Annex-Engineering/Masherbrum-K1/Release_2_2/Images/1800px_k2_r2_render_toolhead_lower.png

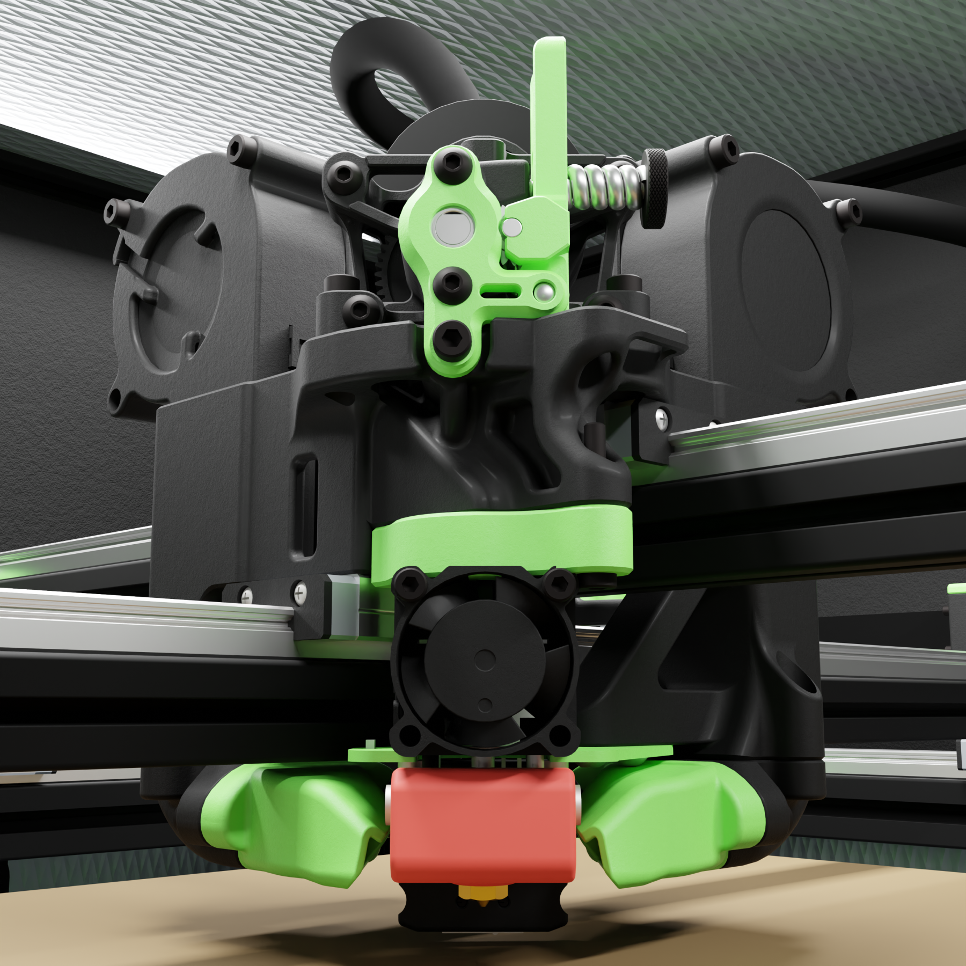
Release_2_2/Images/1800px_k2_r2_render_toolhead_lower.png
