Annex-Engineering/Masherbrum-K1/README.md

# Masherbrum (K1) Printer

## Please Note: As of 04-09-2024, The Final Release of K1 is: Release 3 for XY Gantry and Release 2.2 for Z Drive, What you See is What you Get

## Info:
Project Masherbrum (K1 for short) is a Medium Format, Direct Drive, Fully Enclosed FDM Printer.

This is an entirely scratch design, based on the efforts of the "Hypercube Overkill Project" for the XY Motion System, and inspired by all other prior repraps.

Our discord server can be found here: 

Join me on Discord (https://discord.gg/MzTR3zE)

BOM/Sourcing Guide for a 250x250x250 Build can be found here: https://docs.google.com/spreadsheets/d/1O3eyVuQ6M4F03MJSDs4Z71_XyNjXL5HFTZr1jsaAtRc/edit?usp=sharing

Frame Calculator: https://docs.google.com/spreadsheets/d/1OafYgwpRugKy69tp4yEFCRedxJVDkKtnEzjKQJuyjoY/edit?usp=sharing

## Stats:
- Fully Enclosed Design
- 2020, 2040, and 4040 Frame Members
- Insulated Build Chamber (Not Heated)
- Build Volumes of ~200^3 to 500^3 (use of whole plate available) + additional area to purge and wipe
     - Z can theoretically be 1m tall, just not fully supported or tested

- Direct Drive Extruder (Sherpa Mini)

- Shortest Belt Paths Possible, 4 Motors, 2 Per X, 2 Per Y Axis
- Moving Gantry, Fixed Bed

- MGN12H Rails for XY Stationary Rails
- MGN15H Rails for XY Cross (Moving Members)
- MGN15H Rails for Z
- Laser cut and machined metal parts throughout for stiffness and strength (steel recommended in most places, aluminum on moving components)
- 20mm 2GT Belts on XY Motion 
- 20mm 2GT Belts with 20:1 Worm Drive on Z to lift the Bed 
- Heavy Duty Bearings
- NEMA17 Motors XYZ

- Minimal Printed Parts (ASA Required, PC Recommended for motion components)

- Fysetc Spider or S6 Controller + BTT Expander Board with Klipper Required
- Mosquito Style, Dragon Style, Mosquito Magnum+, Nitram's VolcoMosquito, and many other hotends supported
- 24V Power Standard, 48V Optional and Preferred
- Mains Bed
