Annex-Engineering/Masherbrum-K1/Release_1.2/README.md

# Masherbrum (K1) Printer

These parts are purely pre-release at this point, please use with caution.

use tab 2 on the frame calculator for this release, please use discord for support
