Annex-Engineering/Masherbrum-K1/Release_2_2/Images/K1_ISO_CAD_1.PNG

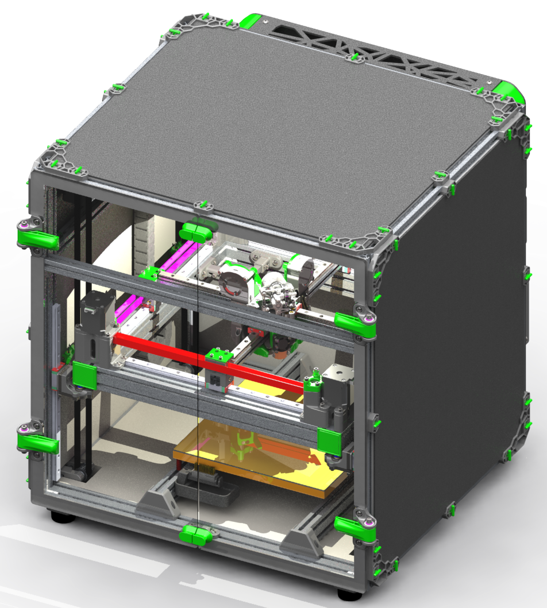
Release_2_2/Images/K1_ISO_CAD_1.PNG
