Annex-Engineering/Masherbrum-K1/Release_3_0/DXFs/Toolhead/toolhead_main_plate_sherpa_mini_x2_rev4_2mm_aluminum.DXF

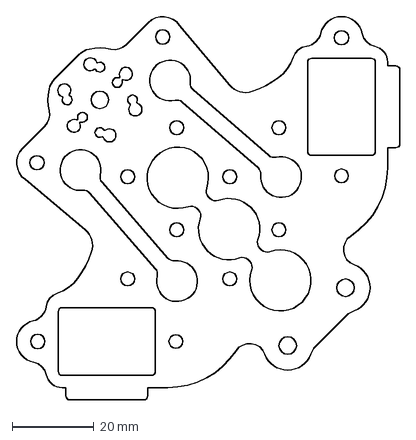
[picture p4: CAD file, 2023-02-20]
Release_3_0/DXFs/Toolhead/toolhead_main_plate_sherpa_mini_x2_rev4_2mm_aluminum.DXF
93.9 x 93.9 mm
