Annex-Engineering/Masherbrum-K1/Release_3_0/STLs/Electronics_Box/electronics_box_corner_mains_inlet_x1_rev4.STL

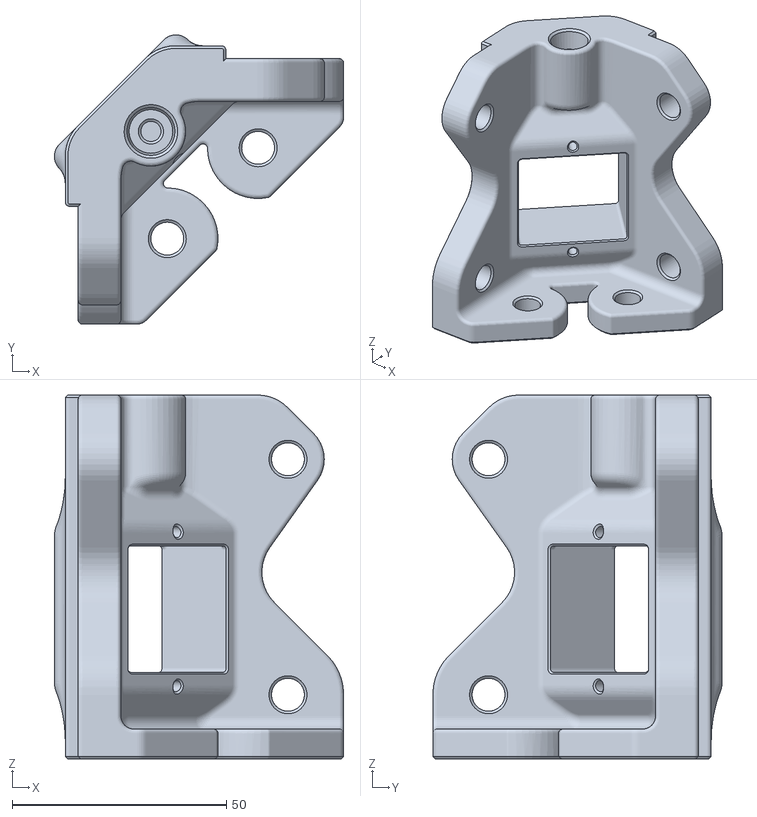
[picture p5: CAD file, 2022-12-18]
Release_3_0/STLs/Electronics_Box/electronics_box_corner_mains_inlet_x1_rev4.STL
67.6 x 67.6 x 85.0
