Annex-Engineering/Masherbrum-K1/Release_3_0/DXFs/15mm_3HTD_Belted_Z_Drive/3mm_stainless_z_bearing_block_main_plate_x4_rev1.DXF

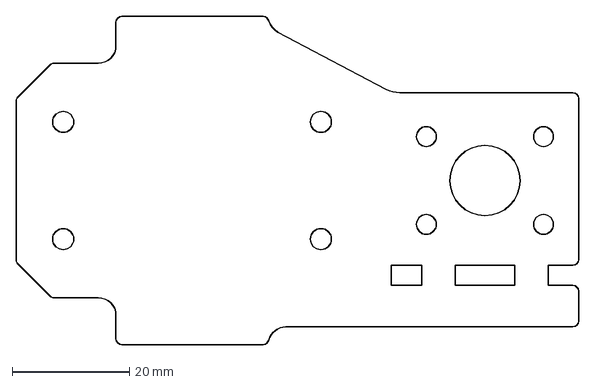
[picture p6: CAD file, 2021-10-04]
Release_3_0/DXFs/15mm_3HTD_Belted_Z_Drive/3mm_stainless_z_bearing_block_main_plate_x4_rev1.DXF
96.0 x 56.0 mm
