Annex-Engineering/Masherbrum-K1/Release_3_0/DXFs/15mm_3HTD_Belted_Z_Drive/4.8mm_aluminum_z_bearing_block_main_plate_x4_rev1.DXF

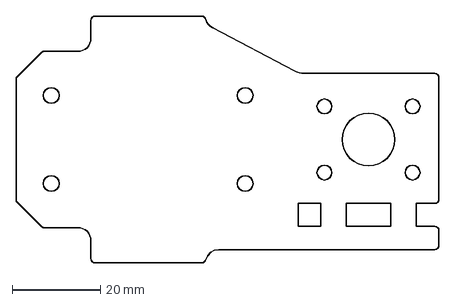
[picture p7: CAD file, 2021-08-31]
Release_3_0/DXFs/15mm_3HTD_Belted_Z_Drive/4.8mm_aluminum_z_bearing_block_main_plate_x4_rev1.DXF
96.0 x 56.0 mm
