Annex-Engineering/Masherbrum-K1/DXFs/Panels/Back_Panel_400mm_x_400mm_x_600mm_Rev1.DXF

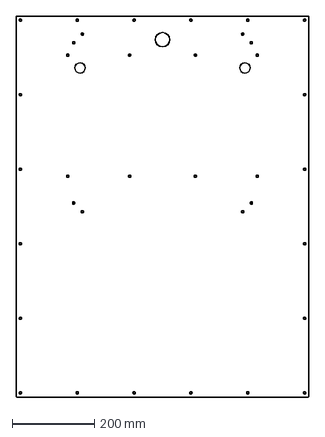
[picture p8: CAD file, 2020-07-09]
DXFs/Panels/Back_Panel_400mm_x_400mm_x_600mm_Rev1.DXF
710.0 x 925.0 mm
