Annex-Engineering/Masherbrum-K1/DXFs/Skirts/Side_Skirt_250mm_x2_Rev3.DXF

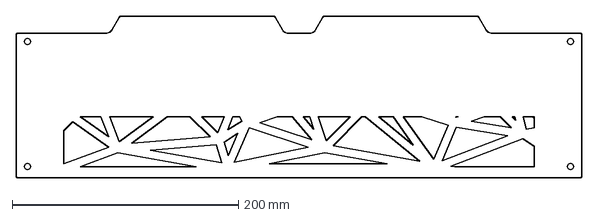
[picture p9: CAD file, 2020-03-29]
DXFs/Skirts/Side_Skirt_250mm_x2_Rev3.DXF
500.0 x 143.0 mm
