Annex-Engineering/Masherbrum-K1/Release_1.2/DXFs/Doors/Triple_Hinge/Front_Door_400mm_x2_Rev2.DXF

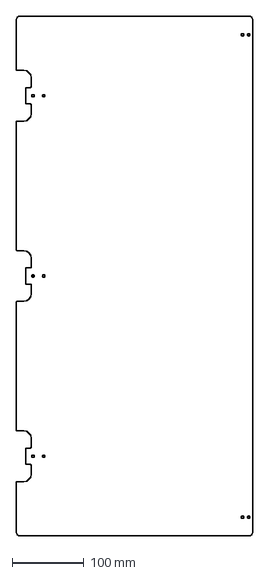
[picture p11: CAD file, 2021-01-07]
Release_1.2/DXFs/Doors/Triple_Hinge/Front_Door_400mm_x2_Rev2.DXF
329.5 x 725.0 mm
