Annex-Engineering/Masherbrum-K1/Release_1.2/STLs/Mesh_Bed_Probe/Magnetic_Probe/magnetic_probe_dock_x1_rev5.STL

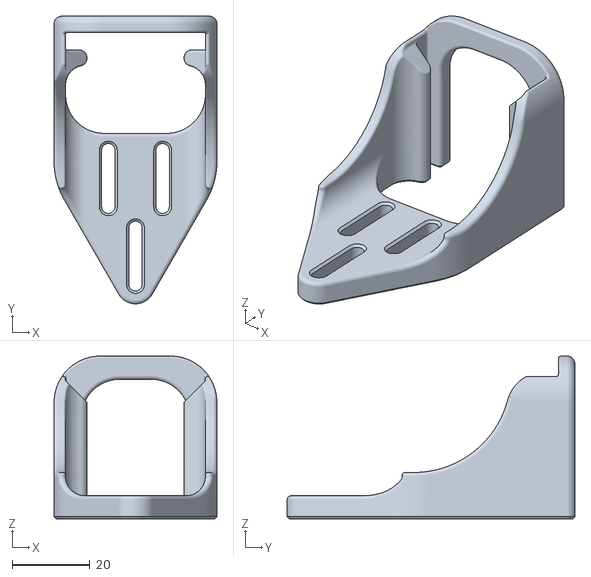
[picture p12: CAD file, 2020-08-14]
Release_1.2/STLs/Mesh_Bed_Probe/Magnetic_Probe/magnetic_probe_dock_x1_rev5.STL
42.0 x 74.1 x 42.0
