Annex-Engineering/Masherbrum-K1/Release_1.2/STLs/Mesh_Bed_Probe/Piton_Probe/[a]_piton_probe_plate_6x3_x1_rev2.STL

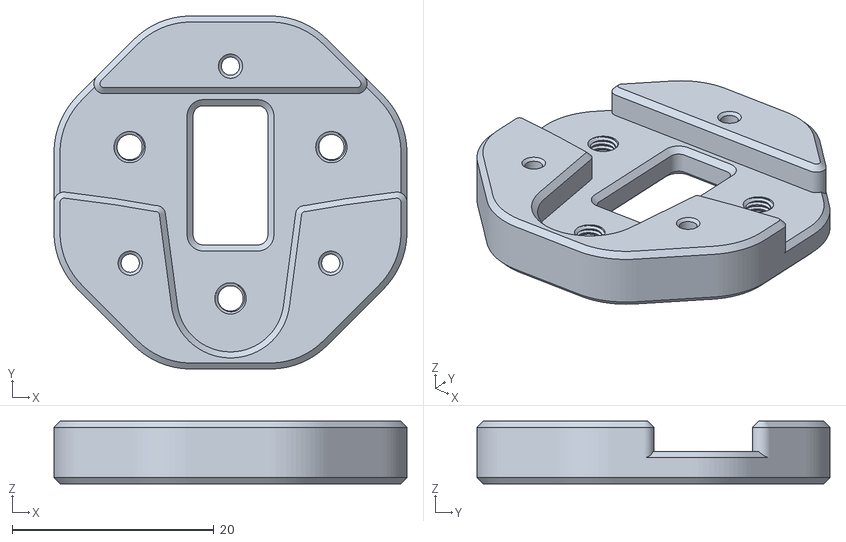
[picture p13: CAD file, 2020-11-18]
Release_1.2/STLs/Mesh_Bed_Probe/Piton_Probe/[a]_piton_probe_plate_6x3_x1_rev2.STL
35.0 x 35.0 x 6.20
