Annex-Engineering/Masherbrum-K1/Release_1.2/STLs/Misc/z_endstop_housing_x1_rev1.STL

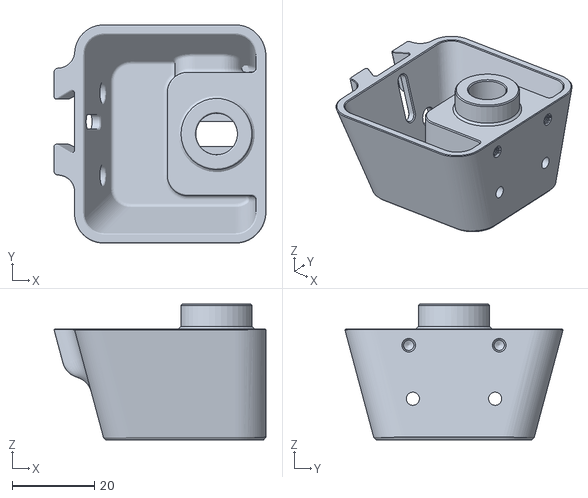
[picture p14: CAD file, 2020-05-19]
Release_1.2/STLs/Misc/z_endstop_housing_x1_rev1.STL
51.5 x 53.1 x 33.0
