Annex-Engineering/Masherbrum-K1/Release_1.2/STLs/XY_Carriage/Tool_Mounts/xy_carriage_mosquito_tool_mount_x1_rev3.STL

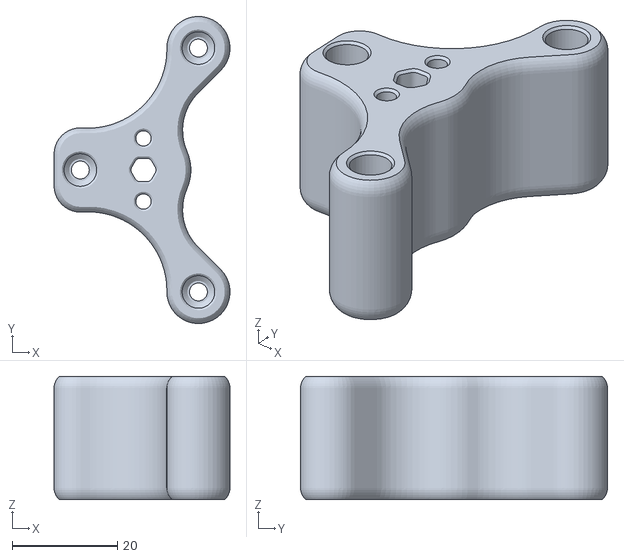
[picture p15: CAD file, 2020-04-10]
Release_1.2/STLs/XY_Carriage/Tool_Mounts/xy_carriage_mosquito_tool_mount_x1_rev3.STL
33.4 x 58.3 x 23.4
