Annex-Engineering/Masherbrum-K1/Release_1.2/STLs/XY_Carriage/Top_Plates/sherpa_tall_xy_carriage_top_plate_x1_rev1.STL

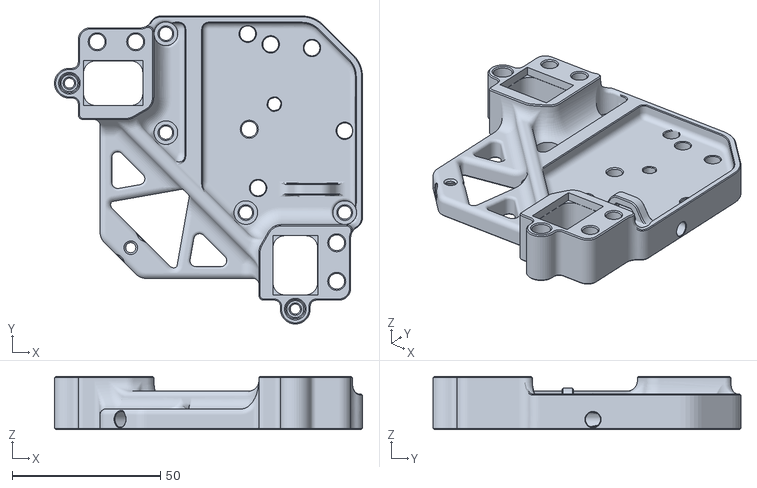
[picture p16: CAD file, 2020-07-09]
Release_1.2/STLs/XY_Carriage/Top_Plates/sherpa_tall_xy_carriage_top_plate_x1_rev1.STL
104.0 x 104.0 x 18.0
