Annex-Engineering/Masherbrum-K1/Release_1.2/STLs/XY_Carriage/xy_carriage_piton_probe_holder_mosquito_x1_rev3.STL

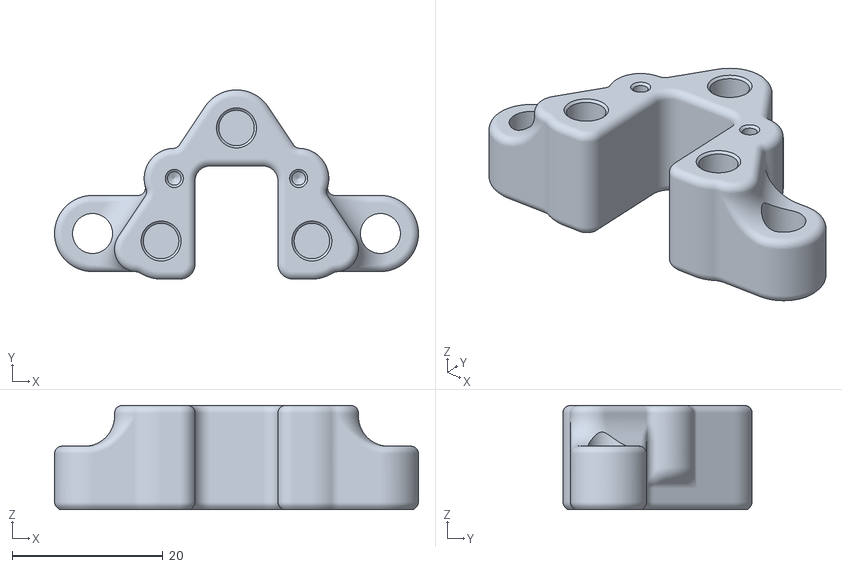
[picture p17: CAD file, 2020-11-18]
Release_1.2/STLs/XY_Carriage/xy_carriage_piton_probe_holder_mosquito_x1_rev3.STL
48.3 x 25.1 x 13.8
