Annex-Engineering/Masherbrum-K1/Release_1.2/STLs/XY_Gantry/xy_tensioner_left_20t_drive_x4_rev3.STL

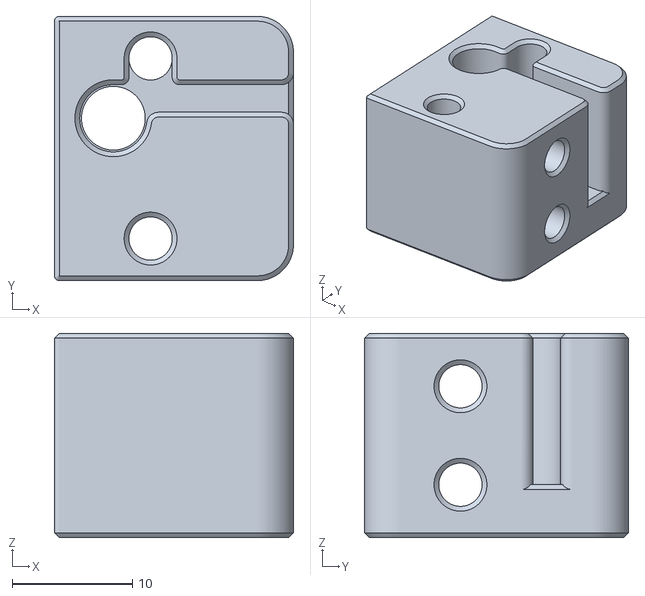
[picture p18: CAD file, 2020-10-04]
Release_1.2/STLs/XY_Gantry/xy_tensioner_left_20t_drive_x4_rev3.STL
19.9 x 22.0 x 17.0
