Annex-Engineering/Masherbrum-K1/Release_2/STLs/Electronics_Brackets/bigtreetech_skr_mounting_bracket_x2_rev4.STL

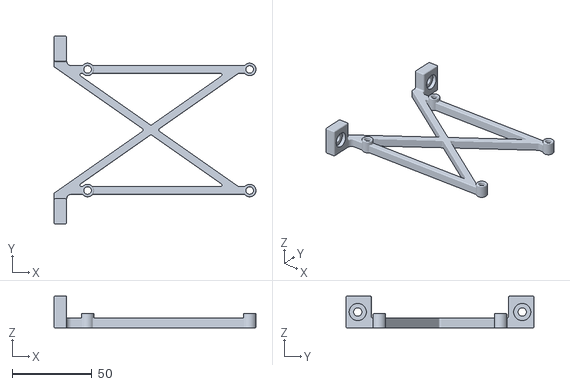
[picture p19: CAD file, 2021-05-18]
Release_2/STLs/Electronics_Brackets/bigtreetech_skr_mounting_bracket_x2_rev4.STL
127.0 x 118.3 x 20.0
