Annex-Engineering/Masherbrum-K1/Release_2_1/DXFs/15mm_3HTD_Belted_Z_Drive/3mm_stainless_belted_worm_z_metal_top_60to1_x4_rev2.DXF

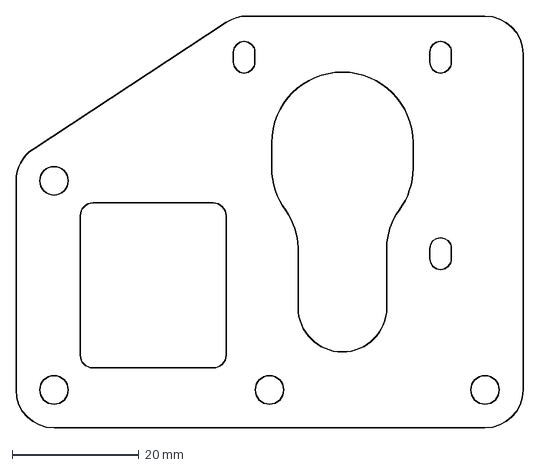
[picture p20: CAD file, 2022-01-22]
Release_2_1/DXFs/15mm_3HTD_Belted_Z_Drive/3mm_stainless_belted_worm_z_metal_top_60to1_x4_rev2.DXF
80.0 x 65.0 mm
