Annex-Engineering/Masherbrum-K1/Release_2_2/STLs/XY_Carriage/[a]_xy_carriage_fan_mount_1_x1_rev3.STL

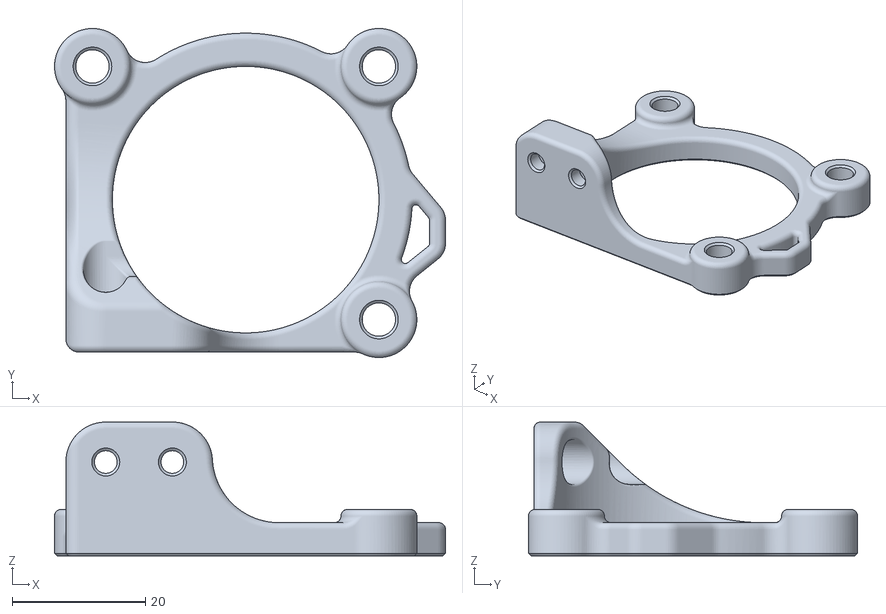
[picture p21: CAD file, 2021-07-12]
Release_2_2/STLs/XY_Carriage/[a]_xy_carriage_fan_mount_1_x1_rev3.STL
58.7 x 49.4 x 20.1
