Annex-Engineering/Masherbrum-K1/Release_2_2/STLs/XY_Carriage/Hotend_Holders/Mosquito_and_Mosquito_Mag+/[a]_xy_carriage_mosquito_tool_mount_x1_rev4.STL

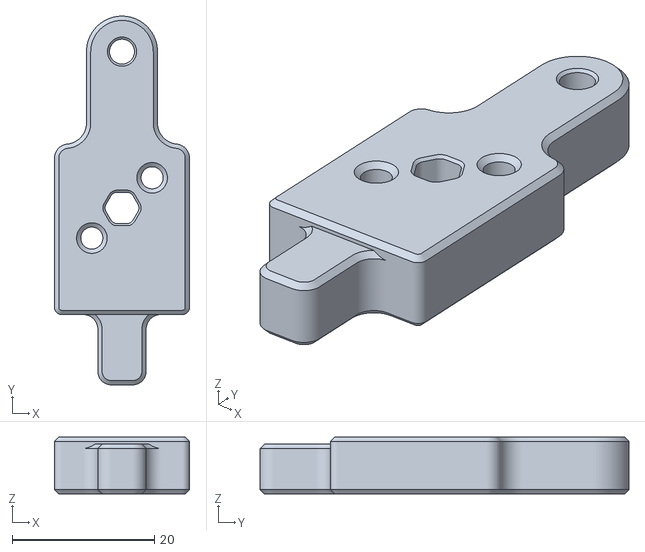
[picture p22: CAD file, 2020-11-21]
Release_2_2/STLs/XY_Carriage/Hotend_Holders/Mosquito_and_Mosquito_Mag+/[a]_xy_carriage_mosquito_tool_mount_x1_rev4.STL
19.0 x 51.9 x 8.00
