Annex-Engineering/Masherbrum-K1/Release_2_2/STLs/XY_Carriage/Hotend_Holders/Rapido_UHF/[a]_xy_carriage_rapido_uhf_tool_mount_x1_rev1.STL

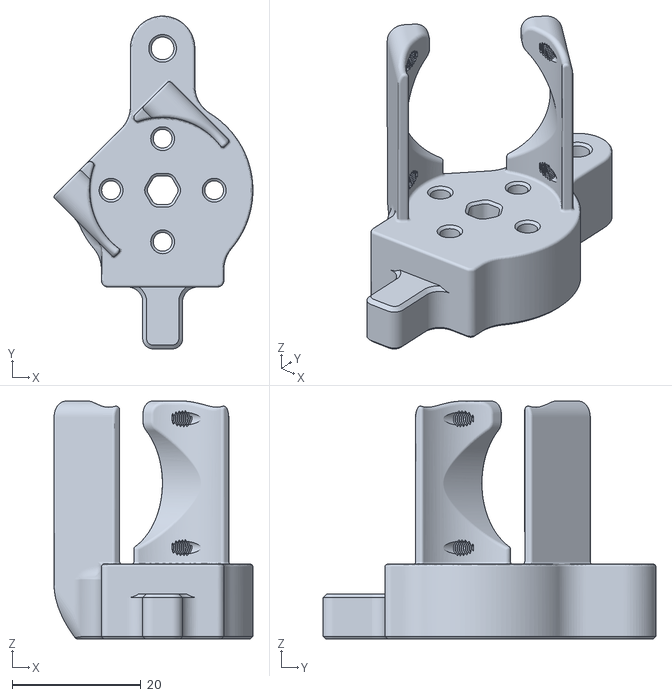
[picture p24: CAD file, 2021-12-29]
Release_2_2/STLs/XY_Carriage/Hotend_Holders/Rapido_UHF/[a]_xy_carriage_rapido_uhf_tool_mount_x1_rev1.STL
30.8 x 51.6 x 36.9
