Annex-Engineering/Masherbrum-K1/Release_2_2/STLs/XY_Carriage/Toolhead_Bottoms/Mosquito_and_Dragon/[a]_xy_carriage_std_fan_duct_1_x1_rev1.STL

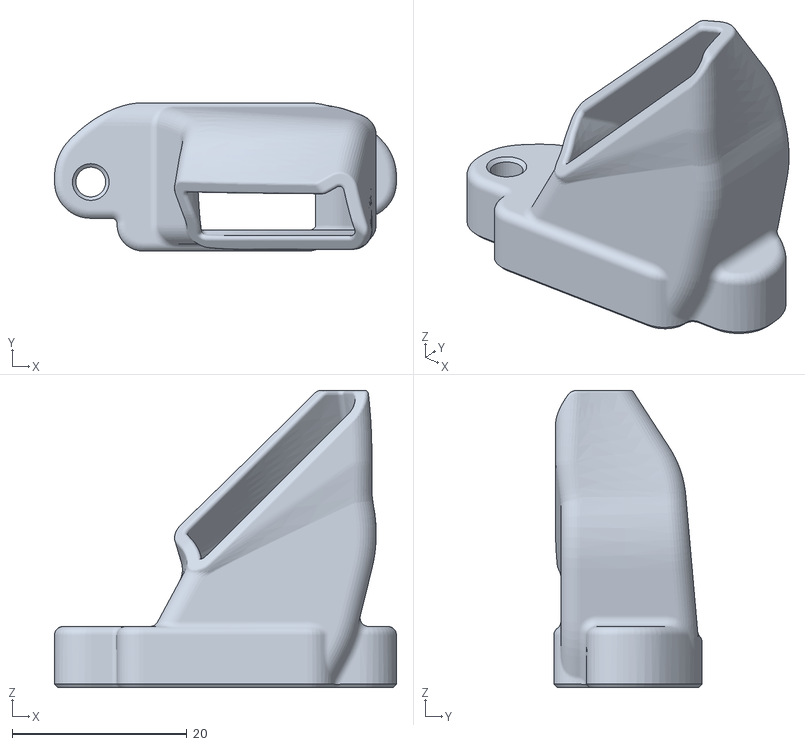
[picture p25: CAD file, 2021-01-26]
Release_2_2/STLs/XY_Carriage/Toolhead_Bottoms/Mosquito_and_Dragon/[a]_xy_carriage_std_fan_duct_1_x1_rev1.STL
39.1 x 17.0 x 34.0
