Annex-Engineering/Masherbrum-K1/Release_2_2/STLs/XY_Carriage/Toolhead_Bottoms/Mosquito_Mag+_and_Rapido_UHF/[a]_xy_carriage_mag+_fan_duct_2_x1_rev2.STL

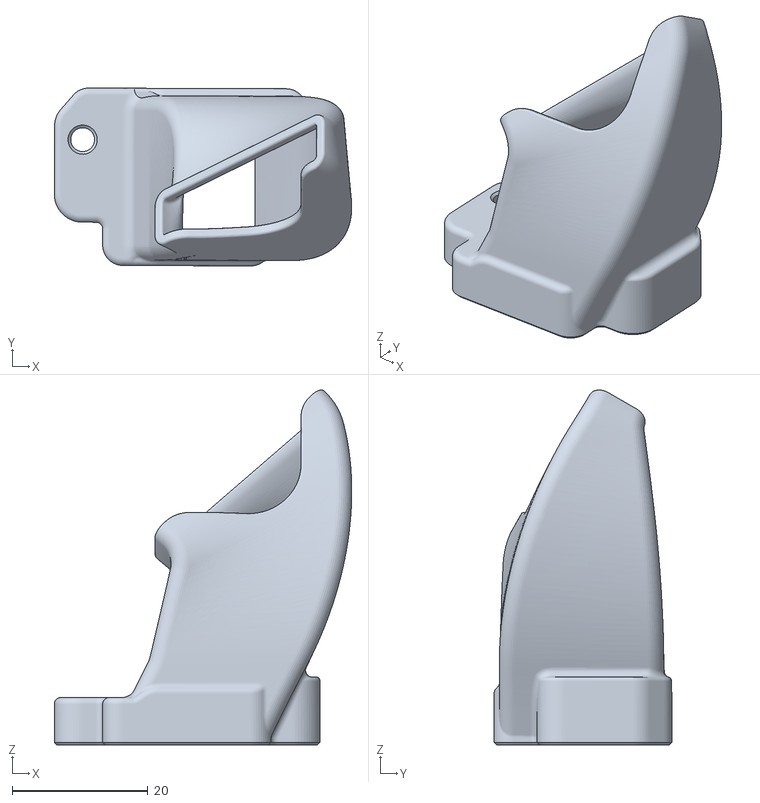
[picture p26: CAD file, 2021-08-19]
Release_2_2/STLs/XY_Carriage/Toolhead_Bottoms/Mosquito_Mag+_and_Rapido_UHF/[a]_xy_carriage_mag+_fan_duct_2_x1_rev2.STL
43.8 x 26.2 x 52.2
