Annex-Engineering/Masherbrum-K1/Release_2_2/STLs/XY_Carriage/Toolhead_Bottoms/VolcoMosquito_and_Rapido_StandardFlow/[a]_xy_carriage_volcomosquito_fan_duct_1_x1_rev1.STL

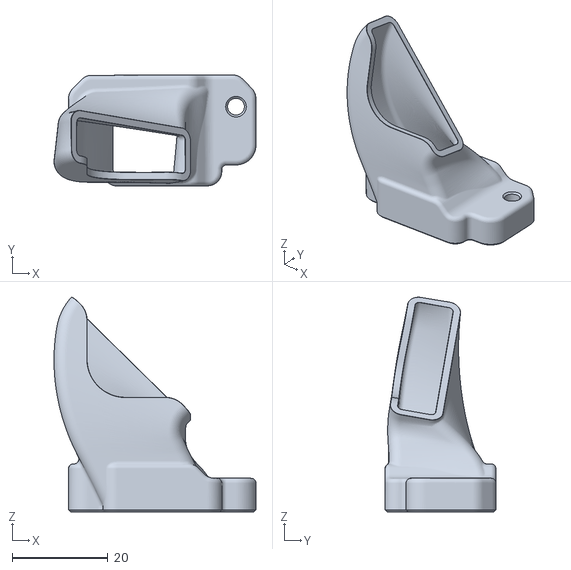
[picture p27: CAD file, 2021-11-27]
Release_2_2/STLs/XY_Carriage/Toolhead_Bottoms/VolcoMosquito_and_Rapido_StandardFlow/[a]_xy_carriage_volcomosquito_fan_duct_1_x1_rev1.STL
42.1 x 23.2 x 44.8
