Annex-Engineering/Masherbrum-K1/Release_2_2/STLs/XY_Gantry/MGN12C_Stationary_Rails/xy_mgn12c_tensioner_right_20t_drive_12mm_belts_x4_rev3.STL

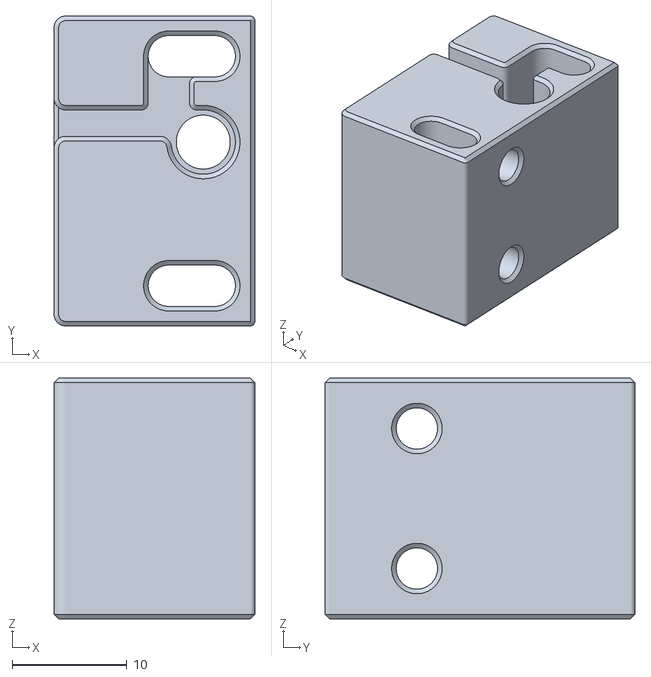
[picture p28: CAD file, 2021-03-03]
Release_2_2/STLs/XY_Gantry/MGN12C_Stationary_Rails/xy_mgn12c_tensioner_right_20t_drive_12mm_belts_x4_rev3.STL
17.5 x 27.0 x 21.0
