Annex-Engineering/Masherbrum-K1/Release_2_2/STLs/XY_Gantry/tall_motor_short_idler_mount_12mm_belts_x2_rev4.STL

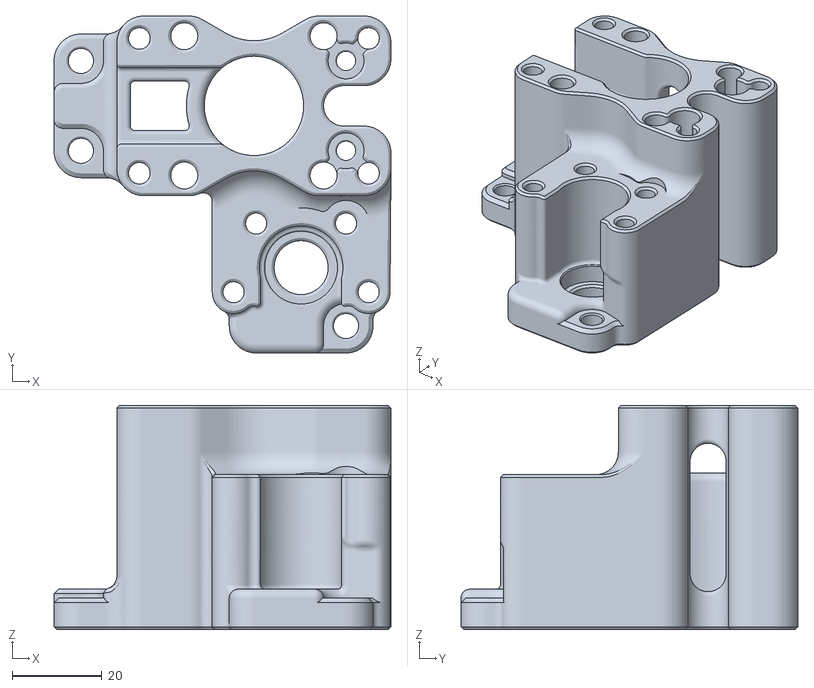
[picture p29: CAD file, 2021-07-18]
Release_2_2/STLs/XY_Gantry/tall_motor_short_idler_mount_12mm_belts_x2_rev4.STL
75.0 x 75.0 x 49.9
