Annex-Engineering/Masherbrum-K1/Release_2_Beta/DXFs/Doors/Double_Hinge/Front_Door_400mm_x2_Rev1.DXF

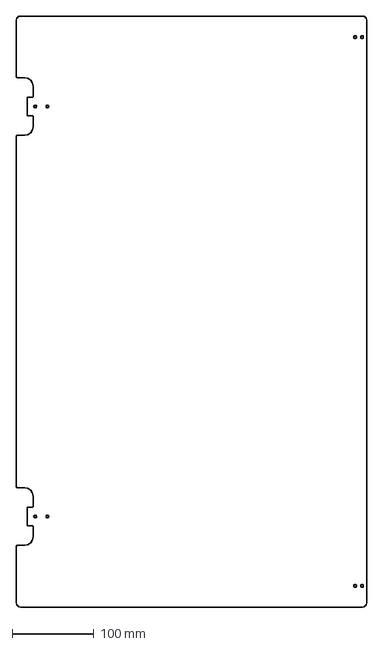
[picture p30: CAD file, 2020-11-09]
Release_2_Beta/DXFs/Doors/Double_Hinge/Front_Door_400mm_x2_Rev1.DXF
429.5 x 725.0 mm
