Annex-Engineering/Masherbrum-K1/Release_2_Beta/DXFs/Doors/Triple_Hinge/Front_Door_250mm_x_250mm_x_300mm_x2_Rev1.DXF

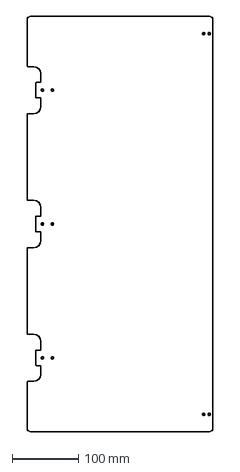
[picture p31: CAD file, 2020-12-31]
Release_2_Beta/DXFs/Doors/Triple_Hinge/Front_Door_250mm_x_250mm_x_300mm_x2_Rev1.DXF
279.5 x 625.0 mm
