Annex-Engineering/Masherbrum-K1/Release_2_Beta/STLs/XY_Carriage/[a]_xy_carriage_fan_mount_1_x1_rev1.STL

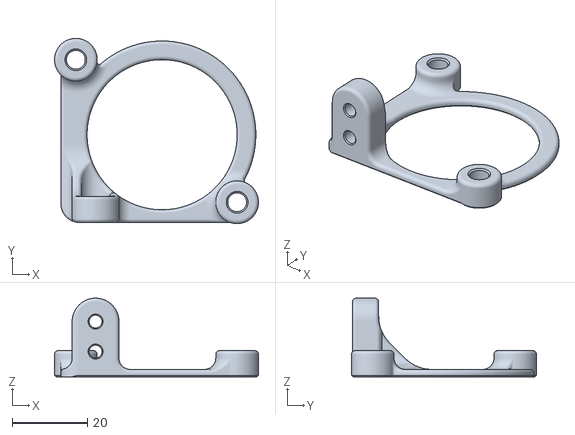
[picture p32: CAD file, 2020-11-21]
Release_2_Beta/STLs/XY_Carriage/[a]_xy_carriage_fan_mount_1_x1_rev1.STL
54.4 x 49.4 x 21.0
