Annex-Engineering/Masherbrum-K1/Release_3_0/DXFs/Doors/Double_Hinge/Front_Door_450mm_x2_Rev2.DXF

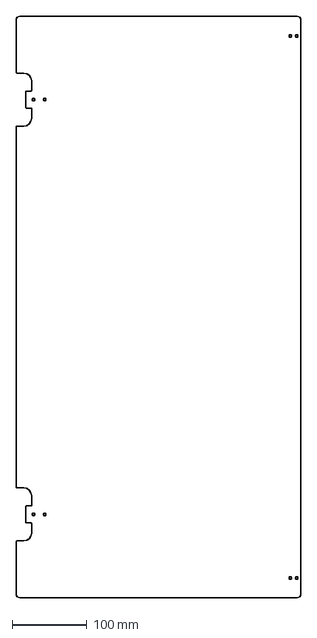
[picture p34: CAD file, 2021-01-11]
Release_3_0/DXFs/Doors/Double_Hinge/Front_Door_450mm_x2_Rev2.DXF
379.5 x 775.0 mm
