Annex-Engineering/Masherbrum-K1/Release_3_0/DXFs/Doors/Triple_Hinge/Front_Door_250mm_x_250mm_x_250mm_x2_Rev3.DXF

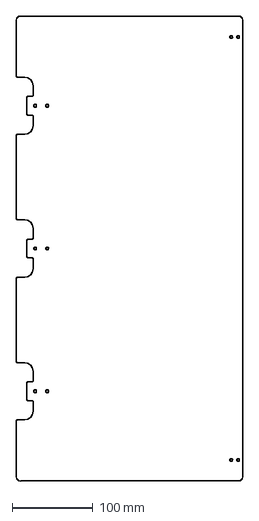
[picture p35: CAD file, 2021-01-11]
Release_3_0/DXFs/Doors/Triple_Hinge/Front_Door_250mm_x_250mm_x_250mm_x2_Rev3.DXF
279.5 x 575.0 mm
