Annex-Engineering/Masherbrum-K1/Release_3_0/DXFs/Doors/Triple_Hinge_with_Graphics/K1_doors_400mm^3_graphic_option_2.DXF

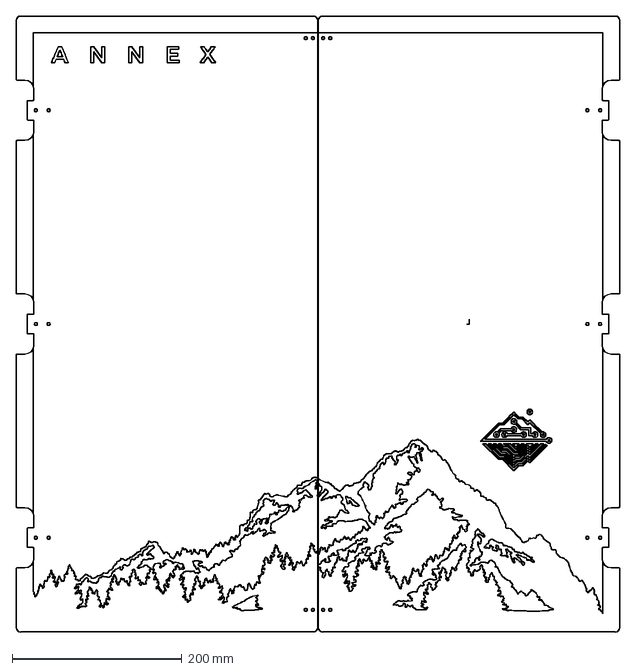
[picture p36: CAD file, 2022-03-22]
Release_3_0/DXFs/Doors/Triple_Hinge_with_Graphics/K1_doors_400mm^3_graphic_option_2.DXF
710.0 x 725.0 mm
