Annex-Engineering/Masherbrum-K1/Release_3_0/DXFs/Electronics_Box/electronics_box_side_structural_panel_x4_rev1.DXF

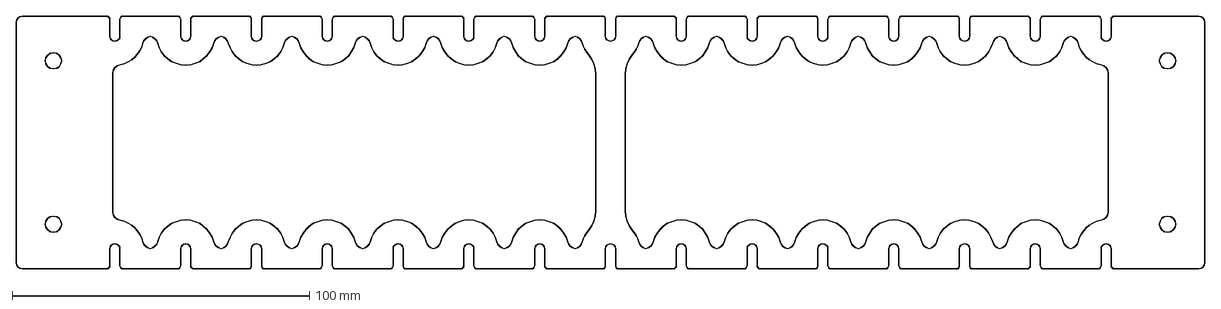
[picture p37: CAD file, 2022-03-02]
Release_3_0/DXFs/Electronics_Box/electronics_box_side_structural_panel_x4_rev1.DXF
400.0 x 85.0 mm
