Annex-Engineering/Masherbrum-K1/Release_3_0/DXFs/Panels/Back_Panel_400x400x600_Rev3.dxf

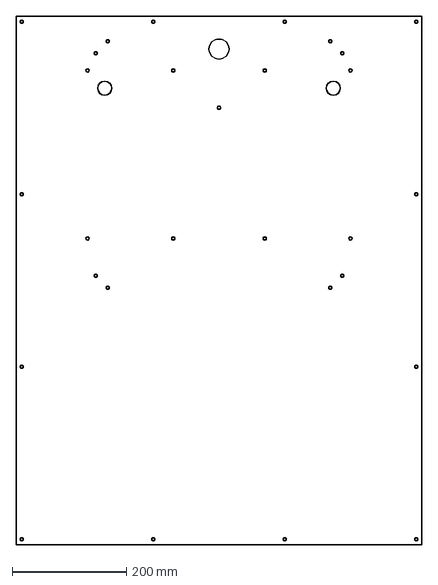
[picture p39: CAD file, 2021-05-25]
Release_3_0/DXFs/Panels/Back_Panel_400x400x600_Rev3.dxf
710.0 x 925.0 mm
