Annex-Engineering/Masherbrum-K1/Release_3_0/DXFs/XY_Gantry/xy_motor_mounting_plate_x4_rev1_2mm_steel.DXF

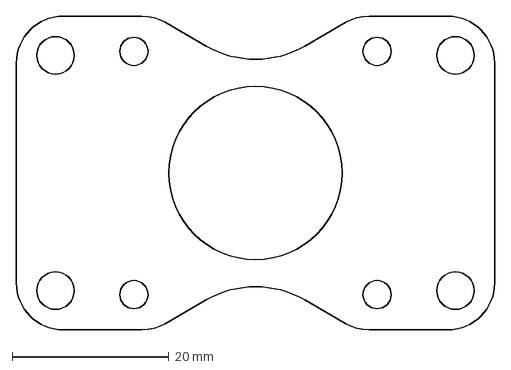
[picture p40: CAD file, 2022-11-29]
Release_3_0/DXFs/XY_Gantry/xy_motor_mounting_plate_x4_rev1_2mm_steel.DXF
61.0 x 40.0 mm
