Annex-Engineering/Masherbrum-K1/Release_3_0/PCBs/K1K2-carabiner-round_heatsink/K1+K2 Carabiner for Mosquito.step

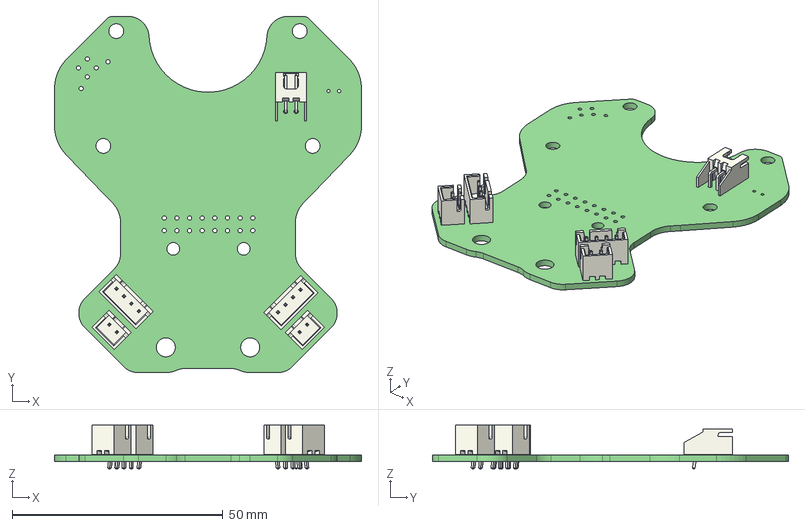
[picture p42: CAD file, 2024-04-17]
Release_3_0/PCBs/K1K2-carabiner-round_heatsink/K1+K2 Carabiner for Mosquito.step
72.8 x 84.5 x 10.4 mm
K1+K2 Carabiner for Round Heatsinks PCB
