Annex-Engineering/Masherbrum-K1/Release_3_0/STLs/Cable_Management/25x40mm_cable_channel_top_140mm_x3_rev2.STL

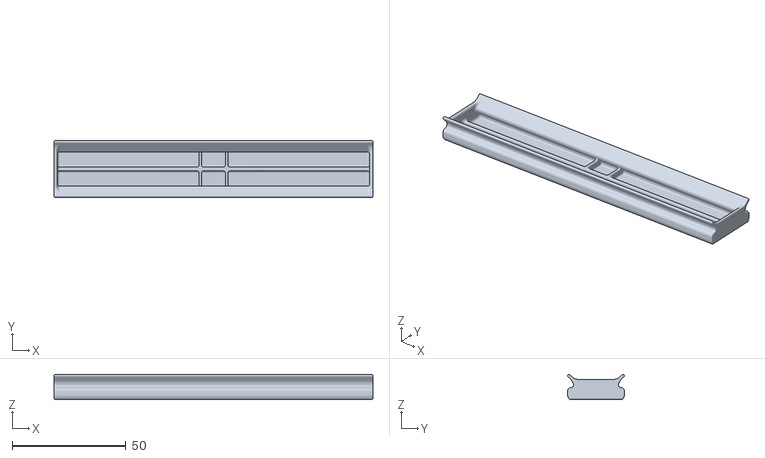
[picture p43: CAD file, 2022-01-19]
Release_3_0/STLs/Cable_Management/25x40mm_cable_channel_top_140mm_x3_rev2.STL
140.0 x 25.0 x 11.0
