Annex-Engineering/Masherbrum-K1/Release_3_0/STLs/Electronics_Brackets/universal_dual_meanwell_uhp_psu_mounting_bracket_b_x1_rev2.STL

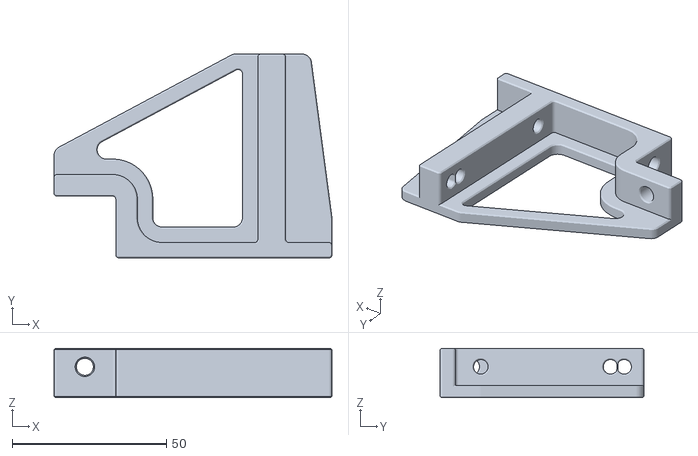
[picture p44: CAD file, 2022-02-16]
Release_3_0/STLs/Electronics_Brackets/universal_dual_meanwell_uhp_psu_mounting_bracket_b_x1_rev2.STL
90.0 x 66.0 x 16.0
