Annex-Engineering/Masherbrum-K1/Release_3_0/STLs/Jigs_and_Fixtures/[a]_1515_mgn12c_drilling_jig_x1_rev3.STL.stl

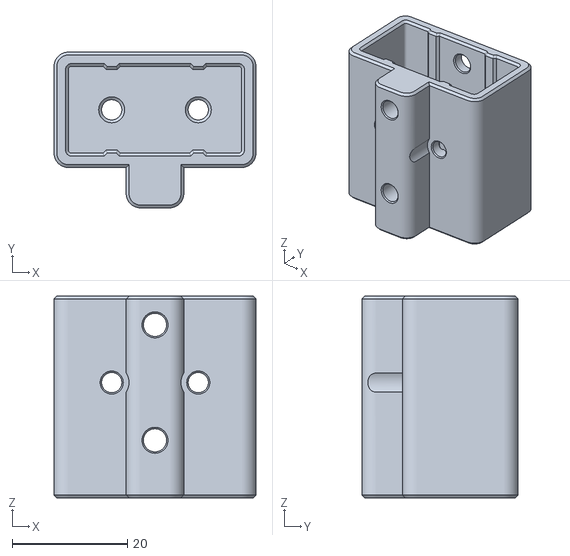
[picture p45: CAD file, 2022-02-08]
Release_3_0/STLs/Jigs_and_Fixtures/[a]_1515_mgn12c_drilling_jig_x1_rev3.STL.stl
35.0 x 27.0 x 35.0
