Annex-Engineering/Masherbrum-K1/Release_3_0/STLs/Misc/Foot_to_frame_bracket_laser_panel_x4_rev1.STL

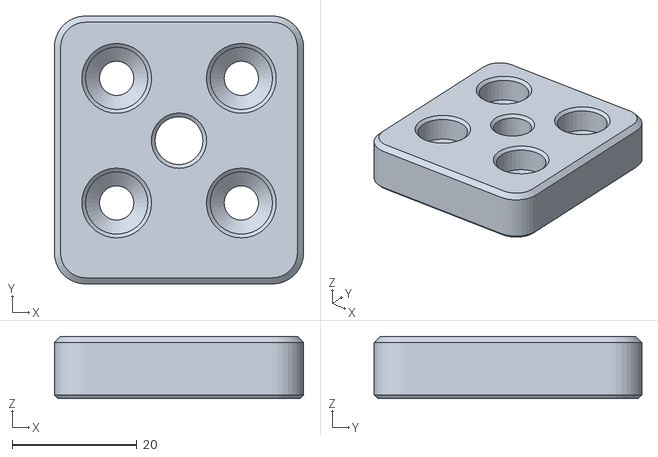
[picture p46: CAD file, 2022-05-06]
Release_3_0/STLs/Misc/Foot_to_frame_bracket_laser_panel_x4_rev1.STL
40.0 x 43.0 x 10.00
