Annex-Engineering/Masherbrum-K1/Release_3_0/STLs/Panel_Mounting/Front_Panel_Hinges_and_Locks/[a]_front_door_arm_x4_rev1.STL

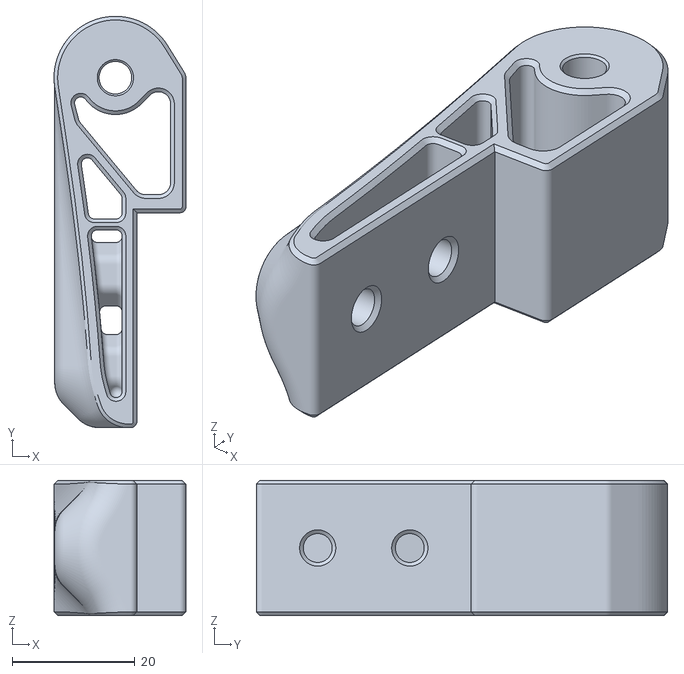
[picture p47: CAD file, 2020-11-09]
Release_3_0/STLs/Panel_Mounting/Front_Panel_Hinges_and_Locks/[a]_front_door_arm_x4_rev1.STL
21.5 x 67.0 x 22.0
