Annex-Engineering/Masherbrum-K1/Release_3_0/STLs/Panel_Mounting/Sides_and_Top_Quick_Release/lock_body_filament_switch_6mm_x1_Rev1.stl

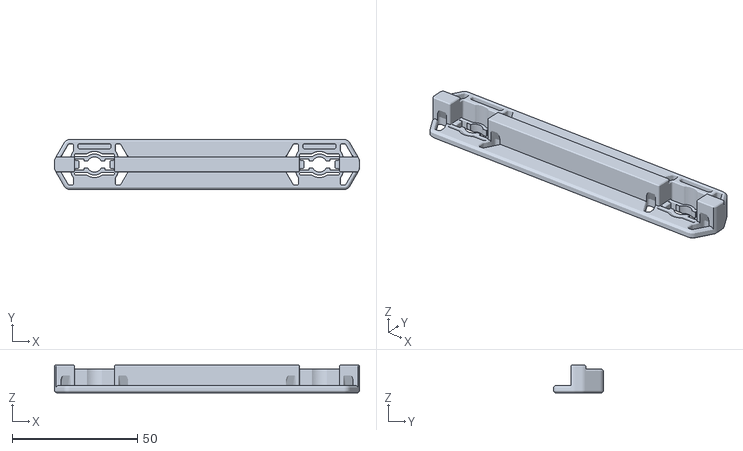
[picture p48: CAD file, 2020-03-01]
Release_3_0/STLs/Panel_Mounting/Sides_and_Top_Quick_Release/lock_body_filament_switch_6mm_x1_Rev1.stl
122.0 x 20.0 x 11.1
