Annex-Engineering/Masherbrum-K1/Release_3_0/STLs/Purge_and_Brush_Bucket/purge_bucket_x1_rev1.STL

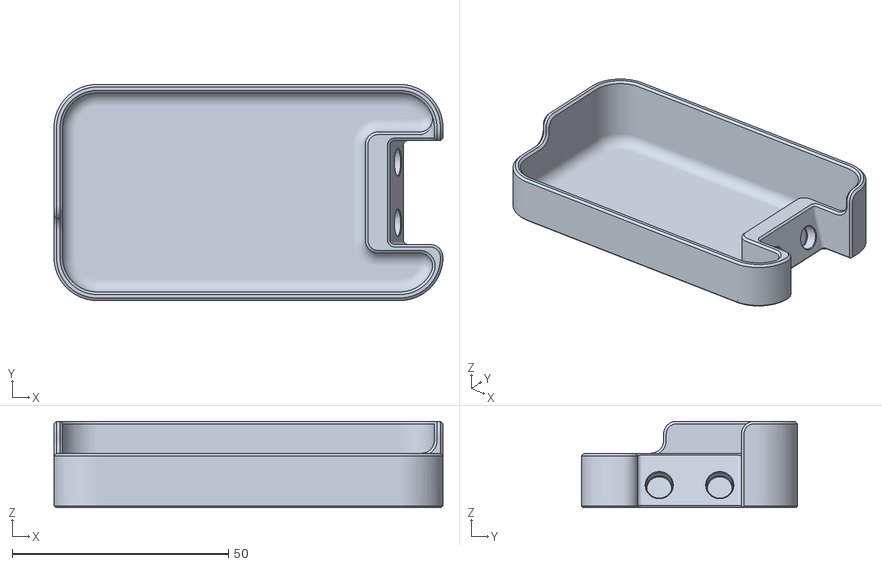
[picture p49: CAD file, 2020-12-21]
Release_3_0/STLs/Purge_and_Brush_Bucket/purge_bucket_x1_rev1.STL
90.0 x 50.0 x 20.0
