Annex-Engineering/Masherbrum-K1/Release_3_0/STLs/sherpa_mini_front_housing_hack_x1_rev1.STL

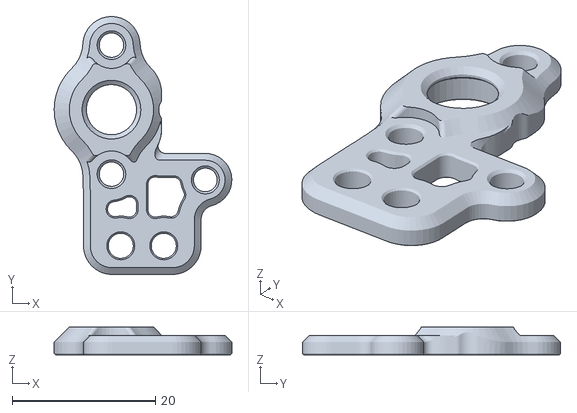
[picture p50: CAD file, 2022-11-29]
Release_3_0/STLs/sherpa_mini_front_housing_hack_x1_rev1.STL
24.8 x 36.0 x 3.90
