Annex-Engineering/Masherbrum-K1/Release_3_0/STLs/XY_Gantry/xy_motor_idler_tower_1a_x2_rev1.STL

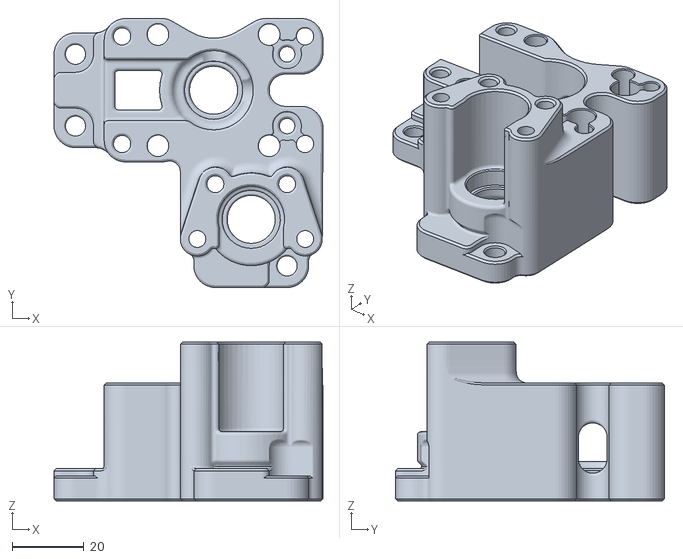
[picture p51: CAD file, 2022-11-29]
Release_3_0/STLs/XY_Gantry/xy_motor_idler_tower_1a_x2_rev1.STL
75.0 x 75.0 x 44.3
