Annex-Engineering/Masherbrum-K1/Release_3_0/STLs/XY_Toolhead/[a]_fan_nozzle_mag+_waterheater_combo_a_x1_rev3.STL

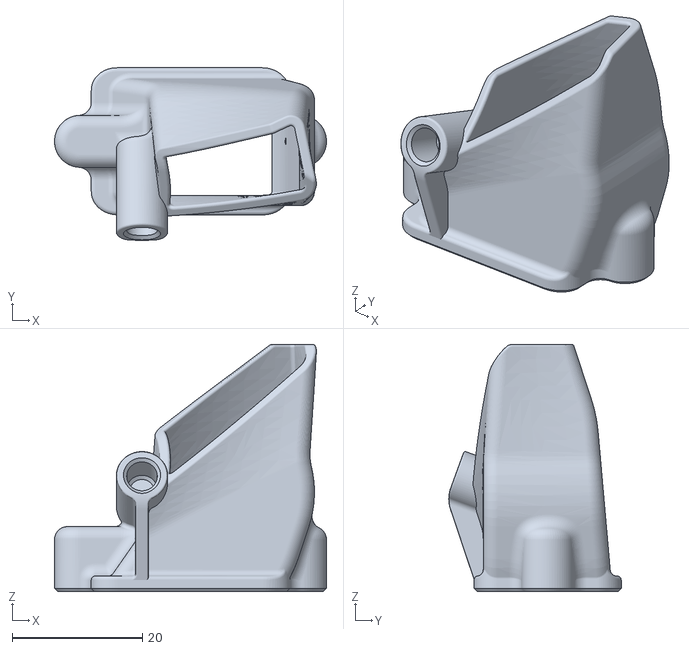
[picture p52: CAD file, 2023-07-05]
Release_3_0/STLs/XY_Toolhead/[a]_fan_nozzle_mag+_waterheater_combo_a_x1_rev3.STL
41.8 x 26.5 x 38.0
