Annex-Engineering/Masherbrum-K1/STLs/XY_Gantry/short_motor_tall_idler_mount_1_x2_rev1.STL

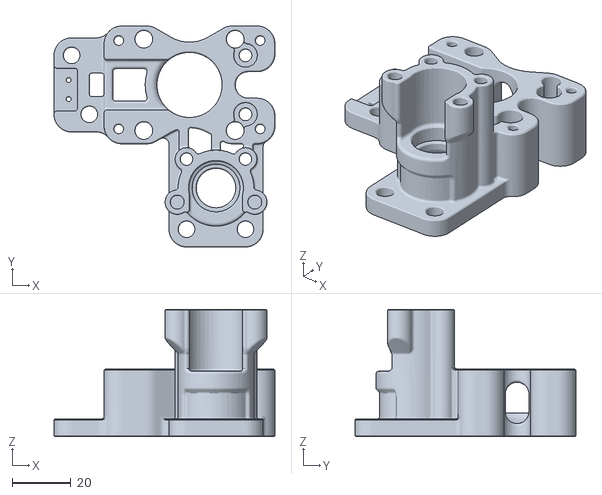
[picture p53: CAD file, 2020-04-03]
STLs/XY_Gantry/short_motor_tall_idler_mount_1_x2_rev1.STL
75.0 x 75.0 x 43.2
