Annex-Engineering/Masherbrum-K1/DXFs/Panels/Back_Panel_400mm_Rev1.DXF

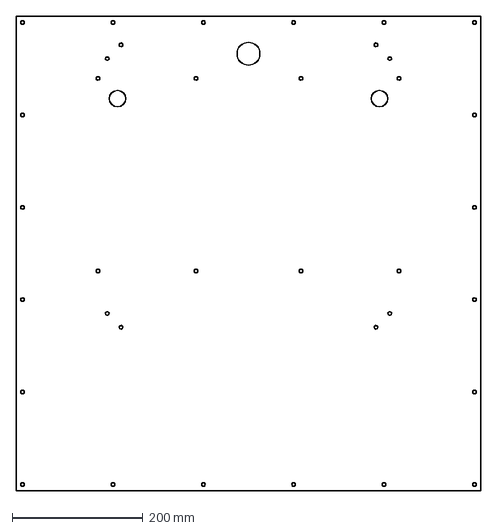
[picture p54: CAD file, 2020-05-08]
DXFs/Panels/Back_Panel_400mm_Rev1.DXF
710.0 x 725.0 mm
