Annex-Engineering/Masherbrum-K1/Release_1.2/DXFs/Doors/Double_Hinge/Front_Door_250mm_x2_Rev2.DXF

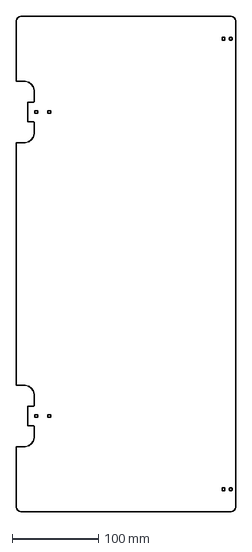
[picture p55: CAD file, 2021-01-07]
Release_1.2/DXFs/Doors/Double_Hinge/Front_Door_250mm_x2_Rev2.DXF
254.5 x 575.0 mm
