Annex-Engineering/Masherbrum-K1/Release_1.2/STLs/Mesh_Bed_Probe/Magnetic_Probe/[a]_xy_carriage_magnetic_probe_microswitch_mount_x1_rev1.STL

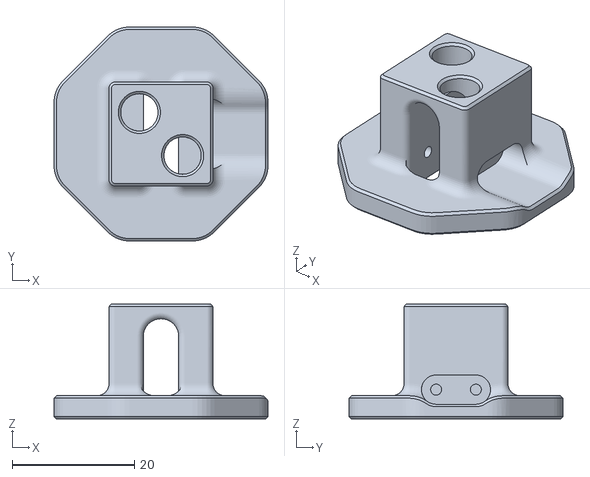
[picture p57: CAD file, 2020-03-17]
Release_1.2/STLs/Mesh_Bed_Probe/Magnetic_Probe/[a]_xy_carriage_magnetic_probe_microswitch_mount_x1_rev1.STL
35.0 x 35.0 x 18.8
