Annex-Engineering/Masherbrum-K1/Release_1.2/STLs/XY_Carriage/Top_Plates/bmg_xy_carriage_top_plate_x1_rev4.STL

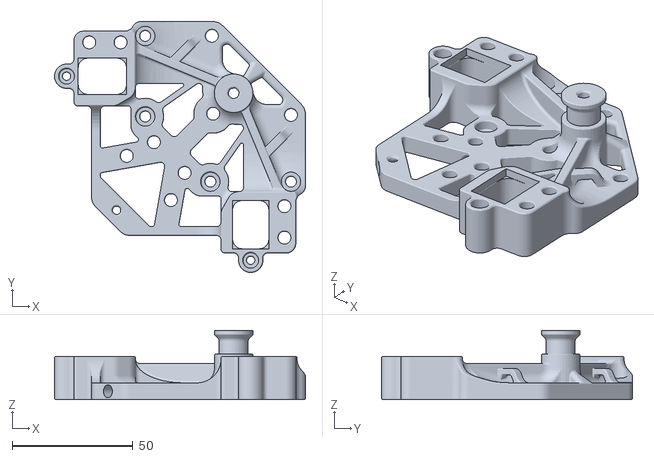
[picture p59: CAD file, 2020-07-07]
Release_1.2/STLs/XY_Carriage/Top_Plates/bmg_xy_carriage_top_plate_x1_rev4.STL
104.0 x 104.0 x 28.8
