Annex-Engineering/Masherbrum-K1/Release_1.2/STLs/XY_Carriage/xy_carriage_piton_6x3_magnet_plate_x1_rev2.STL

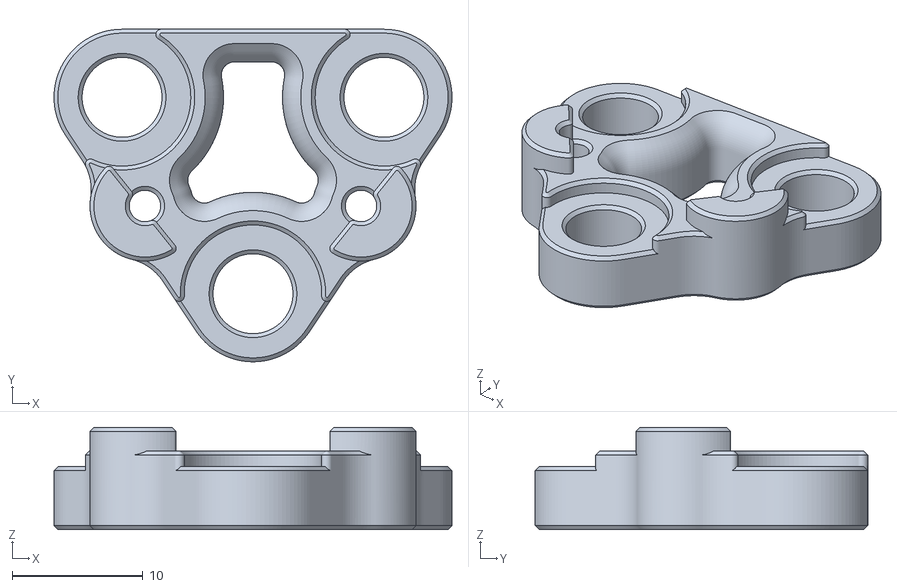
[picture p60: CAD file, 2020-11-18]
Release_1.2/STLs/XY_Carriage/xy_carriage_piton_6x3_magnet_plate_x1_rev2.STL
30.4 x 25.4 x 7.80
