Annex-Engineering/Masherbrum-K1/Release_1.2/STLs/XY_Gantry/xy_tensioner_right_20t_drive_x4_rev5.STL

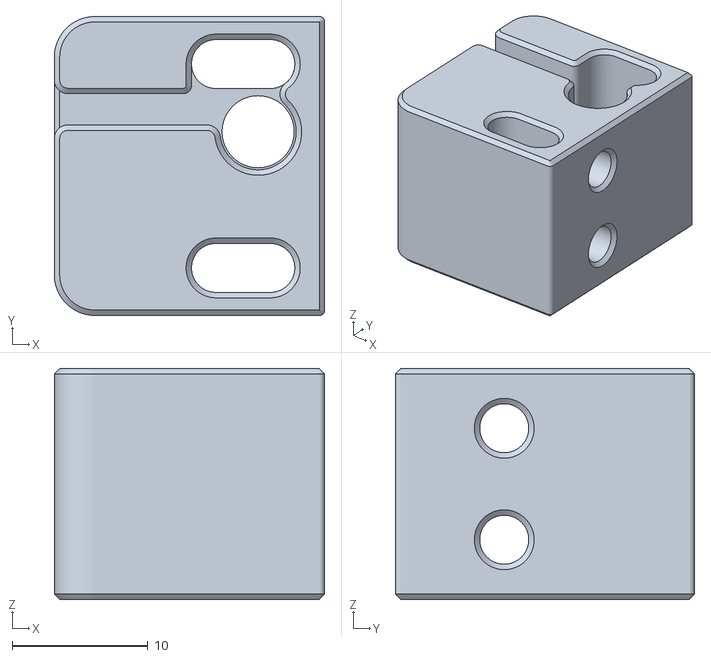
[picture p61: CAD file, 2020-10-04]
Release_1.2/STLs/XY_Gantry/xy_tensioner_right_20t_drive_x4_rev5.STL
19.9 x 22.0 x 17.0
