Annex-Engineering/Masherbrum-K1/Release_2/STLs/Electronics_Brackets/[a]_electronics_box_corner_x4_rev4.STL

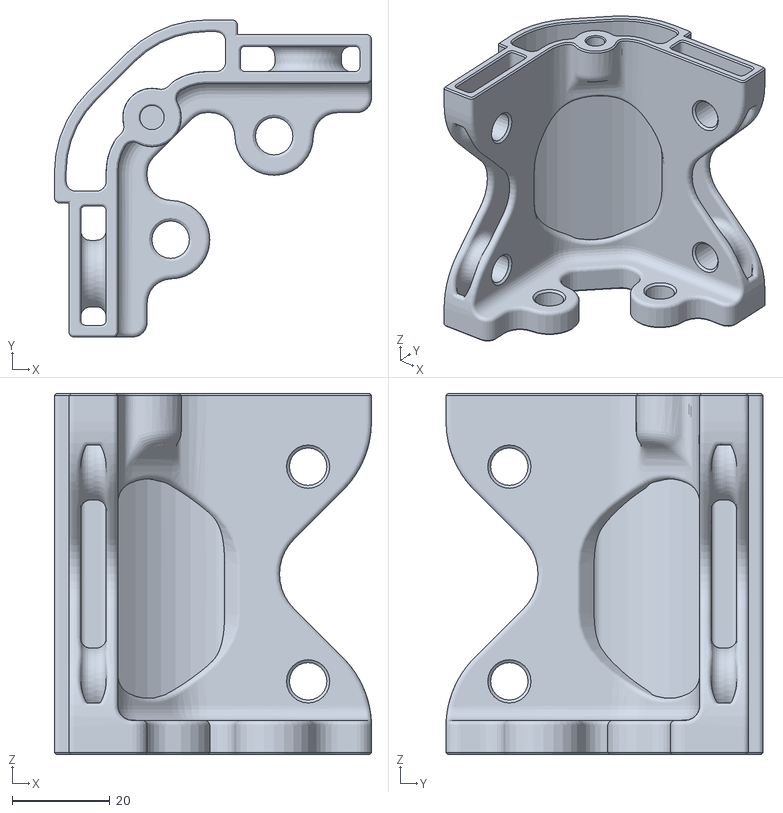
[picture p62: CAD file, 2021-03-17]
Release_2/STLs/Electronics_Brackets/[a]_electronics_box_corner_x4_rev4.STL
65.0 x 65.0 x 74.0
