Annex-Engineering/Masherbrum-K1/Release_2_1/DXFs/15mm_3HTD_Belted_Z_Drive/3mm_stainless_belted_worm_z_metal_bottom_60to1_x4_rev1.DXF

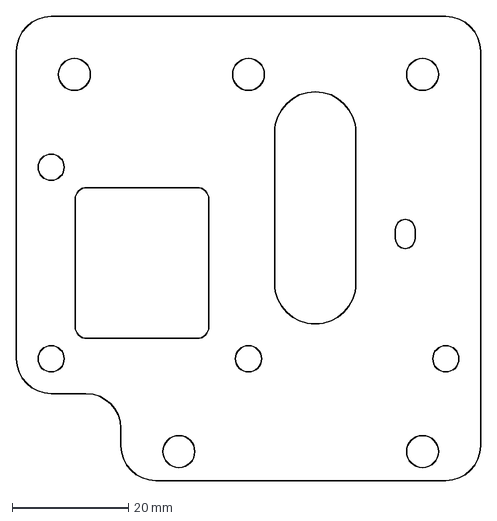
[picture p63: CAD file, 2021-08-31]
Release_2_1/DXFs/15mm_3HTD_Belted_Z_Drive/3mm_stainless_belted_worm_z_metal_bottom_60to1_x4_rev1.DXF
80.0 x 80.0 mm
