Annex-Engineering/Masherbrum-K1/Release_2_2/STLs/XY_Gantry/motor_idler_top_plate_x4_rev3.STL

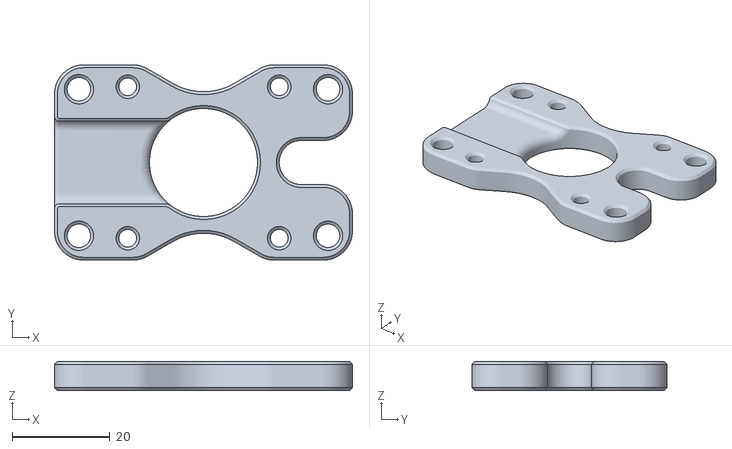
[picture p65: CAD file, 2020-11-21]
Release_2_2/STLs/XY_Gantry/motor_idler_top_plate_x4_rev3.STL
61.0 x 40.0 x 6.00
