Annex-Engineering/Masherbrum-K1/Release_2_Beta/DXFs/Doors/Double_Hinge/Front_Door_350mm_x2_Rev1.DXF

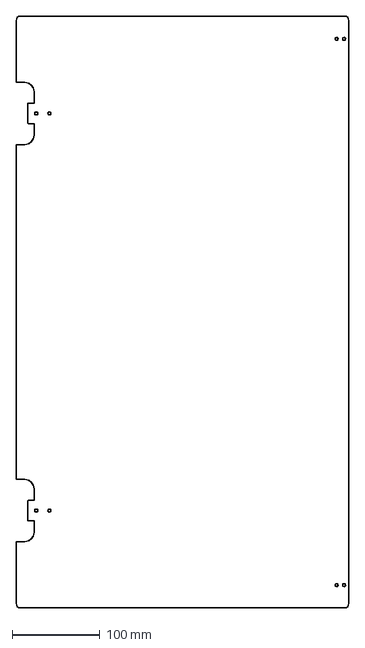
[picture p66: CAD file, 2020-11-09]
Release_2_Beta/DXFs/Doors/Double_Hinge/Front_Door_350mm_x2_Rev1.DXF
379.5 x 675.0 mm
