Annex-Engineering/Masherbrum-K1/Release_2_Beta/DXFs/Doors/Triple_Hinge/Front_Door_200mm_x2_Rev1.DXF

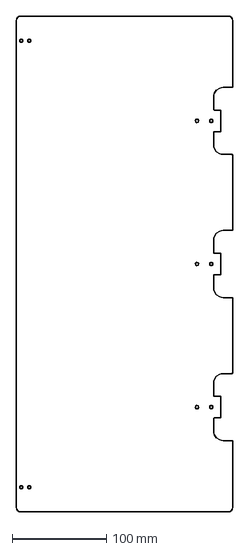
[picture p67: CAD file, 2020-11-17]
Release_2_Beta/DXFs/Doors/Triple_Hinge/Front_Door_200mm_x2_Rev1.DXF
229.5 x 525.0 mm
