Annex-Engineering/Masherbrum-K1/Release_3_0/DXFs/15mm_3HTD_Belted_Z_Drive/3mm_stainless_belted_worm_z_metal_bottom_60to1_x4_rev2.DXF

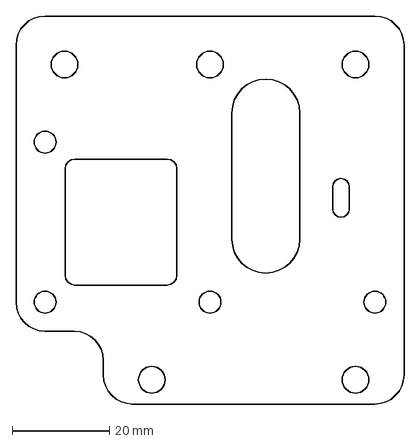
[picture p68: CAD file, 2022-04-20]
Release_3_0/DXFs/15mm_3HTD_Belted_Z_Drive/3mm_stainless_belted_worm_z_metal_bottom_60to1_x4_rev2.DXF
80.0 x 80.0 mm
