Annex-Engineering/Masherbrum-K1/Release_3_0/DXFs/Doors/Double_Hinge/Front_Door_350mm_x2_Rev3.DXF

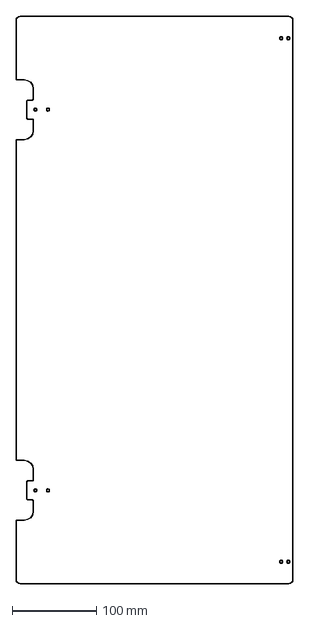
[picture p69: CAD file, 2021-01-11]
Release_3_0/DXFs/Doors/Double_Hinge/Front_Door_350mm_x2_Rev3.DXF
329.5 x 675.0 mm
