Annex-Engineering/Masherbrum-K1/Release_3_0/DXFs/Doors/Triple_Hinge/Front_Door_500mm_x2_Rev2.DXF

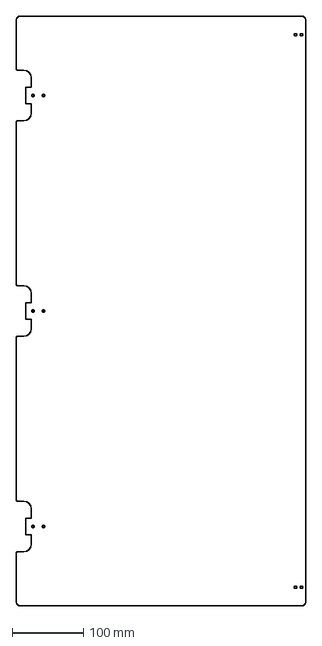
[picture p70: CAD file, 2021-01-11]
Release_3_0/DXFs/Doors/Triple_Hinge/Front_Door_500mm_x2_Rev2.DXF
404.5 x 825.0 mm
