Annex-Engineering/Masherbrum-K1/Release_3_0/DXFs/Doors/Triple_Hinge_with_Graphics/K1_doors_300mm^3_graphic_option_1.DXF

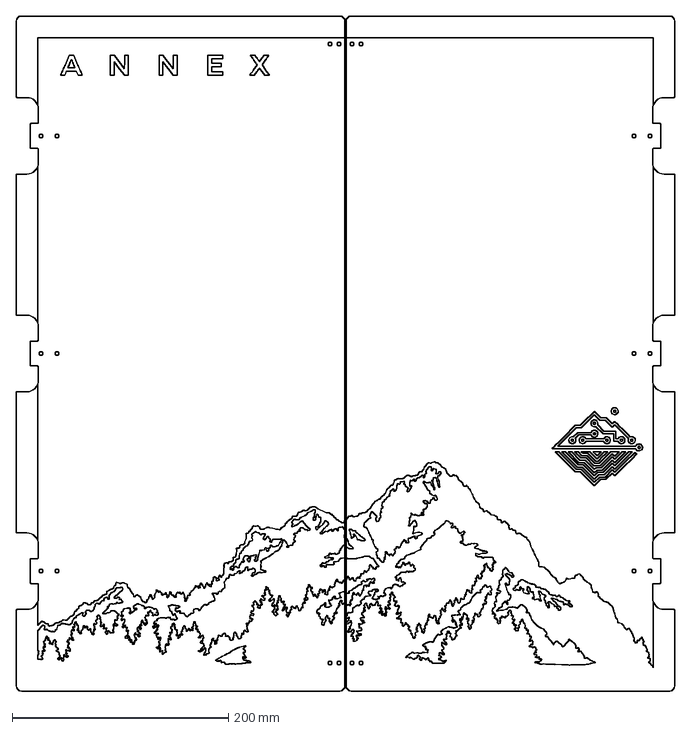
[picture p71: CAD file, 2021-02-03]
Release_3_0/DXFs/Doors/Triple_Hinge_with_Graphics/K1_doors_300mm^3_graphic_option_1.DXF
610.0 x 625.0 mm
