Annex-Engineering/Masherbrum-K1/Release_3_0/DXFs/Electronics_Box/electronics_box_cover_x1_rev3.DXF

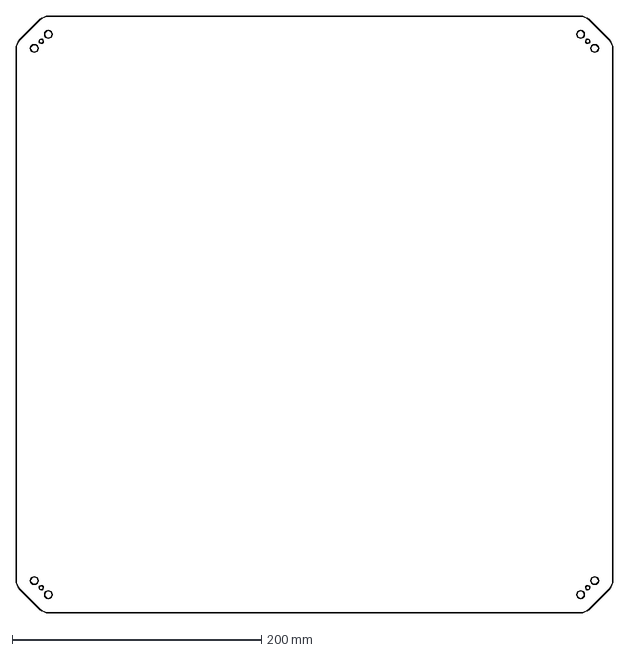
[picture p72: CAD file, 2022-02-26]
Release_3_0/DXFs/Electronics_Box/electronics_box_cover_x1_rev3.DXF
479.0 x 479.0 mm
