Annex-Engineering/Masherbrum-K1/Release_3_0/DXFs/Optional_Laser_Cut_Panels/Bottom_Panel_450x450_Rev3.dxf

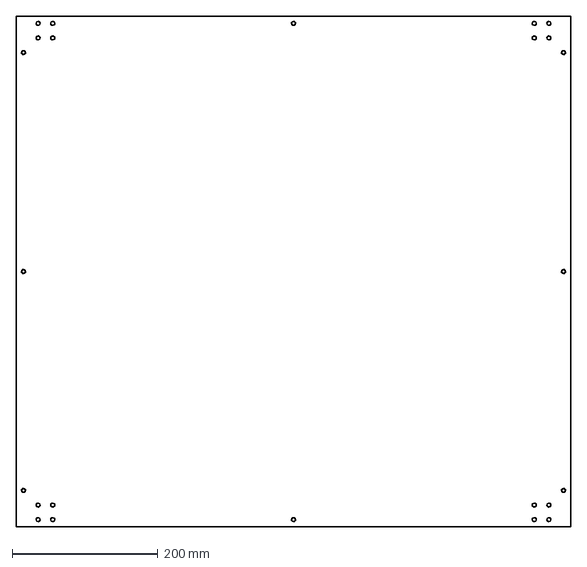
[picture p73: CAD file, 2021-05-25]
Release_3_0/DXFs/Optional_Laser_Cut_Panels/Bottom_Panel_450x450_Rev3.dxf
760.0 x 700.0 mm
