Annex-Engineering/Masherbrum-K1/Release_3_0/DXFs/Panels/Back_Panel_450x450_Rev3.dxf

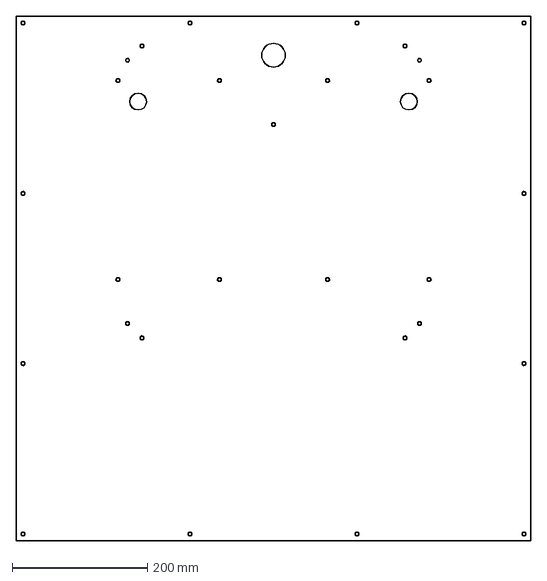
[picture p74: CAD file, 2021-05-25]
Release_3_0/DXFs/Panels/Back_Panel_450x450_Rev3.dxf
760.0 x 775.0 mm
