Annex-Engineering/Masherbrum-K1/Release_3_0/DXFs/XY_Gantry/xy_joint_top_cap_x8_rev1_2mm_aluminum.DXF

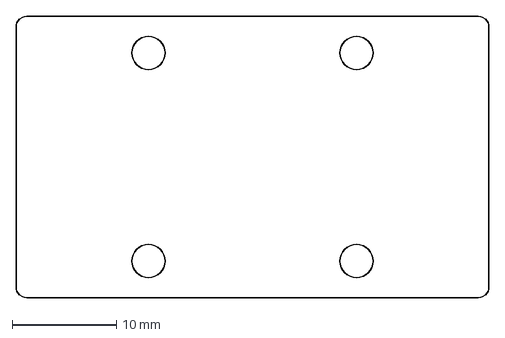
[picture p75: CAD file, 2022-11-29]
Release_3_0/DXFs/XY_Gantry/xy_joint_top_cap_x8_rev1_2mm_aluminum.DXF
45.4 x 27.0 mm
