Annex-Engineering/Masherbrum-K1/Release_3_0/STLs/Cable_Management/25x40mm_cable_channel_base_140mm_x3_rev1.STL

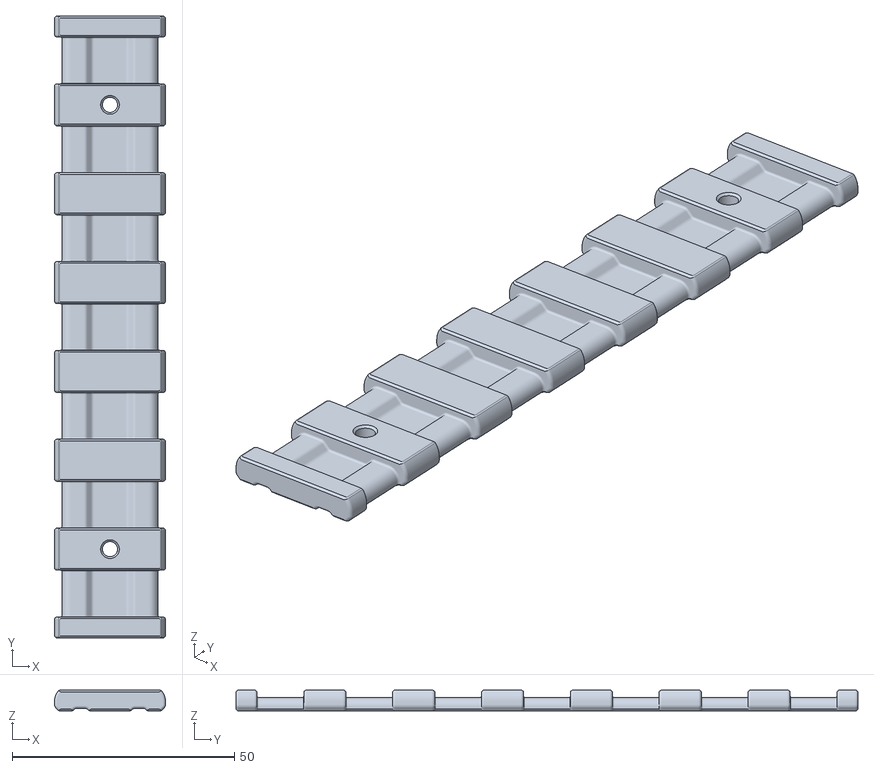
[picture p76: CAD file, 2022-01-18]
Release_3_0/STLs/Cable_Management/25x40mm_cable_channel_base_140mm_x3_rev1.STL
25.0 x 140.0 x 4.70
