Annex-Engineering/Masherbrum-K1/Release_3_0/STLs/Electronics_Box/electronics_box_corner_x3_rev3.STL

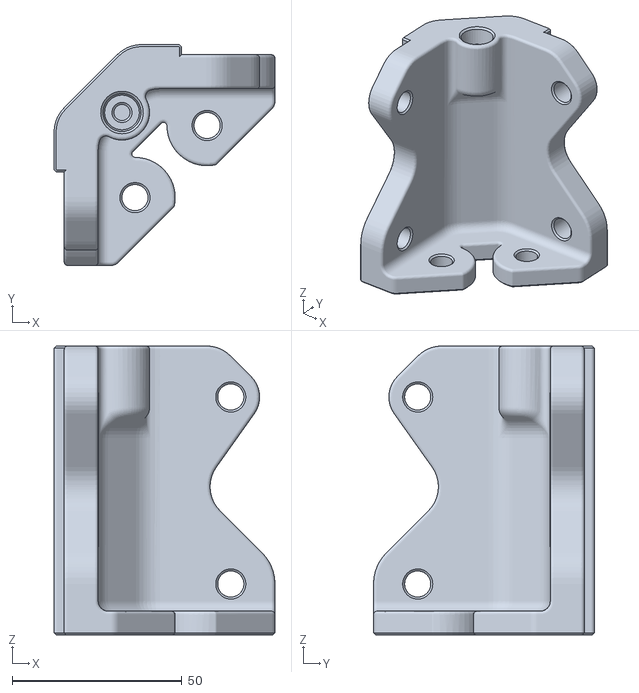
[picture p77: CAD file, 2022-12-18]
Release_3_0/STLs/Electronics_Box/electronics_box_corner_x3_rev3.STL
65.0 x 65.0 x 85.0
