Annex-Engineering/Masherbrum-K1/Release_3_0/STLs/Filament_Management/[a]_filament_sensor_holder_x2_rev1.STL

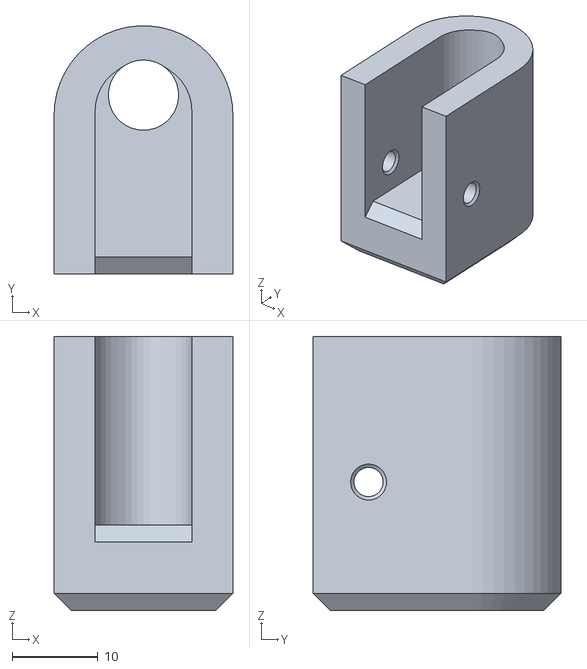
[picture p78: CAD file, 2020-02-11]
Release_3_0/STLs/Filament_Management/[a]_filament_sensor_holder_x2_rev1.STL
20.9 x 29.0 x 32.0
