Annex-Engineering/Masherbrum-K1/Release_3_0/STLs/Jigs_and_Fixtures/[a]_2020_dual_gantry_blind_joint_hole_drill_guide_x1_rev1.STL

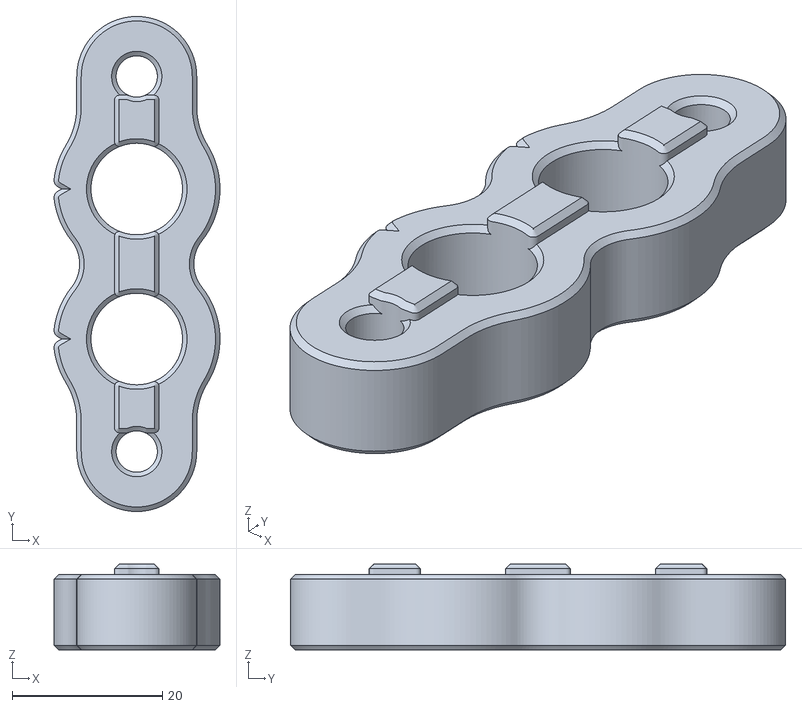
[picture p79: CAD file, 2021-07-12]
Release_3_0/STLs/Jigs_and_Fixtures/[a]_2020_dual_gantry_blind_joint_hole_drill_guide_x1_rev1.STL
22.1 x 66.0 x 11.4
