Annex-Engineering/Masherbrum-K1/Release_3_0/STLs/Misc/foot_to_frame_bracket_x4_rev3.STL

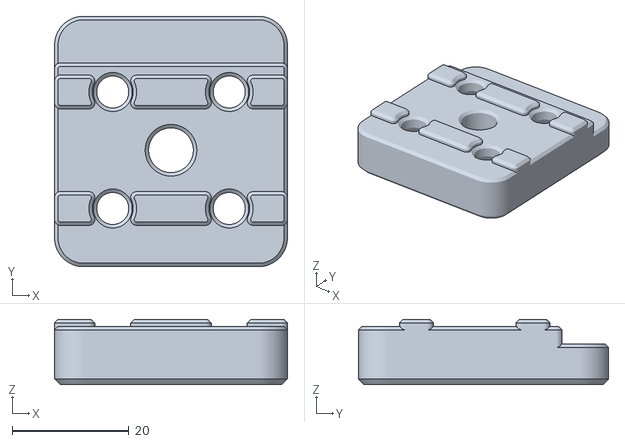
[picture p80: CAD file, 2022-01-25]
Release_3_0/STLs/Misc/foot_to_frame_bracket_x4_rev3.STL
40.0 x 43.0 x 11.2
