Annex-Engineering/Masherbrum-K1/Release_3_0/STLs/Panel_Mounting/Front_Panel_Hinges_and_Locks/front_door_bearing_block_1_x4_rev1.STL

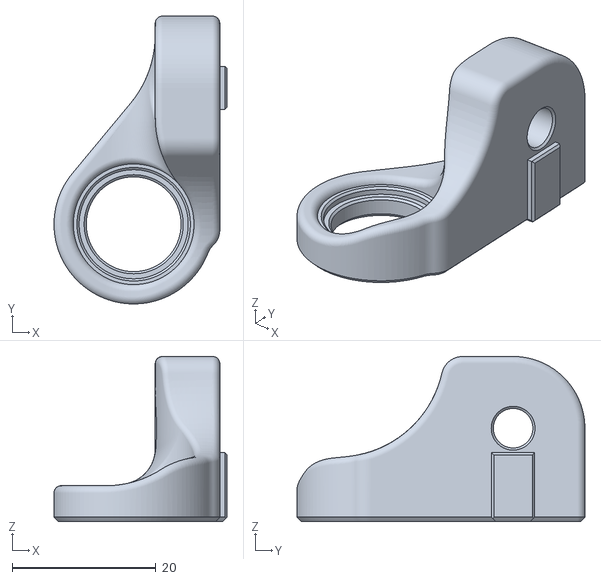
[picture p81: CAD file, 2020-11-09]
Release_3_0/STLs/Panel_Mounting/Front_Panel_Hinges_and_Locks/front_door_bearing_block_1_x4_rev1.STL
24.1 x 40.1 x 23.0
