Annex-Engineering/Masherbrum-K1/Release_3_0/STLs/Panel_Mounting/Sides_and_Top_Quick_Release/[a]_key_6mm_x50_Rev2.stl

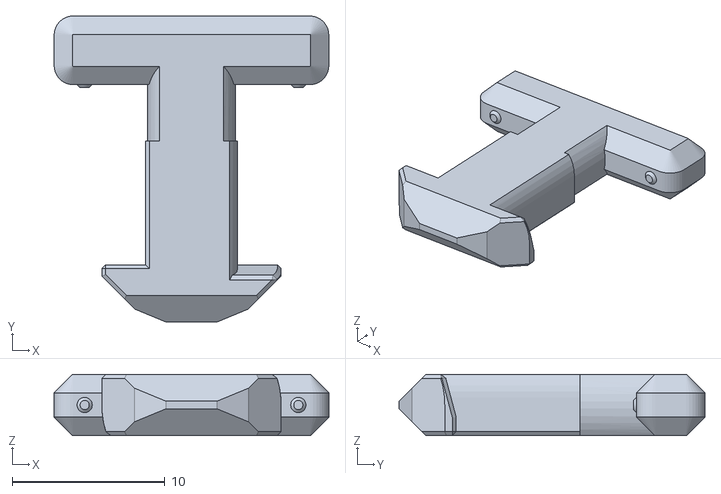
[picture p82: CAD file, 2020-03-01]
Release_3_0/STLs/Panel_Mounting/Sides_and_Top_Quick_Release/[a]_key_6mm_x50_Rev2.stl
18.0 x 20.0 x 4.00
