Annex-Engineering/Masherbrum-K1/Release_3_0/STLs/Purge_and_Brush_Bucket/brush_+_bucket_holder_x1_rev1.STL

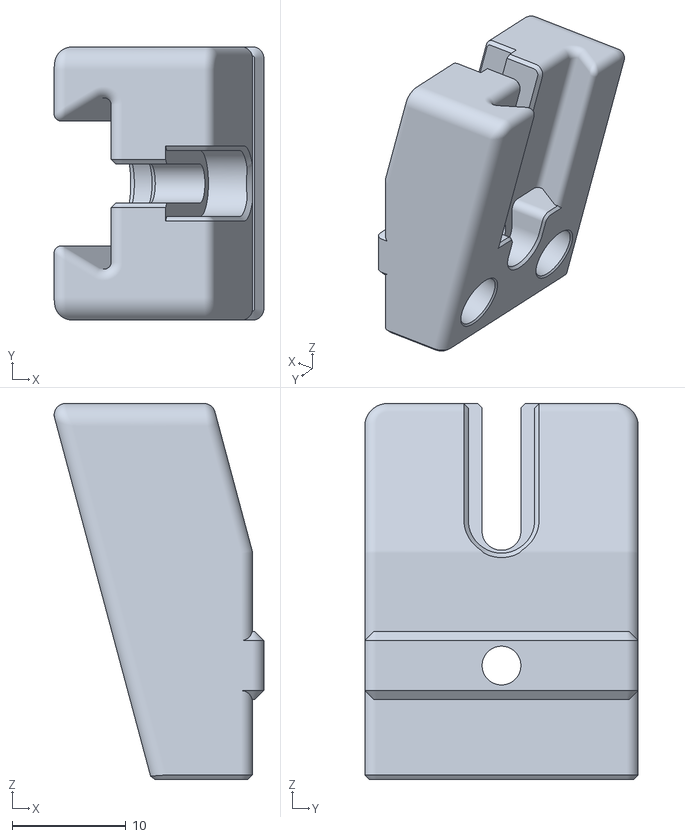
[picture p83: CAD file, 2020-12-21]
Release_3_0/STLs/Purge_and_Brush_Bucket/brush_+_bucket_holder_x1_rev1.STL
18.4 x 24.0 x 33.0
