Annex-Engineering/Masherbrum-K1/Release_3_0/STLs/XY_Gantry/xy_joint_tensioner_b_x4_rev1.STL

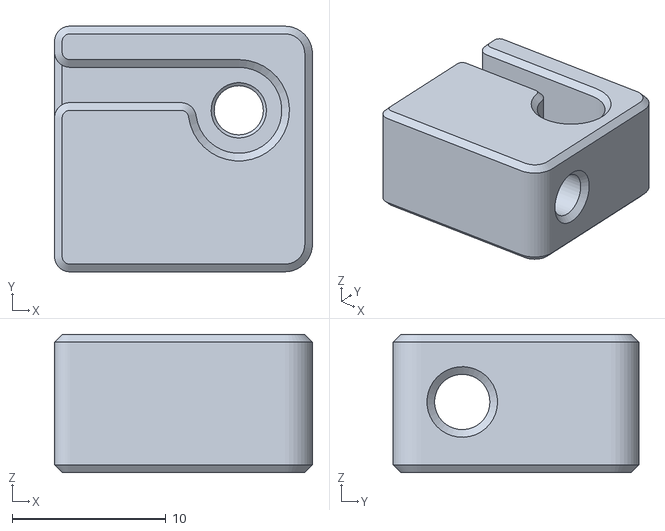
[picture p84: CAD file, 2022-11-29]
Release_3_0/STLs/XY_Gantry/xy_joint_tensioner_b_x4_rev1.STL
16.8 x 16.0 x 9.00
