Annex-Engineering/Masherbrum-K1/DXFs/Panels/Back_Panel_200mm_Rev1.DXF

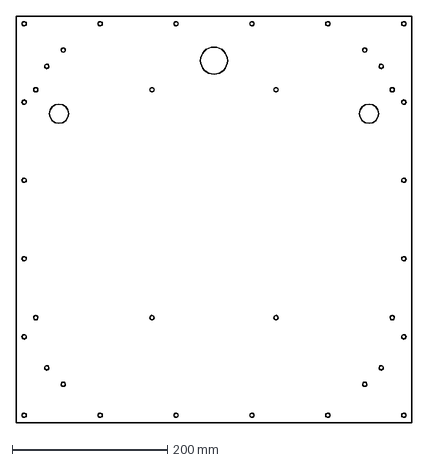
[picture p85: CAD file, 2020-05-08]
DXFs/Panels/Back_Panel_200mm_Rev1.DXF
510.0 x 525.0 mm
