Annex-Engineering/Masherbrum-K1/Release_1.2/STLs/XY_Carriage/Tool_Mounts/xy_carriage_v6_tool_mount_1_x1_rev3.STL

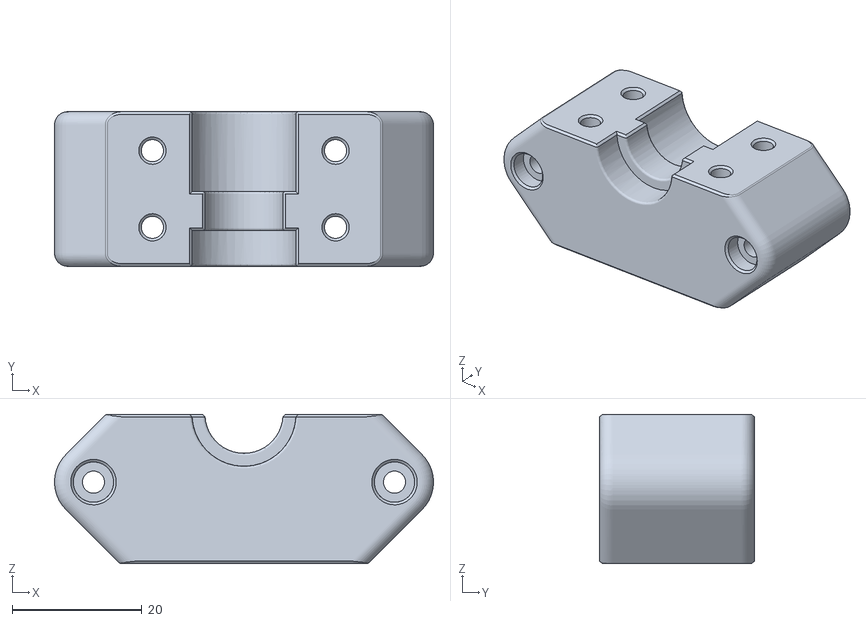
[picture p88: CAD file, 2020-03-24]
Release_1.2/STLs/XY_Carriage/Tool_Mounts/xy_carriage_v6_tool_mount_1_x1_rev3.STL
58.3 x 23.8 x 23.0
