Annex-Engineering/Masherbrum-K1/Release_1.2/STLs/XY_Carriage/Top_Plates/bmg_mounting_bracket_x1_rev3.STL

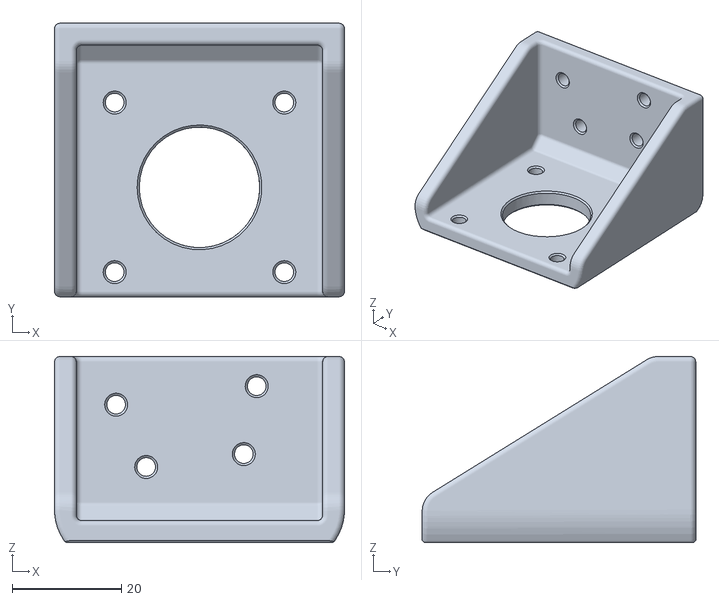
[picture p89: CAD file, 2020-04-20]
Release_1.2/STLs/XY_Carriage/Top_Plates/bmg_mounting_bracket_x1_rev3.STL
53.0 x 50.0 x 34.0
