Annex-Engineering/Masherbrum-K1/Release_1.2/STLs/XY_Carriage/xy_carriage_piton_probe_holder_dragon_x1_rev2.STL

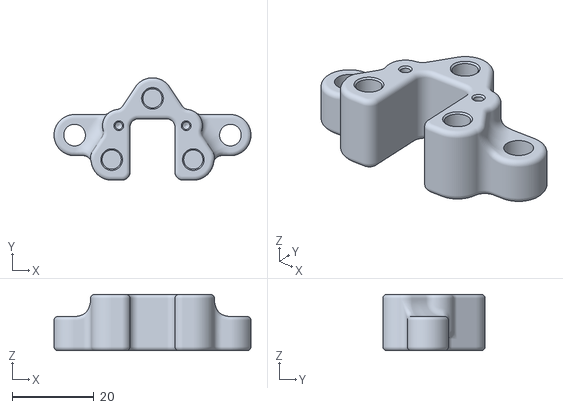
[picture p90: CAD file, 2020-11-18]
Release_1.2/STLs/XY_Carriage/xy_carriage_piton_probe_holder_dragon_x1_rev2.STL
48.3 x 25.1 x 13.8
