Annex-Engineering/Masherbrum-K1/Release_1.2/STLs/XY_Gantry/[a]_tall_motor_short_idler_bearing_cap_x2_rev3.STL

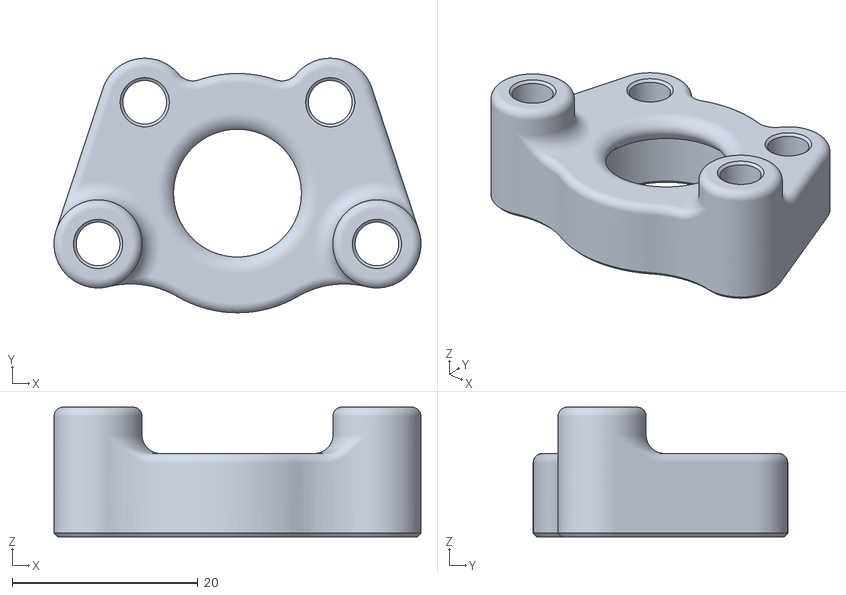
[picture p91: CAD file, 2020-08-20]
Release_1.2/STLs/XY_Gantry/[a]_tall_motor_short_idler_bearing_cap_x2_rev3.STL
39.6 x 27.4 x 14.0
