Annex-Engineering/Masherbrum-K1/Release_2/STLs/Electronics_Brackets/bigtreetech_skr_mounting_bracket_with_motor_expander_x1_rev3.STL

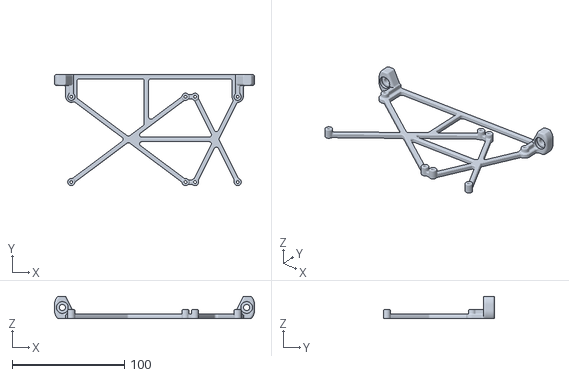
[picture p92: CAD file, 2020-09-01]
Release_2/STLs/Electronics_Brackets/bigtreetech_skr_mounting_bracket_with_motor_expander_x1_rev3.STL
178.3 x 99.3 x 20.0
