Annex-Engineering/Masherbrum-K1/Release_2_2/STLs/XY_Carriage/Toolhead_Bottoms/Mosquito_Mag+_and_Rapido_UHF/xy_carriage_mag+_bottom_frame_magswitch_probe_v2_x1_rev4.STL

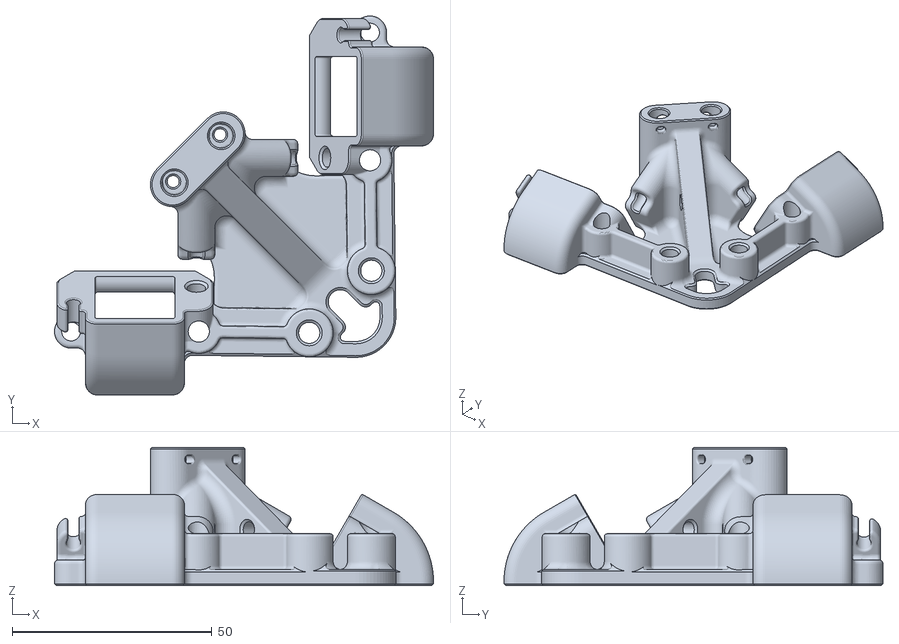
[picture p93: CAD file, 2021-08-11]
Release_2_2/STLs/XY_Carriage/Toolhead_Bottoms/Mosquito_Mag+_and_Rapido_UHF/xy_carriage_mag+_bottom_frame_magswitch_probe_v2_x1_rev4.STL
94.9 x 94.9 x 34.6
