Annex-Engineering/Masherbrum-K1/Release_2_2/STLs/XY_Carriage/Toolhead_Bottoms/VolcoMosquito_and_Rapido_StandardFlow/xy_carriage_volcomosquito_bottom_frame_magswitch_probe_x1_rev1.STL

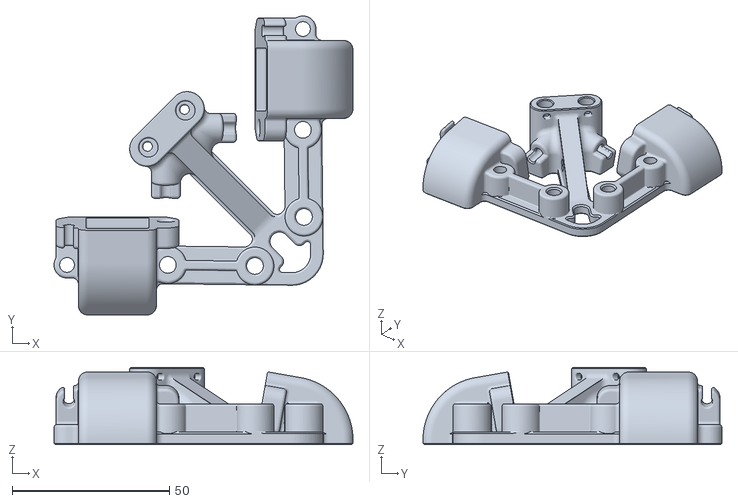
[picture p94: CAD file, 2021-11-27]
Release_2_2/STLs/XY_Carriage/Toolhead_Bottoms/VolcoMosquito_and_Rapido_StandardFlow/xy_carriage_volcomosquito_bottom_frame_magswitch_probe_x1_rev1.STL
94.9 x 94.9 x 24.6
