Annex-Engineering/Masherbrum-K1/Release_2_2/STLs/XY_Gantry/[a]_tall_motor_short_idler_bearing_cap_12mm_belts_x2_rev2.STL

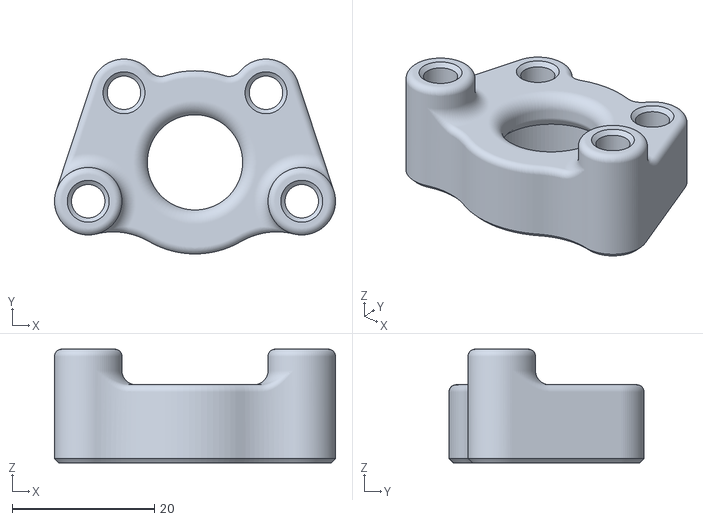
[picture p95: CAD file, 2020-11-21]
Release_2_2/STLs/XY_Gantry/[a]_tall_motor_short_idler_bearing_cap_12mm_belts_x2_rev2.STL
39.6 x 27.4 x 16.0
