Annex-Engineering/Masherbrum-K1/Release_2_2/STLs/XY_Gantry/MGN12C_Stationary_Rails/[a]_xy_mgn12c_top_cap_x4_rev2.STL

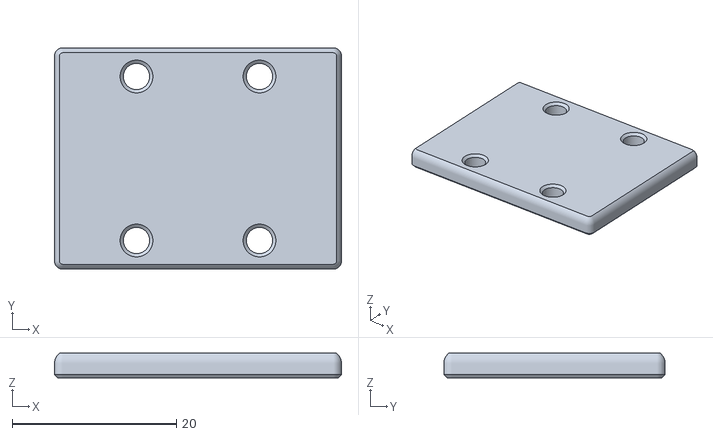
[picture p96: CAD file, 2020-11-21]
Release_2_2/STLs/XY_Gantry/MGN12C_Stationary_Rails/[a]_xy_mgn12c_top_cap_x4_rev2.STL
35.0 x 27.0 x 3.00
