Annex-Engineering/Masherbrum-K1/Release_2_Beta/DXFs/Doors/Double_Hinge/Front_Door_250mm_x2_Rev1.DXF

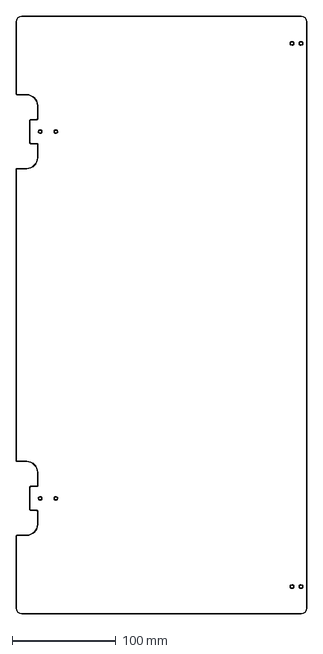
[picture p97: CAD file, 2020-11-09]
Release_2_Beta/DXFs/Doors/Double_Hinge/Front_Door_250mm_x2_Rev1.DXF
279.5 x 575.0 mm
