Annex-Engineering/Masherbrum-K1/Release_2_Beta/DXFs/Doors/Triple_Hinge/Front_Door_250mm_x_250mm_x_250mm_x2_Rev1.DXF

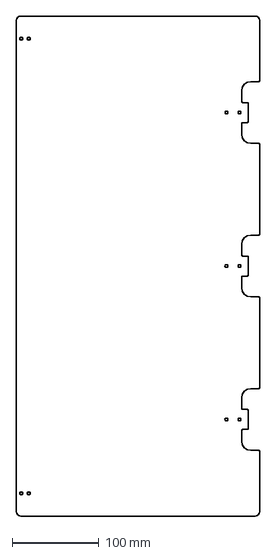
[picture p98: CAD file, 2020-11-17]
Release_2_Beta/DXFs/Doors/Triple_Hinge/Front_Door_250mm_x_250mm_x_250mm_x2_Rev1.DXF
279.5 x 575.0 mm
