Annex-Engineering/Masherbrum-K1/Release_3_0/DXFs/Doors/Double_Hinge/Front_Door_200mm_x2_Rev3.DXF

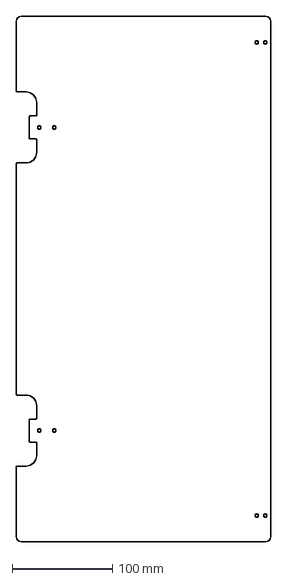
[picture p99: CAD file, 2021-01-11]
Release_3_0/DXFs/Doors/Double_Hinge/Front_Door_200mm_x2_Rev3.DXF
254.5 x 525.0 mm
