Annex-Engineering/Masherbrum-K1/Release_3_0/DXFs/Optional_Laser_Cut_Panels/Top_Panel_500x500_Rev3.dxf

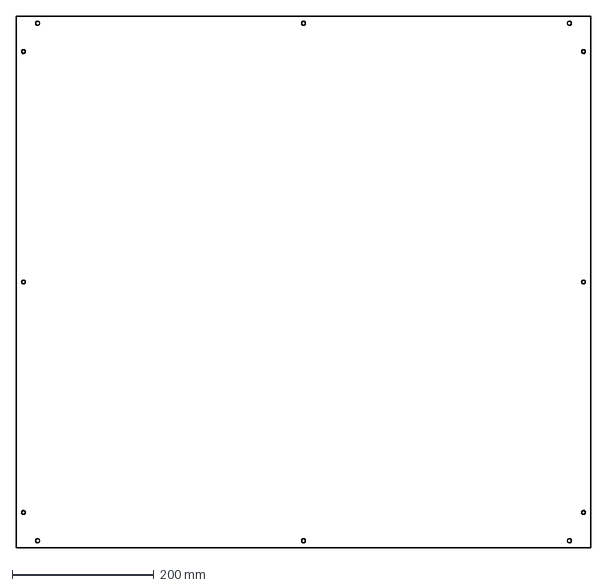
[picture p101: CAD file, 2021-05-25]
Release_3_0/DXFs/Optional_Laser_Cut_Panels/Top_Panel_500x500_Rev3.dxf
810.0 x 750.0 mm
