Annex-Engineering/Masherbrum-K1/Release_3_0/DXFs/Panels/Back_Panel_350x350_Rev3.dxf

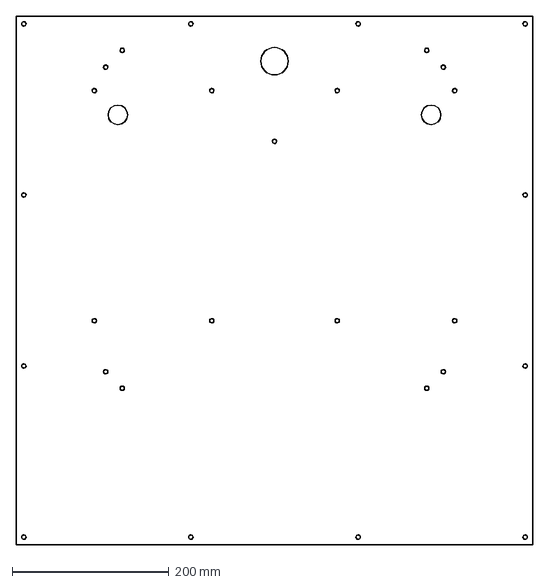
[picture p102: CAD file, 2021-05-25]
Release_3_0/DXFs/Panels/Back_Panel_350x350_Rev3.dxf
660.0 x 675.0 mm
