Annex-Engineering/Masherbrum-K1/Release_3_0/STLs/Cable_Management/25x40mm_cable_channel_clip_x21_rev1.STL

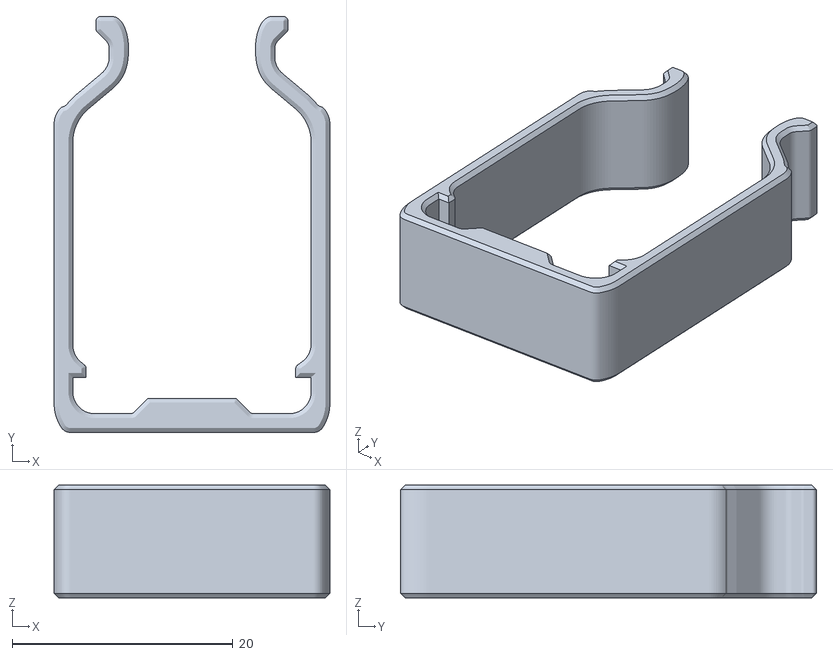
[picture p104: CAD file, 2022-01-18]
Release_3_0/STLs/Cable_Management/25x40mm_cable_channel_clip_x21_rev1.STL
25.0 x 37.7 x 10.2
