Annex-Engineering/Masherbrum-K1/Release_3_0/STLs/Electronics_Box/[a]_electronics_box_side_panel_mid_filler_x4_rev2.STL

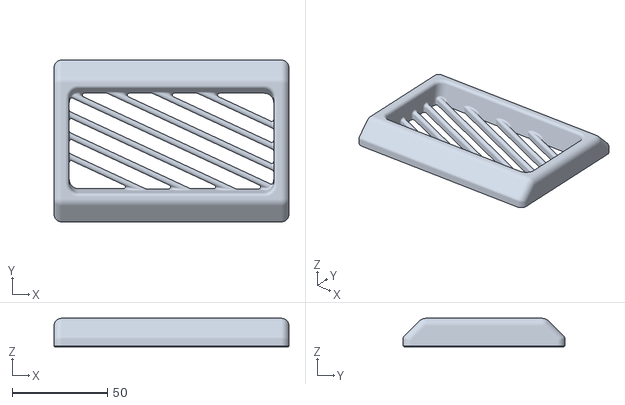
[picture p105: CAD file, 2022-03-01]
Release_3_0/STLs/Electronics_Box/[a]_electronics_box_side_panel_mid_filler_x4_rev2.STL
123.4 x 85.0 x 15.0
