Annex-Engineering/Masherbrum-K1/Release_3_0/STLs/Electronics_Brackets/universal_meanwell_lrs_psu_mounting_bracket_x2_rev3.STL

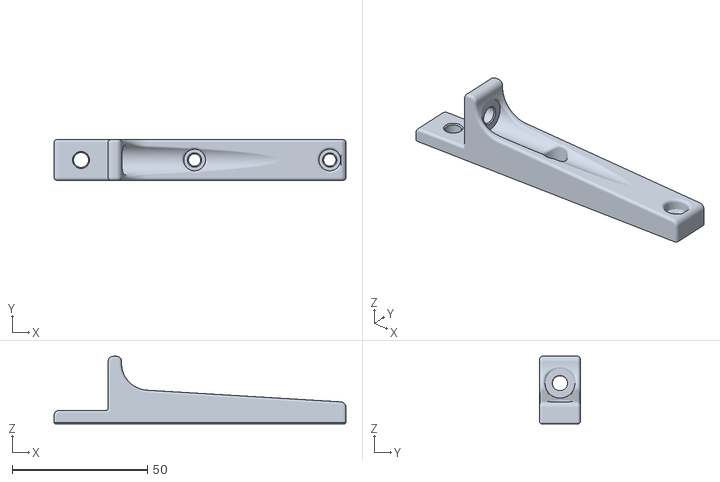
[picture p106: CAD file, 2022-02-11]
Release_3_0/STLs/Electronics_Brackets/universal_meanwell_lrs_psu_mounting_bracket_x2_rev3.STL
108.0 x 15.0 x 25.0
