Annex-Engineering/Masherbrum-K1/Release_3_0/STLs/Filament_Management/spool_holder_6mm_panels_x1_Rev1.stl

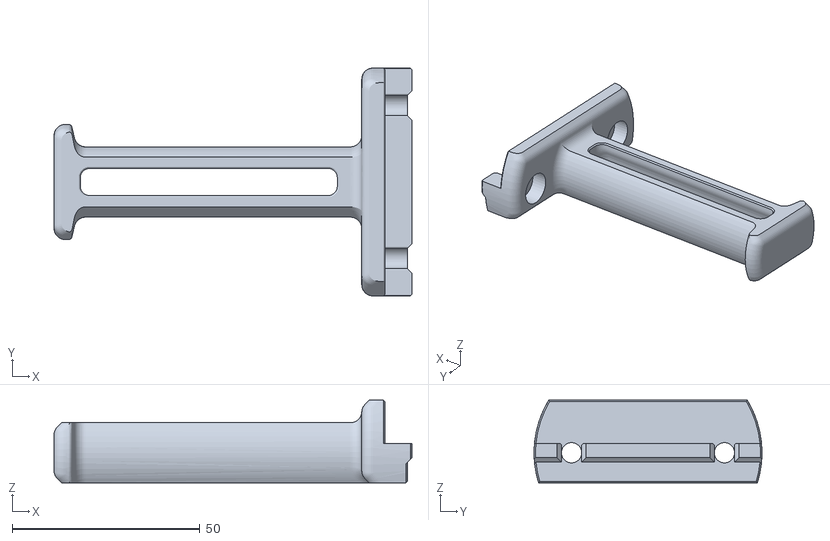
[picture p107: CAD file, 2020-02-11]
Release_3_0/STLs/Filament_Management/spool_holder_6mm_panels_x1_Rev1.stl
95.4 x 60.7 x 22.0
