Annex-Engineering/Masherbrum-K1/Release_3_0/STLs/Jigs_and_Fixtures/[a]_xy_drive_pulley_height_jig_x1_rev1.STL

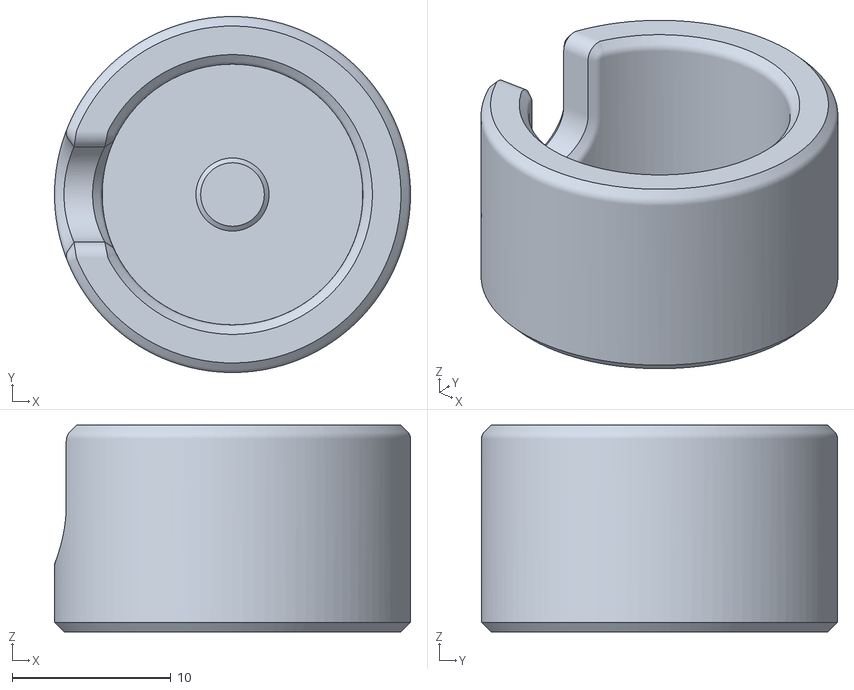
[picture p108: CAD file, 2020-11-21]
Release_3_0/STLs/Jigs_and_Fixtures/[a]_xy_drive_pulley_height_jig_x1_rev1.STL
22.4 x 22.4 x 13.0
