Annex-Engineering/Masherbrum-K1/Release_3_0/STLs/Misc/leveling_caster_adapter_x4_rev1.STL

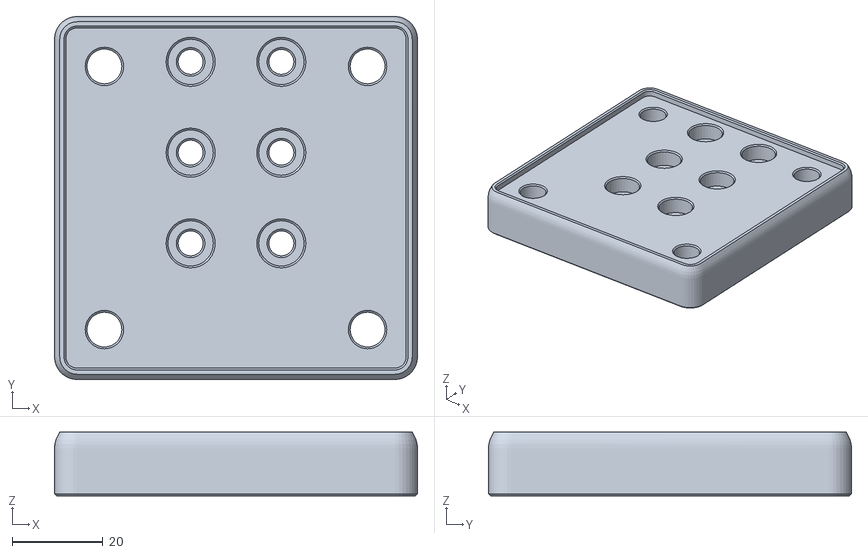
[picture p109: CAD file, 2021-02-08]
Release_3_0/STLs/Misc/leveling_caster_adapter_x4_rev1.STL
80.0 x 80.0 x 14.0
