Annex-Engineering/Masherbrum-K1/Release_3_0/STLs/Panel_Mounting/Sides_and_Top_Quick_Release/lock_body_6mm_x12_Rev2.stl

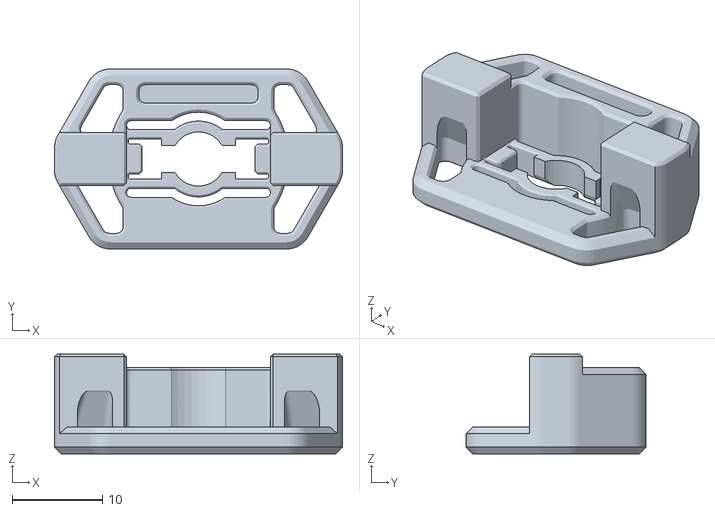
[picture p110: CAD file, 2020-03-01]
Release_3_0/STLs/Panel_Mounting/Sides_and_Top_Quick_Release/lock_body_6mm_x12_Rev2.stl
32.0 x 20.0 x 11.1
