Annex-Engineering/Masherbrum-K1/Release_3_0/STLs/XY_Gantry/xy_joint_rail_holder_x4_rev1.STL

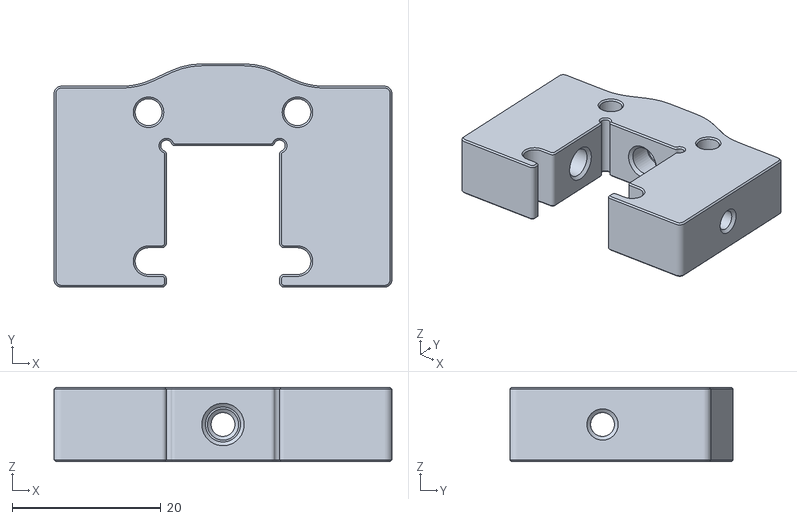
[picture p111: CAD file, 2022-11-29]
Release_3_0/STLs/XY_Gantry/xy_joint_rail_holder_x4_rev1.STL
45.4 x 30.0 x 10.0
