Annex-Engineering/Masherbrum-K1/Release_3_0/STLs/XY_Toolhead/[a]_dragon_uhf_with_extender_fan_shroud_x1_rev1.STL

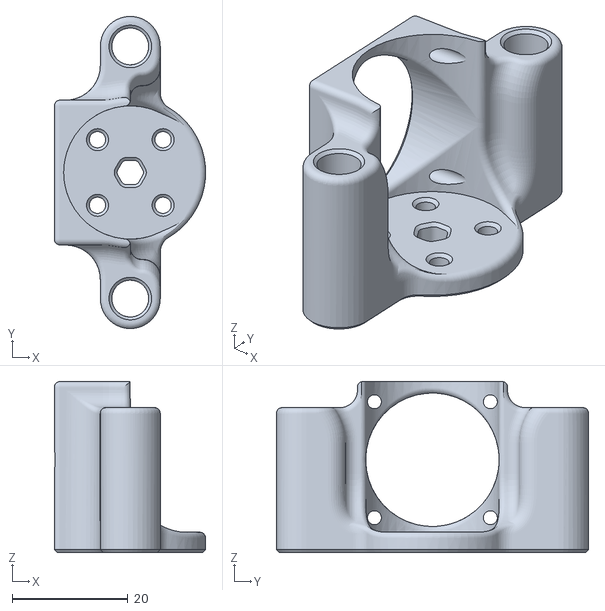
[picture p112: CAD file, 2023-01-19]
Release_3_0/STLs/XY_Toolhead/[a]_dragon_uhf_with_extender_fan_shroud_x1_rev1.STL
26.1 x 53.9 x 29.5
