Annex-Engineering/Masherbrum-K1/DXFs/Panels/Back_Panel_250mm_Rev1.DXF

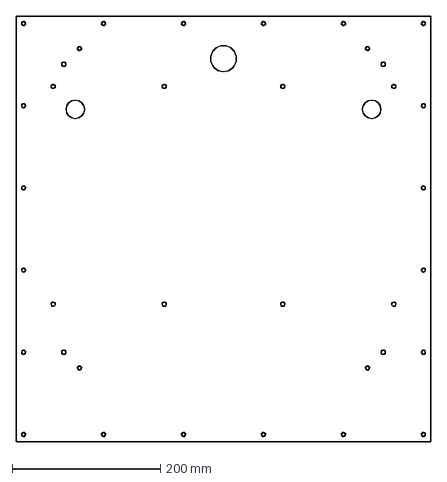
[picture p113: CAD file, 2020-05-08]
DXFs/Panels/Back_Panel_250mm_Rev1.DXF
560.0 x 575.0 mm
