Annex-Engineering/Masherbrum-K1/Release_1.2/DXFs/Doors/Double_Hinge/Front_Door_300mm_x2_Rev2.DXF

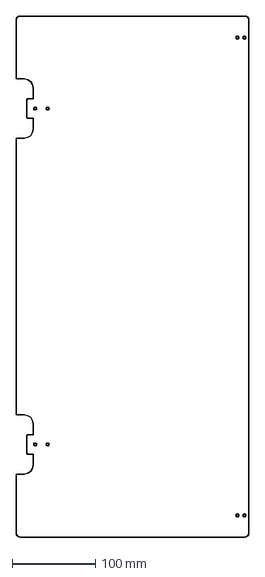
[picture p114: CAD file, 2021-01-07]
Release_1.2/DXFs/Doors/Double_Hinge/Front_Door_300mm_x2_Rev2.DXF
279.5 x 625.0 mm
