Annex-Engineering/Masherbrum-K1/Release_1.2/DXFs/Doors/Triple_Hinge/Front_Door_250mm_x_250mm_x_300mm_x2_Rev2.DXF

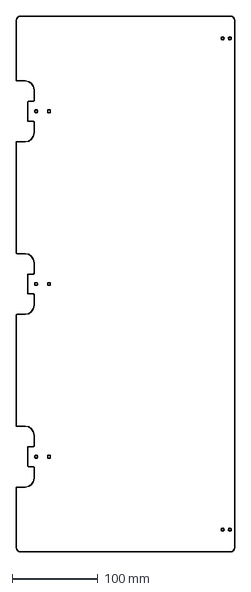
[picture p115: CAD file, 2021-01-07]
Release_1.2/DXFs/Doors/Triple_Hinge/Front_Door_250mm_x_250mm_x_300mm_x2_Rev2.DXF
254.5 x 625.0 mm
