Annex-Engineering/Masherbrum-K1/Release_1.2/STLs/XY_Carriage/[a]_xy_carriage_fan_duct_2_bass_x1_rev1.STL

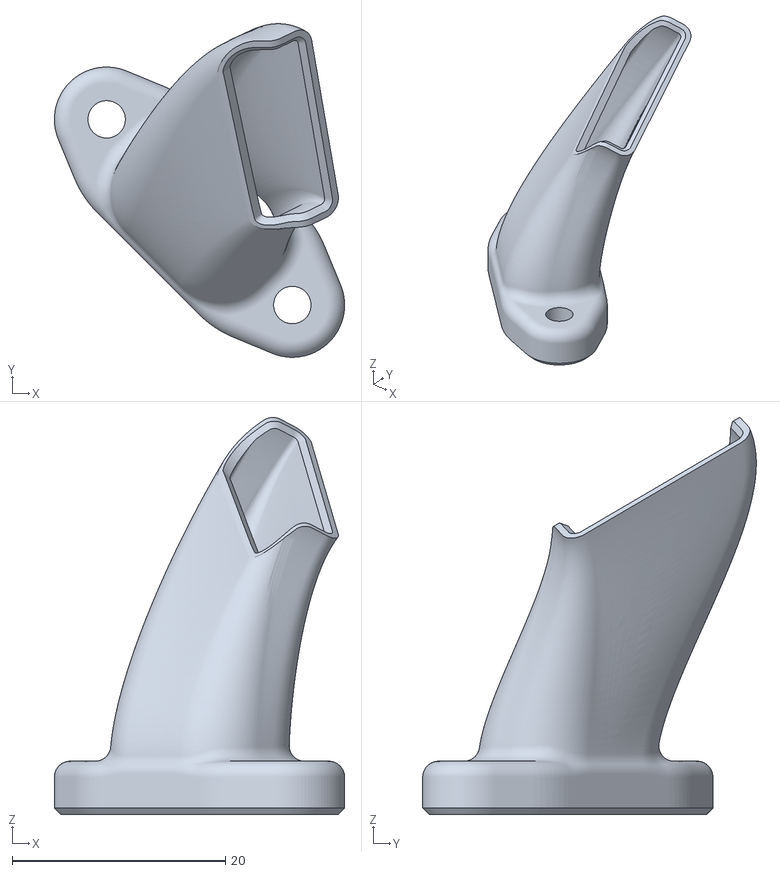
[picture p116: CAD file, 2020-10-05]
Release_1.2/STLs/XY_Carriage/[a]_xy_carriage_fan_duct_2_bass_x1_rev1.STL
27.2 x 31.3 x 37.2
