Annex-Engineering/Masherbrum-K1/Release_1.2/STLs/XY_Carriage/Tool_Mounts/xy_carriage_volcano_tool_mount_1_x1_rev3.STL

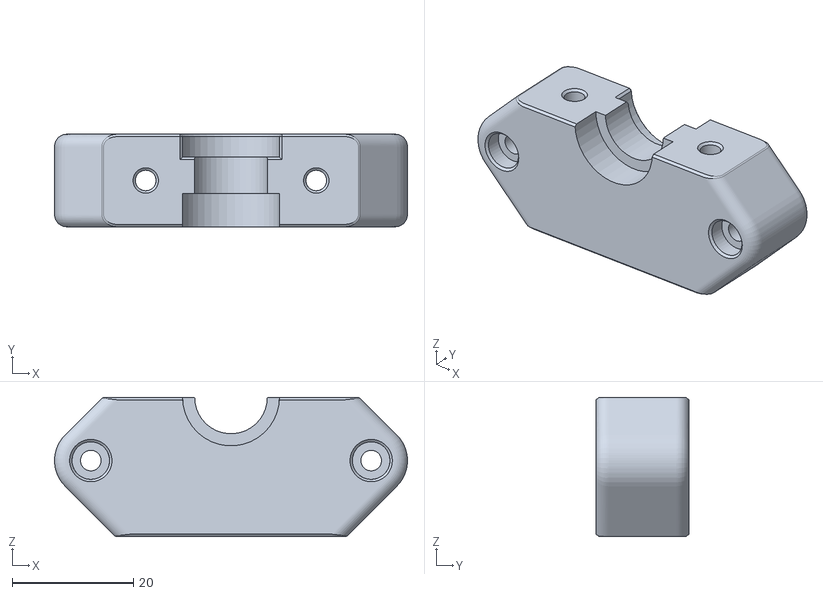
[picture p117: CAD file, 2020-03-24]
Release_1.2/STLs/XY_Carriage/Tool_Mounts/xy_carriage_volcano_tool_mount_1_x1_rev3.STL
58.3 x 15.3 x 23.0
