Annex-Engineering/Masherbrum-K1/Release_2_2/STLs/XY_Gantry/[a]_short_motor_tall_idler_bearing_cap_12mm_belts_x2_rev2.STL

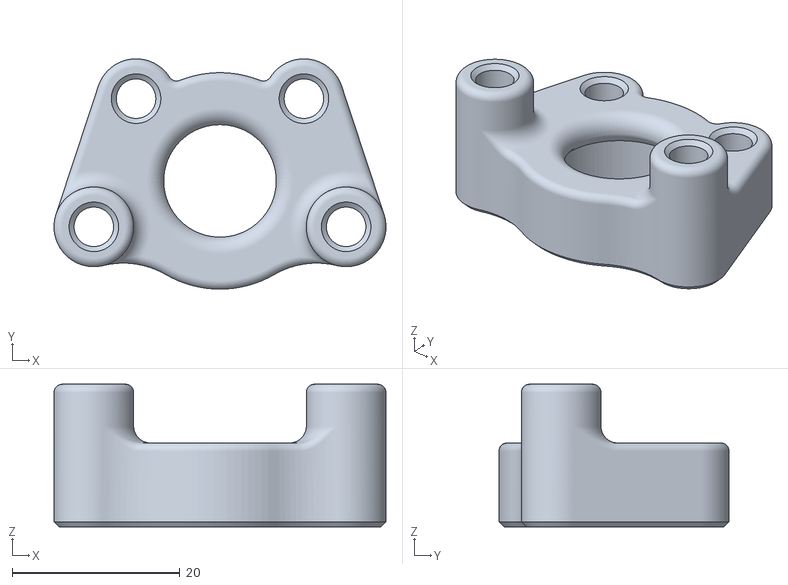
[picture p119: CAD file, 2020-11-21]
Release_2_2/STLs/XY_Gantry/[a]_short_motor_tall_idler_bearing_cap_12mm_belts_x2_rev2.STL
39.6 x 27.4 x 17.0
