Annex-Engineering/Masherbrum-K1/Release_2_2/STLs/XY_Gantry/MGN12C_Stationary_Rails/xy_mgn12c_1515_holder_12mm_belts_x4_rev2.STL

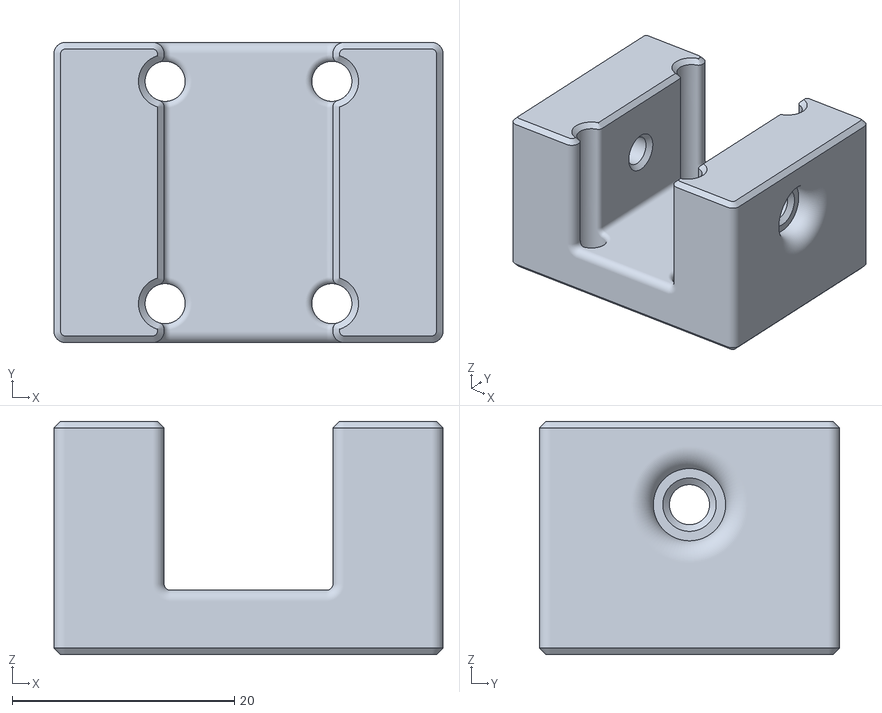
[picture p120: CAD file, 2020-11-21]
Release_2_2/STLs/XY_Gantry/MGN12C_Stationary_Rails/xy_mgn12c_1515_holder_12mm_belts_x4_rev2.STL
35.0 x 27.0 x 21.0
