Annex-Engineering/Masherbrum-K1/Release_2_Beta/DXFs/Doors/Double_Hinge/Front_Door_300mm_x2_Rev1.DXF

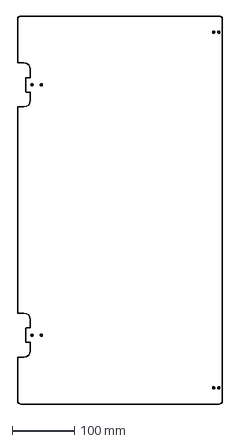
[picture p121: CAD file, 2020-11-09]
Release_2_Beta/DXFs/Doors/Double_Hinge/Front_Door_300mm_x2_Rev1.DXF
329.5 x 625.0 mm
