Annex-Engineering/Masherbrum-K1/Release_2_Beta/DXFs/Doors/Triple_Hinge/Front_Door_300mm_x2_Rev1.DXF

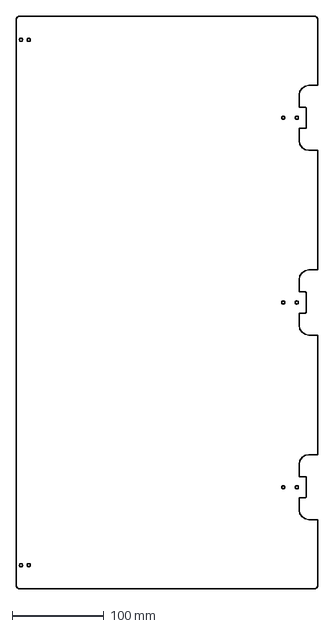
[picture p122: CAD file, 2020-11-17]
Release_2_Beta/DXFs/Doors/Triple_Hinge/Front_Door_300mm_x2_Rev1.DXF
329.5 x 625.0 mm
