Annex-Engineering/Masherbrum-K1/Release_3_0/DXFs/Doors/Double_Hinge/Front_Door_300mm_x2_Rev3.DXF

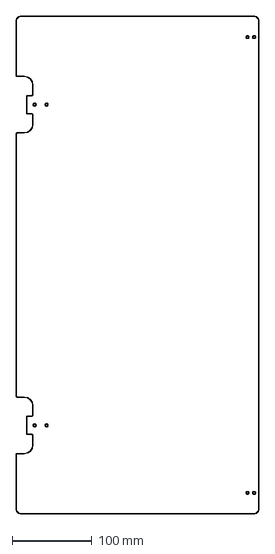
[picture p124: CAD file, 2021-01-11]
Release_3_0/DXFs/Doors/Double_Hinge/Front_Door_300mm_x2_Rev3.DXF
304.5 x 625.0 mm
