Annex-Engineering/Masherbrum-K1/Release_3_0/DXFs/Doors/Triple_Hinge/Front_Door_250mm_x_250mm_x_300mm_x2_Rev3.DXF

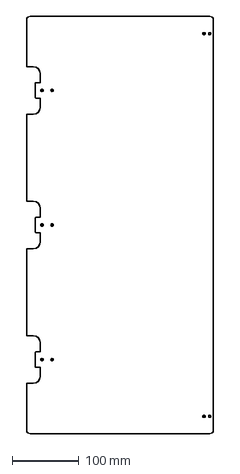
[picture p125: CAD file, 2021-01-11]
Release_3_0/DXFs/Doors/Triple_Hinge/Front_Door_250mm_x_250mm_x_300mm_x2_Rev3.DXF
279.5 x 625.0 mm
