Annex-Engineering/Masherbrum-K1/Release_3_0/DXFs/Optional_Laser_Cut_Panels/Top_Panel_400x400_Rev3.dxf

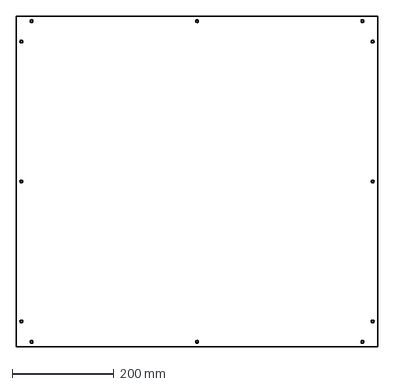
[picture p126: CAD file, 2021-05-25]
Release_3_0/DXFs/Optional_Laser_Cut_Panels/Top_Panel_400x400_Rev3.dxf
710.0 x 650.0 mm
