Annex-Engineering/Masherbrum-K1/Release_3_0/DXFs/Panels/Back_Panel_250x250_Rev3.dxf

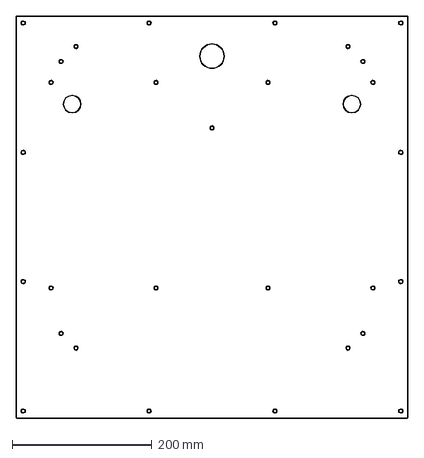
[picture p127: CAD file, 2021-05-25]
Release_3_0/DXFs/Panels/Back_Panel_250x250_Rev3.dxf
560.0 x 575.0 mm
