Annex-Engineering/Masherbrum-K1/Release_3_0/DXFs/Toolhead/fan_bracket_x2_rev1_2mm_aluminum.DXF

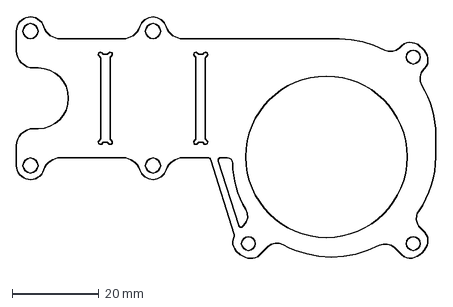
[picture p128: CAD file, 2022-11-29]
Release_3_0/DXFs/Toolhead/fan_bracket_x2_rev1_2mm_aluminum.DXF
96.9 x 57.8 mm
