Annex-Engineering/Masherbrum-K1/Release_3_0/STLs/Cable_Management/z_chain_anchor_top_bosch_x2_rev1.STL

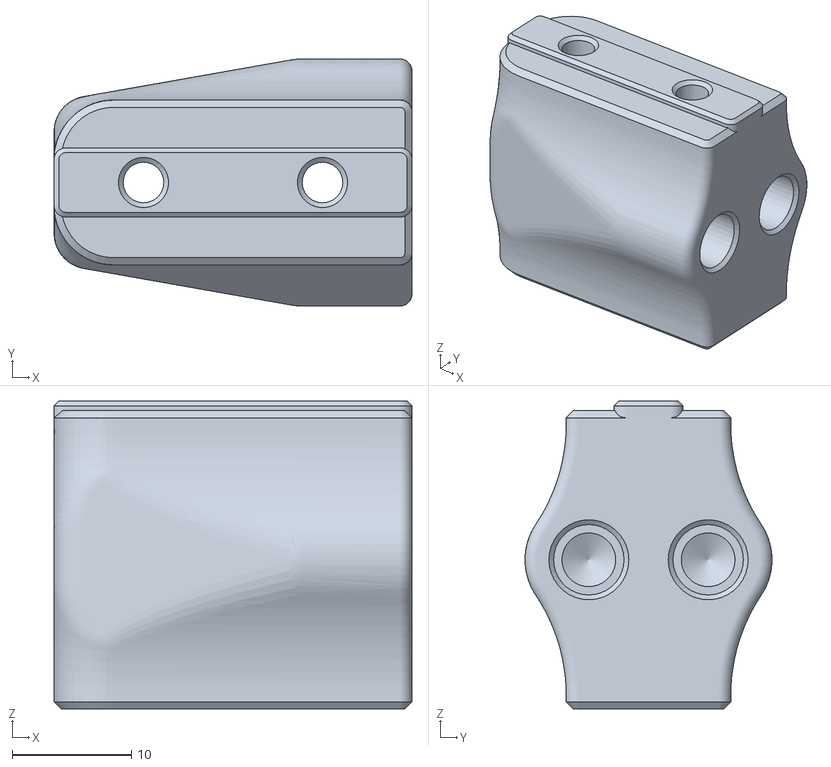
[picture p129: CAD file, 2021-07-31]
Release_3_0/STLs/Cable_Management/z_chain_anchor_top_bosch_x2_rev1.STL
30.0 x 20.7 x 25.8
