Annex-Engineering/Masherbrum-K1/Release_3_0/STLs/Electronics_Brackets/universal_meanwell_rs_psu_mounting_bracket_x2_rev2.STL

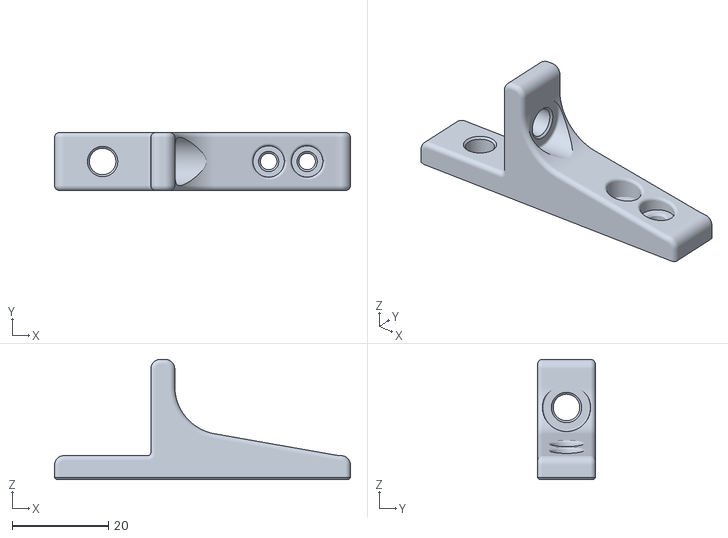
[picture p131: CAD file, 2022-02-01]
Release_3_0/STLs/Electronics_Brackets/universal_meanwell_rs_psu_mounting_bracket_x2_rev2.STL
61.5 x 12.0 x 25.0
