Annex-Engineering/Masherbrum-K1/Release_3_0/STLs/Jigs_and_Fixtures/[a]_mosquito_dd_bowden_cutting_tool_x1_rev1.STL

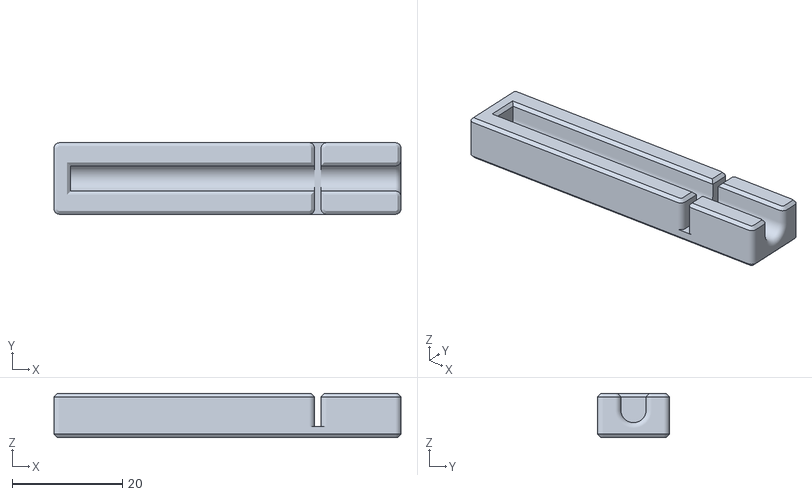
[picture p132: CAD file, 2020-11-21]
Release_3_0/STLs/Jigs_and_Fixtures/[a]_mosquito_dd_bowden_cutting_tool_x1_rev1.STL
63.0 x 13.0 x 8.00
