Annex-Engineering/Masherbrum-K1/Release_3_0/STLs/Misc/[a]_4040_extrusion_endcap_x2_rev2.STL

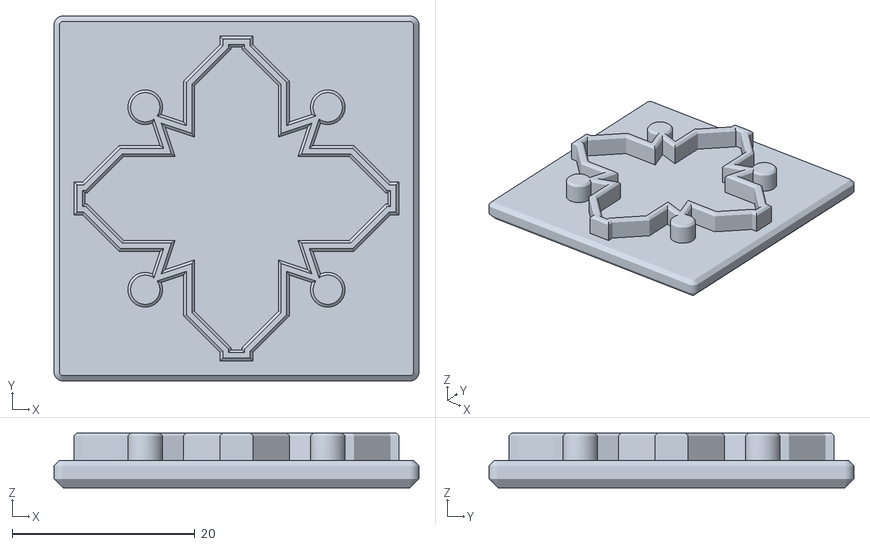
[picture p133: CAD file, 2020-11-19]
Release_3_0/STLs/Misc/[a]_4040_extrusion_endcap_x2_rev2.STL
40.0 x 40.0 x 6.00
