Annex-Engineering/Masherbrum-K1/Release_3_0/STLs/Panel_Mounting/Front_Panel_Hinges_and_Locks/[a]_front_door_handle_magnet_holder_x4_rev1.STL

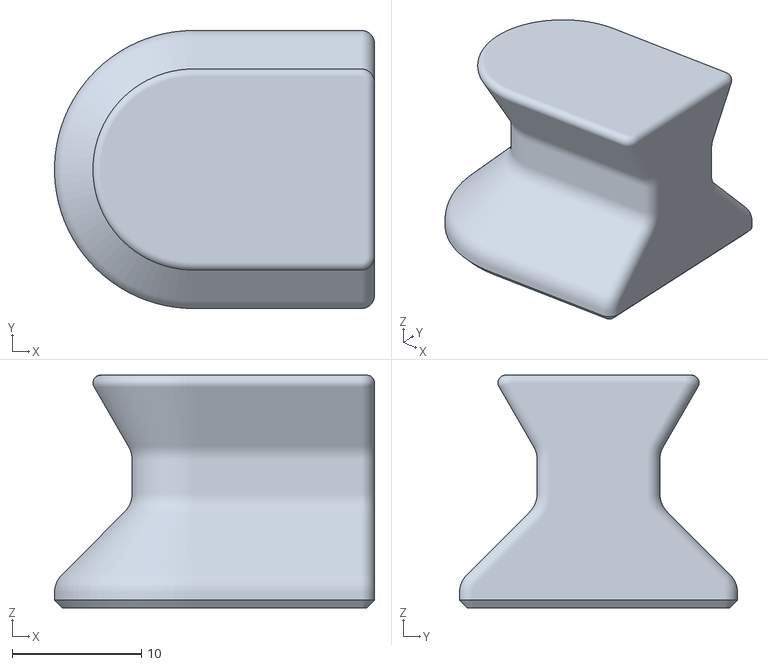
[picture p134: CAD file, 2020-11-09]
Release_3_0/STLs/Panel_Mounting/Front_Panel_Hinges_and_Locks/[a]_front_door_handle_magnet_holder_x4_rev1.STL
24.7 x 21.5 x 18.0
