Annex-Engineering/Masherbrum-K1/Release_3_0/STLs/Panel_Mounting/Sides_and_Top_Quick_Release/corner_lock_body_6mm_x6_Rev2.stl

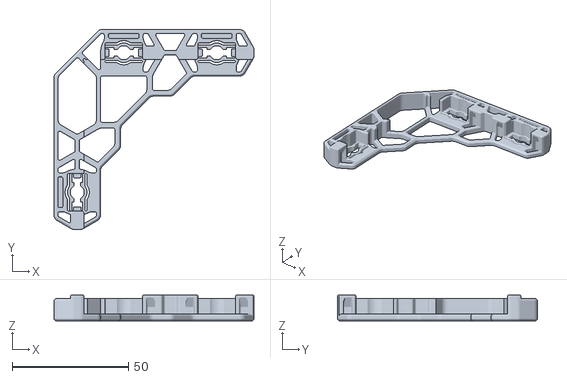
[picture p135: CAD file, 2020-03-01]
Release_3_0/STLs/Panel_Mounting/Sides_and_Top_Quick_Release/corner_lock_body_6mm_x6_Rev2.stl
86.0 x 86.0 x 11.1
