Annex-Engineering/Masherbrum-K1/Release_3_0/STLs/XY_Toolhead/bowden_guide_tube_x1_rev2.STL

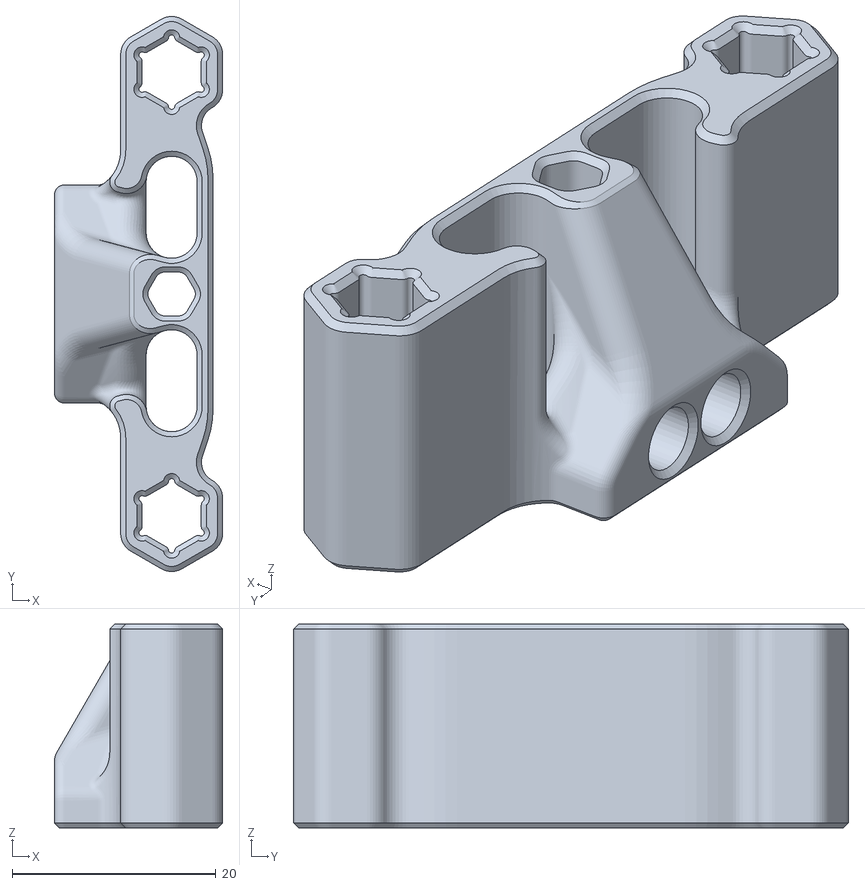
[picture p136: CAD file, 2022-12-01]
Release_3_0/STLs/XY_Toolhead/bowden_guide_tube_x1_rev2.STL
16.5 x 54.4 x 20.0
