Annex-Engineering/Masherbrum-K1/DXFs/Panels/Back_Panel_300mm_Rev1.DXF

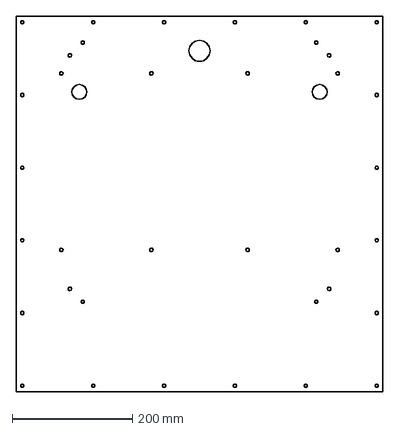
[picture p137: CAD file, 2020-05-08]
DXFs/Panels/Back_Panel_300mm_Rev1.DXF
610.0 x 625.0 mm
