Annex-Engineering/Masherbrum-K1/Release_1.2/DXFs/Doors/Double_Hinge/Front_Door_200mm_x2_Rev2.DXF

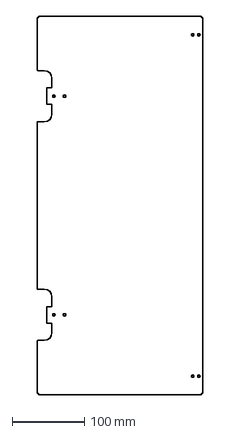
[picture p138: CAD file, 2021-01-07]
Release_1.2/DXFs/Doors/Double_Hinge/Front_Door_200mm_x2_Rev2.DXF
229.5 x 525.0 mm
