Annex-Engineering/Masherbrum-K1/Release_1.2/DXFs/Doors/Triple_Hinge/Front_Door_350mm_x2_Rev2.DXF

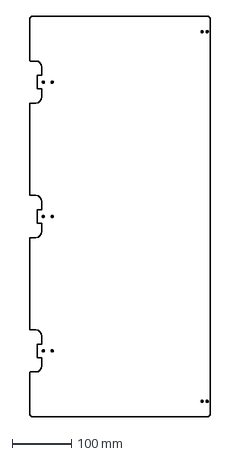
[picture p139: CAD file, 2021-01-07]
Release_1.2/DXFs/Doors/Triple_Hinge/Front_Door_350mm_x2_Rev2.DXF
304.5 x 675.0 mm
