Annex-Engineering/Masherbrum-K1/Release_1.2/STLs/XY_Carriage/Tool_Mounts/xy_carriage_volcano_tool_mount_2_x1_rev3.STL

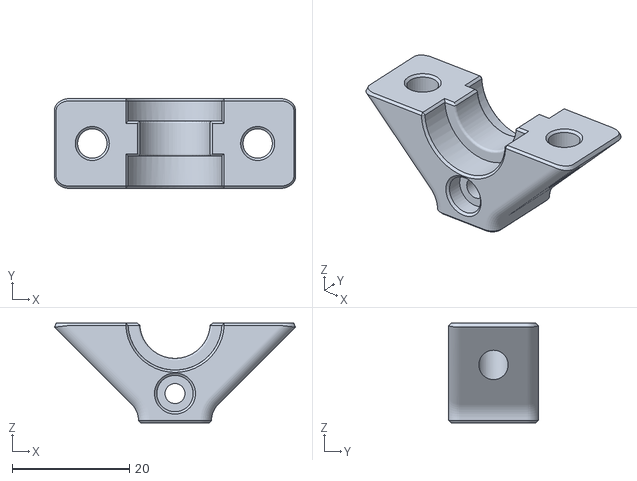
[picture p140: CAD file, 2020-03-24]
Release_1.2/STLs/XY_Carriage/Tool_Mounts/xy_carriage_volcano_tool_mount_2_x1_rev3.STL
41.1 x 15.3 x 17.0
