Annex-Engineering/Masherbrum-K1/Release_1.2/STLs/XY_Gantry/short_motor_tall_idler_mount_x2_rev7.STL

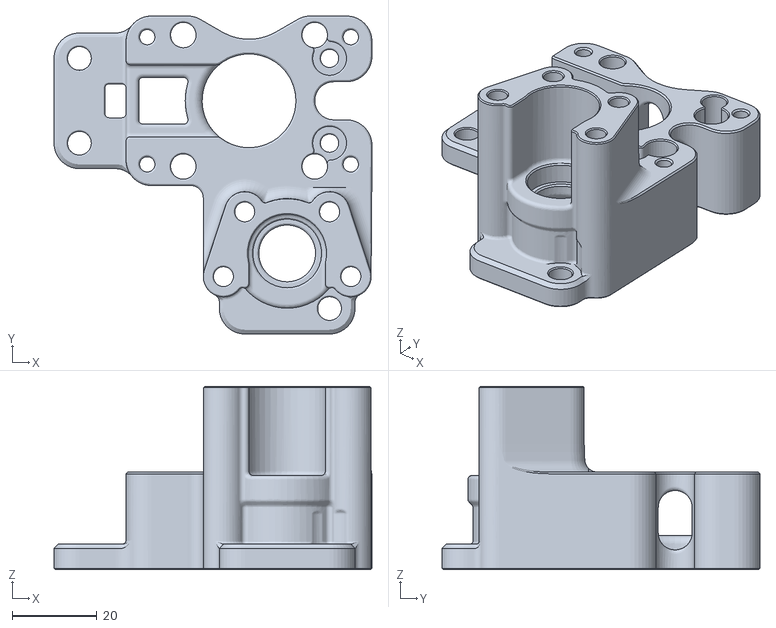
[picture p141: CAD file, 2020-08-06]
Release_1.2/STLs/XY_Gantry/short_motor_tall_idler_mount_x2_rev7.STL
75.0 x 75.0 x 43.2
