Annex-Engineering/Masherbrum-K1/Release_2_Beta/DXFs/Doors/Double_Hinge/Front_Door_200mm_x2_Rev1.DXF

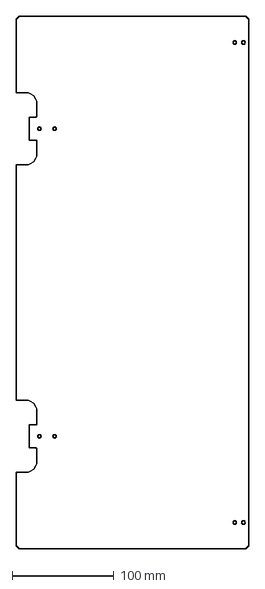
[picture p142: CAD file, 2020-11-09]
Release_2_Beta/DXFs/Doors/Double_Hinge/Front_Door_200mm_x2_Rev1.DXF
229.5 x 525.0 mm
