Annex-Engineering/Masherbrum-K1/(list of files, cad)

Other CAD files:
Release_2_2/STLs/XY_Carriage/[a]_xy_carriage_fan_mount_2_x1_rev3.stl
Release_2_2/STLs/XY_Carriage/Toolhead_Bottoms/Mosquito_and_Dragon/[a]_xy_carriage_std_fan_duct_2_x1_rev1.STL
Release_2_2/STLs/XY_Carriage/Toolhead_Bottoms/Mosquito_Mag+_and_Rapido_UHF/[a]_xy_carriage_mag+_fan_duct_1_x1_rev2.STL
Release_2_2/STLs/XY_Carriage/Toolhead_Bottoms/VolcoMosquito_and_Rapido_StandardFlow/[a]_xy_carriage_volcomosquito_fan_duct_2_x1_rev1.STL
Release_2_Beta/STLs/XY_Carriage/[a]_xy_carriage_fan_mount_2_x1_rev1.stl
Release_3_0/STLs/Electronics_Brackets/universal_dual_meanwell_uhp_psu_mounting_bracket_a_x1_rev2.STL
Release_3_0/STLs/XY_Toolhead/[a]_fan_nozzle_mag+_waterheater_combo_b_x1_rev3.STL
Release_3_0/STLs/Panel_Mounting/Front_Panel_Hinges_and_Locks/front_door_bearing_block_2_x4_rev1.STL
Release_1.2/STLs/XY_Carriage/Top_Plates/bmg_mounting_bracket_mirrored_x1_rev3.STL
Release_3_0/STLs/XY_Gantry/xy_joint_tensioner_d_x4_rev1.STL
Release_1.2/STLs/XY_Carriage/[a]_xy_carriage_fan_duct_1_bass_x1_rev1.STL
Archive/Release_1.2/CAD/BASS_Fan_Ducts.x_t
Archive/Release_1.2/CAD/FYSETC_S6_Mounting_Frame.x_t
Archive/Release_1.2/CAD/Front Door_Rev1.2-12-08-2020.x_t
Archive/Release_1.2/CAD/Piton_Probe_Assembly_11-18-2020.x_t
Archive/Release_1.2/DXFs/Doors/Triple_Hinge/Front_Door_300mm_x2_Rev2.DXF
Archive/Release_1.2/DXFs/Electronics_Box/electronics_box_side_panel_TE_power_inlet_x1_rev2.DXF
Archive/Release_1.2/DXFs/Optional_Laser_Cut_Panels/Bottom_200mm_x_200mm_Rev1.DXF
Archive/Release_1.2/DXFs/Optional_Laser_Cut_Panels/Bottom_250mm_x_250mm_Rev1.DXF
Archive/Release_1.2/DXFs/Optional_Laser_Cut_Panels/Bottom_300mm_x_300mm_Rev1.DXF
Archive/Release_1.2/DXFs/Optional_Laser_Cut_Panels/Bottom_350mm_x_350mm_Rev1.DXF
Archive/Release_1.2/DXFs/Optional_Laser_Cut_Panels/Bottom_400mm_x_400mm_Rev1.DXF
Archive/Release_1.2/DXFs/Optional_Laser_Cut_Panels/Side_200mm_x_200mm_Rev1.DXF
Archive/Release_1.2/DXFs/Optional_Laser_Cut_Panels/Side_250mm_x_250mm_Rev1.DXF
Archive/Release_1.2/DXFs/Optional_Laser_Cut_Panels/Side_300mm_x_300mm_Rev1.DXF
Archive/Release_1.2/DXFs/Optional_Laser_Cut_Panels/Side_350mm_x_350mm_Rev1.DXF
Archive/Release_1.2/DXFs/Optional_Laser_Cut_Panels/Side_400mm_x_400mm_x_400mm_Rev1.DXF
Archive/Release_1.2/DXFs/Optional_Laser_Cut_Panels/Side_400mm_x_400mm_x_600mm_Rev1.DXF
Archive/Release_1.2/DXFs/Optional_Laser_Cut_Panels/Top_200mm_x_200mm_Rev1.DXF
Archive/Release_1.2/DXFs/Optional_Laser_Cut_Panels/Top_250mm_x_250mm_Rev1.DXF
Archive/Release_1.2/DXFs/Optional_Laser_Cut_Panels/Top_300mm_x_300mm_Rev1.DXF
Archive/Release_1.2/DXFs/Optional_Laser_Cut_Panels/Top_350mm_x_350mm_Rev1.DXF
Archive/Release_1.2/DXFs/Optional_Laser_Cut_Panels/Top_400mm_x_400mm_Rev1.DXF
Archive/Release_1.2/DXFs/Panels/Back_Panel_200mm_Rev2.DXF
Archive/Release_1.2/DXFs/Panels/Back_Panel_250mm_Rev2.DXF
Archive/Release_1.2/DXFs/Panels/Back_Panel_250mm_x_250mm_x_300mm_Rev1.DXF
Archive/Release_1.2/DXFs/Panels/Back_Panel_300mm_Rev2.DXF
Archive/Release_1.2/DXFs/Panels/Back_Panel_350mm_Rev2.DXF
Archive/Release_1.2/DXFs/Panels/Back_Panel_400mm_Rev2.DXF
Archive/Release_1.2/DXFs/Panels/Back_Panel_400mm_x_400mm_x_600mm_Rev2.DXF
Archive/Release_1.2/STLs/Ballscrew_Z_Drive/MGN12C_Bearing_Blocks/z_bearing_block_solid_mgn12c_22mm_nut_x2_rev1.STL
Archive/Release_1.2/STLs/Ballscrew_Z_Drive/MGN12C_Bearing_Blocks/z_bearing_block_solid_mgn12c_24mm_nut_x2_rev1.STL
Archive/Release_1.2/STLs/Ballscrew_Z_Drive/MGN12C_Bearing_Blocks/z_bearing_block_solid_mgn12c_mirror_22mm_nut_x2_rev1.STL
Archive/Release_1.2/STLs/Ballscrew_Z_Drive/MGN12C_Bearing_Blocks/z_bearing_block_solid_mgn12c_mirror_24mm_nut_x2_rev1.STL
Archive/Release_1.2/STLs/Ballscrew_Z_Drive/MGN9H_Bearing_Blocks_(Legacy)/z_bearing_block_solid_mgn9h_22mm_nut_x2_rev1.STL
Archive/Release_1.2/STLs/Ballscrew_Z_Drive/MGN9H_Bearing_Blocks_(Legacy)/z_bearing_block_solid_mgn9h_24mm_nut_x2_rev1.STL
Archive/Release_1.2/STLs/Ballscrew_Z_Drive/MGN9H_Bearing_Blocks_(Legacy)/z_bearing_block_solid_mgn9h_mirror_22mm_nut_x2_rev1.STL
Archive/Release_1.2/STLs/Ballscrew_Z_Drive/MGN9H_Bearing_Blocks_(Legacy)/z_bearing_block_solid_mgn9h_mirror_24mm_nut_x2_rev1.STL
Archive/Release_1.2/STLs/Belted_Z_Drive/belted_z_idler_a_x4_rev1.STL
Archive/Release_1.2/STLs/Belted_Z_Drive/belted_z_idler_b_x4_rev1.STL
Archive/Release_1.2/STLs/Electronics_Brackets/[a]_electronics_box_corner_m3_inserts_x4_rev1.STL
Archive/Release_1.2/STLs/Electronics_Brackets/[a]_electronics_box_corner_m5_inserts_x4_rev3.STL
Archive/Release_1.2/STLs/Electronics_Brackets/[a]_electronics_box_m5_to_m3_screw_adapter_x24_rev1.STL
Archive/Release_1.2/STLs/Electronics_Brackets/bigtreetech_skr_mounting_bracket_x2_rev3.STL
Archive/Release_1.2/STLs/Electronics_Brackets/duet2_+_duex5_mounting_bracket_x2_rev2.STL
Archive/Release_1.2/STLs/Electronics_Brackets/fysetc_s6_mounting_bracket_with_motor_expander_x1_rev2.STL
Archive/Release_1.2/STLs/Electronics_Brackets/fysetc_s6_mounting_bracket_x2_rev3.STL
Archive/Release_1.2/STLs/Electronics_Brackets/orangepi_lite_mounting_bracket_x1_rev1.STL
Archive/Release_1.2/STLs/Electronics_Brackets/raspberrypi_mounting_bracket_for_heatsink_x1_rev1.STL
Archive/Release_1.2/STLs/Electronics_Brackets/raspberrypi_mounting_bracket_x1_rev1.STL
Archive/Release_1.2/STLs/Jigs_and_Fixtures/[a]_mgn12_altz_rail_alignment_tool_x3_rev1.STL
Archive/Release_1.2/STLs/Jigs_and_Fixtures/[a]_mgn15_altz_rail_alignment_tool_x3_rev1.STL
Archive/Release_1.2/STLs/Jigs_and_Fixtures/[a]_mgn9_altz_rail_alignment_tool_x3_rev1.STL
Archive/Release_1.2/STLs/Jigs_and_Fixtures/[a]_mgn9_rail_install_tool_2040_x3_rev2.STL
Archive/Release_1.2/STLs/Mesh_Bed_Probe/Piton_Probe/[a]_piton_probe_cap_6x3_x1_rev2.STL
Archive/Release_1.2/STLs/Mesh_Bed_Probe/Piton_Probe/piton_magnetic_probe_dock_6x3_x1_rev3.STL
Archive/Release_1.2/STLs/Misc/z_endstop_brush_mount_x1_rev1.STL
Archive/Release_1.2/STLs/Misc/z_endstop_housing_key_x1_rev1.STL
Archive/Release_1.2/STLs/XY_Carriage/Tool_Mounts/xy_carriage_tl_dragon_tool_mount_x1_rev3.STL
Archive/Release_1.2/STLs/XY_Carriage/Top_Plates/bmg_mounting_bracket_mirrored_x1_rev3.STL
Archive/Release_1.2/STLs/XY_Carriage/[a]_xy_carriage_fan_duct_1_bass_x1_rev1.STL
Archive/Release_1.2/STLs/XY_Carriage/[a]_xy_carriage_fan_duct_1_high_flow_x1_rev2.STL
Archive/Release_1.2/STLs/XY_Carriage/[a]_xy_carriage_fan_duct_2_high_flow_x1_rev2.STL
Archive/Release_1.2/STLs/XY_Carriage/[a]_xy_carriage_fan_mount_1_x1_rev5.STL
Archive/Release_1.2/STLs/XY_Carriage/[a]_xy_carriage_fan_mount_2_x1_rev5.stl
Archive/Release_1.2/STLs/XY_Carriage/xy_carriage_cable_anchor_x1_rev3.STL
Archive/Release_1.2/STLs/XY_Carriage/xy_carriage_magnetic_probe_holder_x1_rev4.STL
Archive/Release_1.2/STLs/XY_Carriage/xy_carriage_vertical_member_1_x1_rev4.STL
Archive/Release_1.2/STLs/XY_Carriage/xy_carriage_vertical_member_2_x1_rev4.STL
Archive/Release_1.2/STLs/XY_Gantry/[a]_xy_top_cap_x4_rev2.STL
Archive/Release_1.2/STLs/XY_Gantry/motor_idler_top_plate_x4_rev1.STL
Archive/Release_1.2/STLs/XY_Gantry/tall_motor_short_idler_mount_x2_rev7.STL
Archive/Release_1.2/STLs/XY_Gantry/xy_rail_holder_x4_rev4.STL
Archive/Release_1/STLs/Panel_Mounting/Front_Panel_Hinges_and_Locks/Hinges/[a]_hinge_arm_6mm_x2_rev1.STL
Archive/Release_1/STLs/Panel_Mounting/Front_Panel_Hinges_and_Locks/Hinges/hinge_frame_bottom_6mm_x2_rev1.STL
Archive/Release_1/STLs/Panel_Mounting/Front_Panel_Hinges_and_Locks/Hinges/hinge_frame_top_6mm_x2_rev1.STL
Archive/Release_1/STLs/Panel_Mounting/Front_Panel_Hinges_and_Locks/Locks/[a]_latch_rhs_6mm_x2_Rev1.stl
Archive/Release_1/STLs/Panel_Mounting/Front_Panel_Hinges_and_Locks/Locks/[a]_lock_lever_rhs_x2_Rev1.stl
Archive/Release_1/STLs/Panel_Mounting/Front_Panel_Hinges_and_Locks/Locks/lock_body_6mm_x2_Rev1.stl
Archive/Release_2_0_1/CAD/Print_Beds/K1+K2_Bed_200x200.x_t
Archive/Release_2_0_1/CAD/Print_Beds/K1+K2_Bed_250x250.x_t
Archive/Release_2_0_1/CAD/Print_Beds/K1+K2_Bed_300x300.x_t
Archive/Release_2_0_1/CAD/Print_Beds/K1+K2_Bed_350x350.x_t
Archive/Release_2_0_1/CAD/Print_Beds/K1+K2_Bed_400x400.x_t
Archive/Release_2_0_1/CAD/Print_Beds/K1+K2_Bed_450x450.x_t
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
