Annex-Engineering/Masherbrum-K1/(threads)

Thread 1 (2021-03-19):

Release 2 CAD Assembly?

CCS86, 2021-03-19:
Hi guys, is a Release 2 CAD Assembly on the way?

I am new to this project and want to check out some of the details. Thanks!

Annex-Engineering, 2021-03-19:
we do not publish cad unless the "product" is in a full released state. this prevents fragmentation, etc in our user base.

files will ship with the full "Release 2" flag. There are a few internal issues holding things up at this time.

In the mean time, we suggest using the edrawings files.

Closed 2021-03-19.

Thread 2 (2022-01-10):

electronics_box_side_panel_decorative_x3_rev2.DXF has detail smaller than 1/8 aka 0.125 inch in size

richardk3nt, 2022-01-10:
After I uploaded the electronics_box_side_panel_decorative_x3_rev2.DXF to sendcutsend to be cut from 1/8" / 3.2mm ABS the provided the following feedback.  I asked them to delete the feature from the drawing.  I bring this up as it holds up the order and they seem slow to respond/update the drawing.  Hopefully getting this changed will save the next person a bit of turnaround time.

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

Trails5000, 2022-06-15:
design obsoleted, has been removed, somehow missed this issue

Closed 2022-06-15.

Thread 5 (2023-02-25):

Wrong number of motors

m-sundman, 2023-02-25:
The stats on all your printers are claiming there's only 4 motors, when there seems to be 8, plus 1 in the extruder.

heqsde, 2023-04-05:
The 4 motors are the XY ones it says 2 per X and 2 per Y. It is talking about the gantry motion system.
