Annex-Engineering/Masherbrum-K1/Release_3_0/Wiring_Schematics/K1_&_K2_AC_DC_Wiring_Schematic.pdf

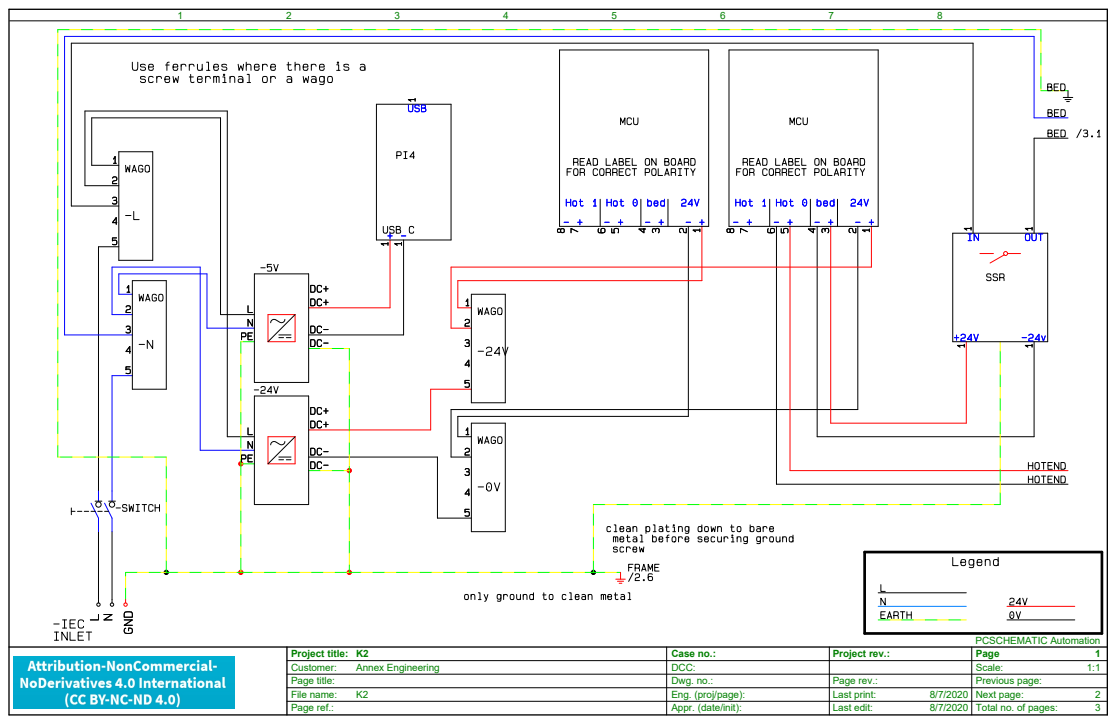
[picture p143: page 1]
PCSCHEMATIC Automation

Project title: K2 | Case no.: | Project rev.: | Page 1
Customer: Annex Engineering | DCC: | | Scale: 1:1
Page title: | Dwg. no.: | Page rev.: | Previous page:
File name: K2 | Eng. (proj/page): | Last print: 8/7/2020 | Next page: 2
Page ref.: | Appr. (date/init): | Last edit: 8/7/2020 | Total no. of pages: 3

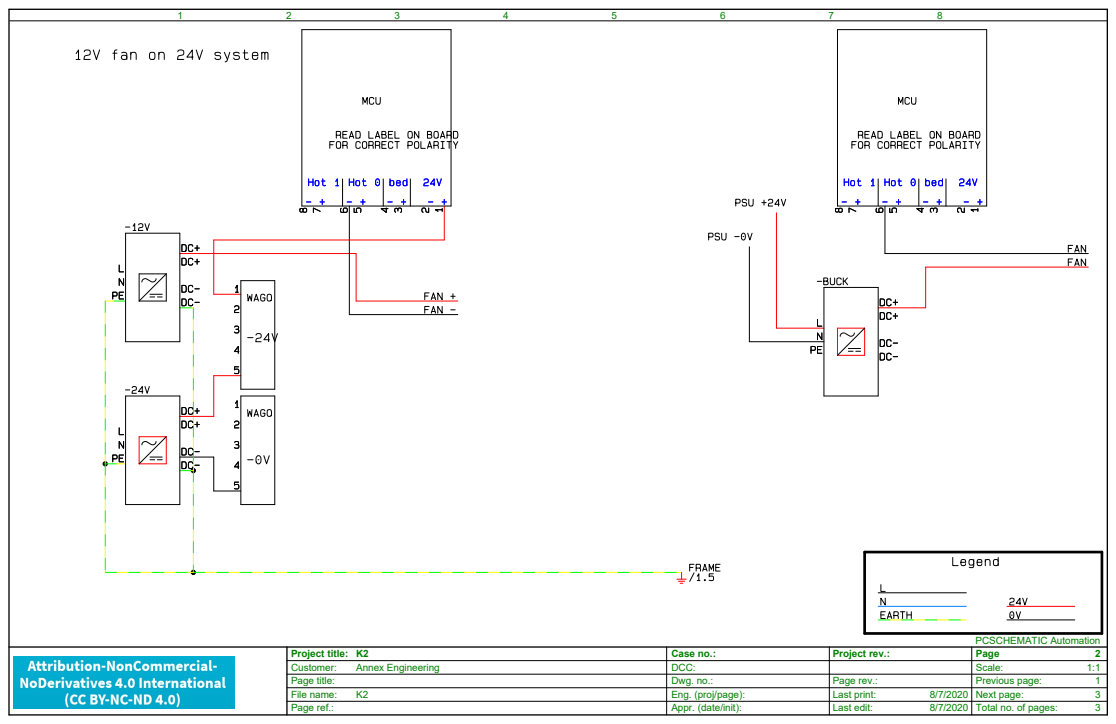
[picture p144: page 2]
PCSCHEMATIC Automation

Project title: K2 | Case no.: | Project rev.: | Page 2
Customer: Annex Engineering | DCC: | | Scale: 1:1

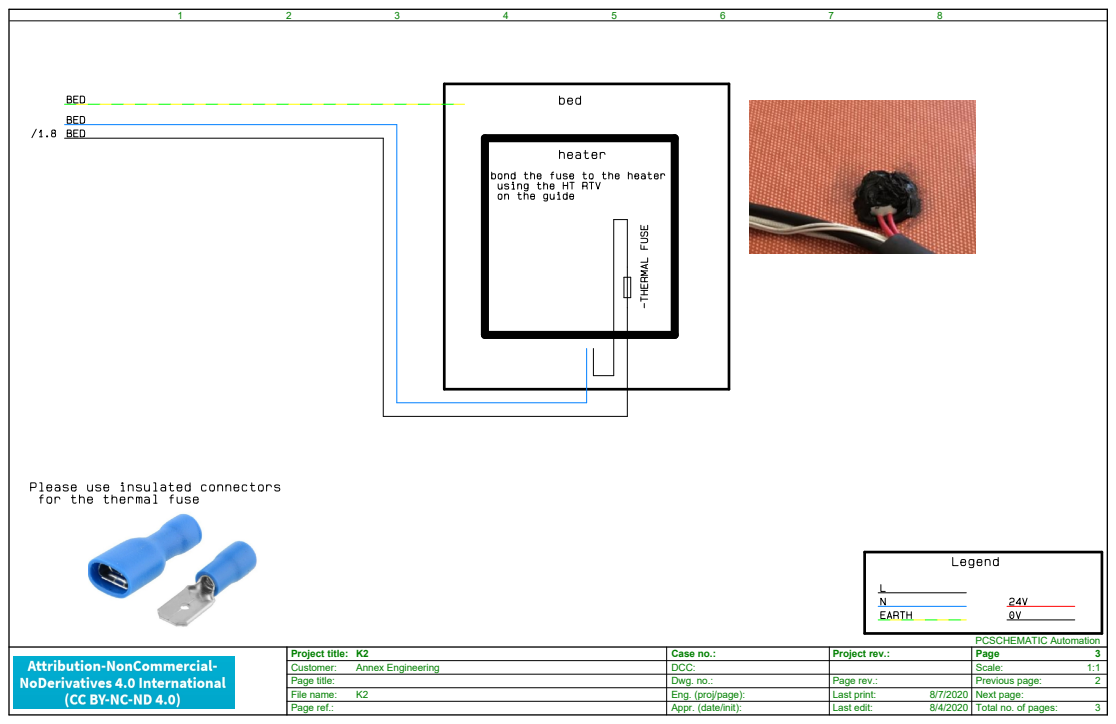
[picture p145: page 3]
PCSCHEMATIC Automation

Project title: K2 | Case no.: | Project rev.: | Page 3
Customer: Annex Engineering | DCC: | | Scale: 1:1
