Annex-Engineering/Masherbrum-K1/Release_3_0/PCBs/K1K2-carabiner-round_heatsink/K1+K2 Carabiner for Round Heatsinks.kicad_pcb

## KiCad design Release_3_0/PCBs/K1K2-carabiner-round_heatsink/K1+K2 Carabiner for Round Heatsinks.kicad_pcb (2024-04-17)

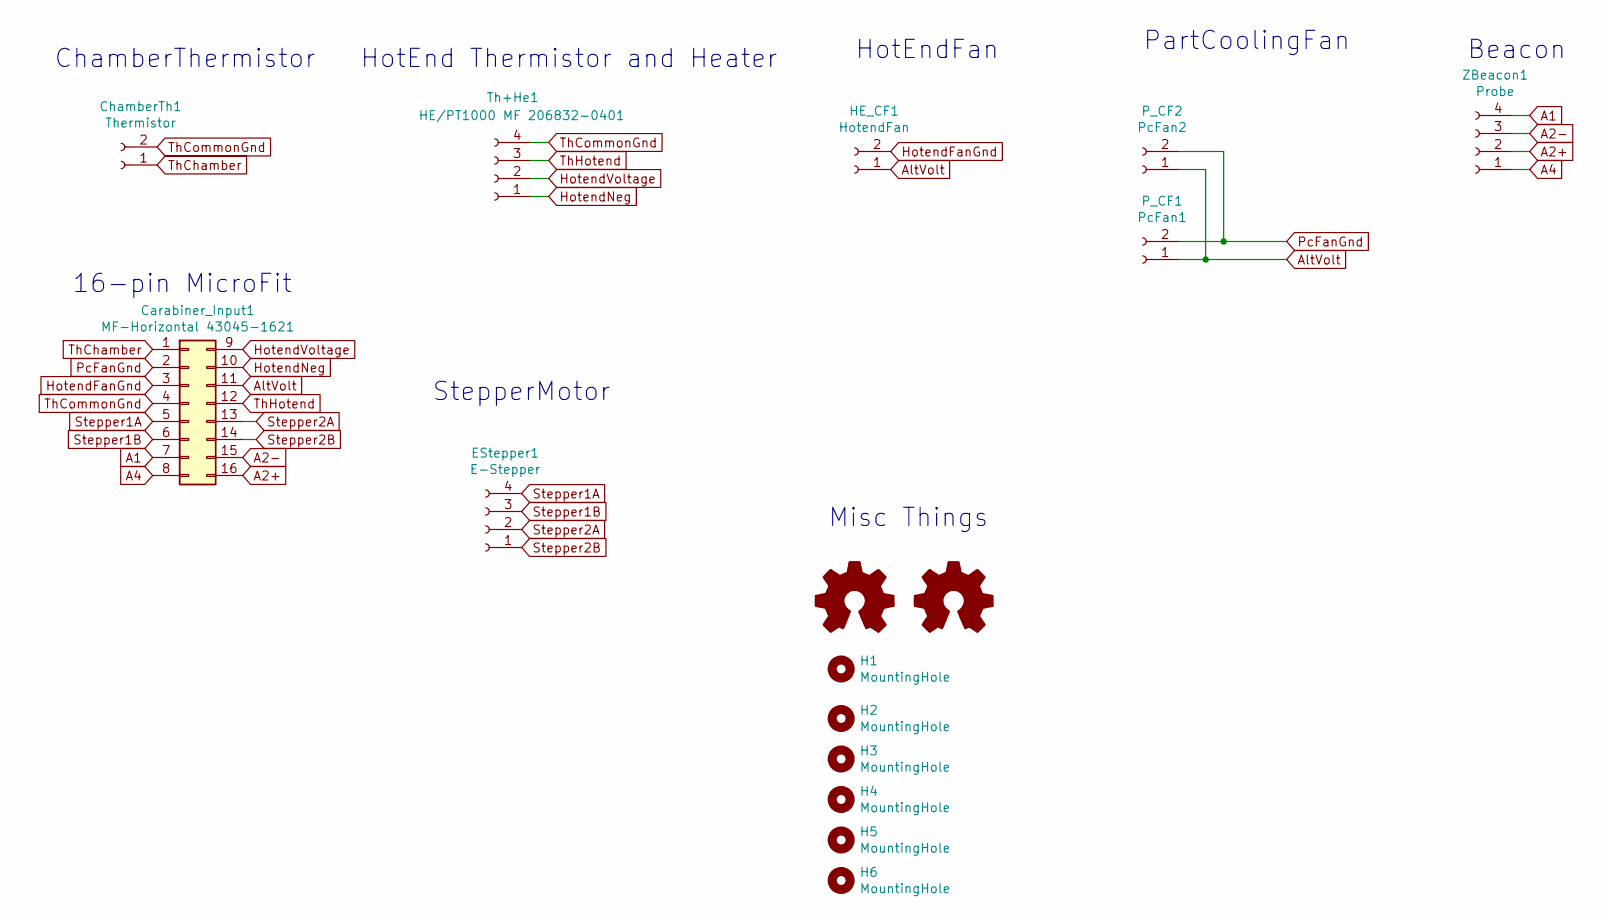
[picture p146: schematic K1+K2 Carabiner for Round Heatsinks.kicad_sch]

Parts:
Carabiner_Input1: MF-Horizontal 43045-1621; Molex_Micro-Fit_3.0_43045-1600_2x08_P3.00mm_Horizontal
ChamberTh1: Thermistor; 0603_to_1206_THT
EStepper1: E-Stepper; JST_XH_B4B-XH-A_1x04_P2.50mm_Vertical
H1, H2: MountingHole; MountingHole_4.5mm_Pad
H3, H4, H5, H6: MountingHole; MountingHole_3.5mm_Pad
HE_CF1: HotendFan; JST_XH_B2B-XH-A_1x02_P2.50mm_Vertical
LOGO1, LOGO2: Logo_Open_Hardware_Small; AnnexLogoFSilk
P_CF1: PcFan1; JST_XH_B2B-XH-A_1x02_P2.50mm_Vertical
P_CF2: PcFan2; JST_XH_B2B-XH-A_1x02_P2.50mm_Vertical
Th+He1: HE/PT1000 MF 206832-0401; Molex_Micro-Fit_3.0_43045-0412_2x02_P3.00mm_Vertical
ZBeacon1: Probe; JST_XH_B4B-XH-A_1x04_P2.50mm_Vertical

Connections:
A1: Carabiner_Input1.7, ZBeacon1.4
A2+: Carabiner_Input1.16, ZBeacon1.2
A2-: Carabiner_Input1.15, ZBeacon1.3
A4: Carabiner_Input1.8, ZBeacon1.1
AltVolt: Carabiner_Input1.11, HE_CF1.1, P_CF1.1, P_CF2.1
HotendFanGnd: Carabiner_Input1.3, HE_CF1.2
HotendNeg: Carabiner_Input1.10, Th+He1.1
HotendVoltage: Carabiner_Input1.9, Th+He1.2
PcFanGnd: Carabiner_Input1.2, P_CF1.2, P_CF2.2
Stepper1A: Carabiner_Input1.5, EStepper1.4
Stepper1B: Carabiner_Input1.6, EStepper1.3
Stepper2A: Carabiner_Input1.13, EStepper1.2
Stepper2B: Carabiner_Input1.14, EStepper1.1
ThChamber: Carabiner_Input1.1, ChamberTh1.1
ThCommonGnd: Carabiner_Input1.4, ChamberTh1.2, Th+He1.4
ThHotend: Carabiner_Input1.12, Th+He1.3

Notes on the sheet:
HotEndFan
Beacon
16-pin MicroFit
HotEnd Thermistor and Heater
StepperMotor
Misc Things
PartCoolingFan
ChamberThermistor

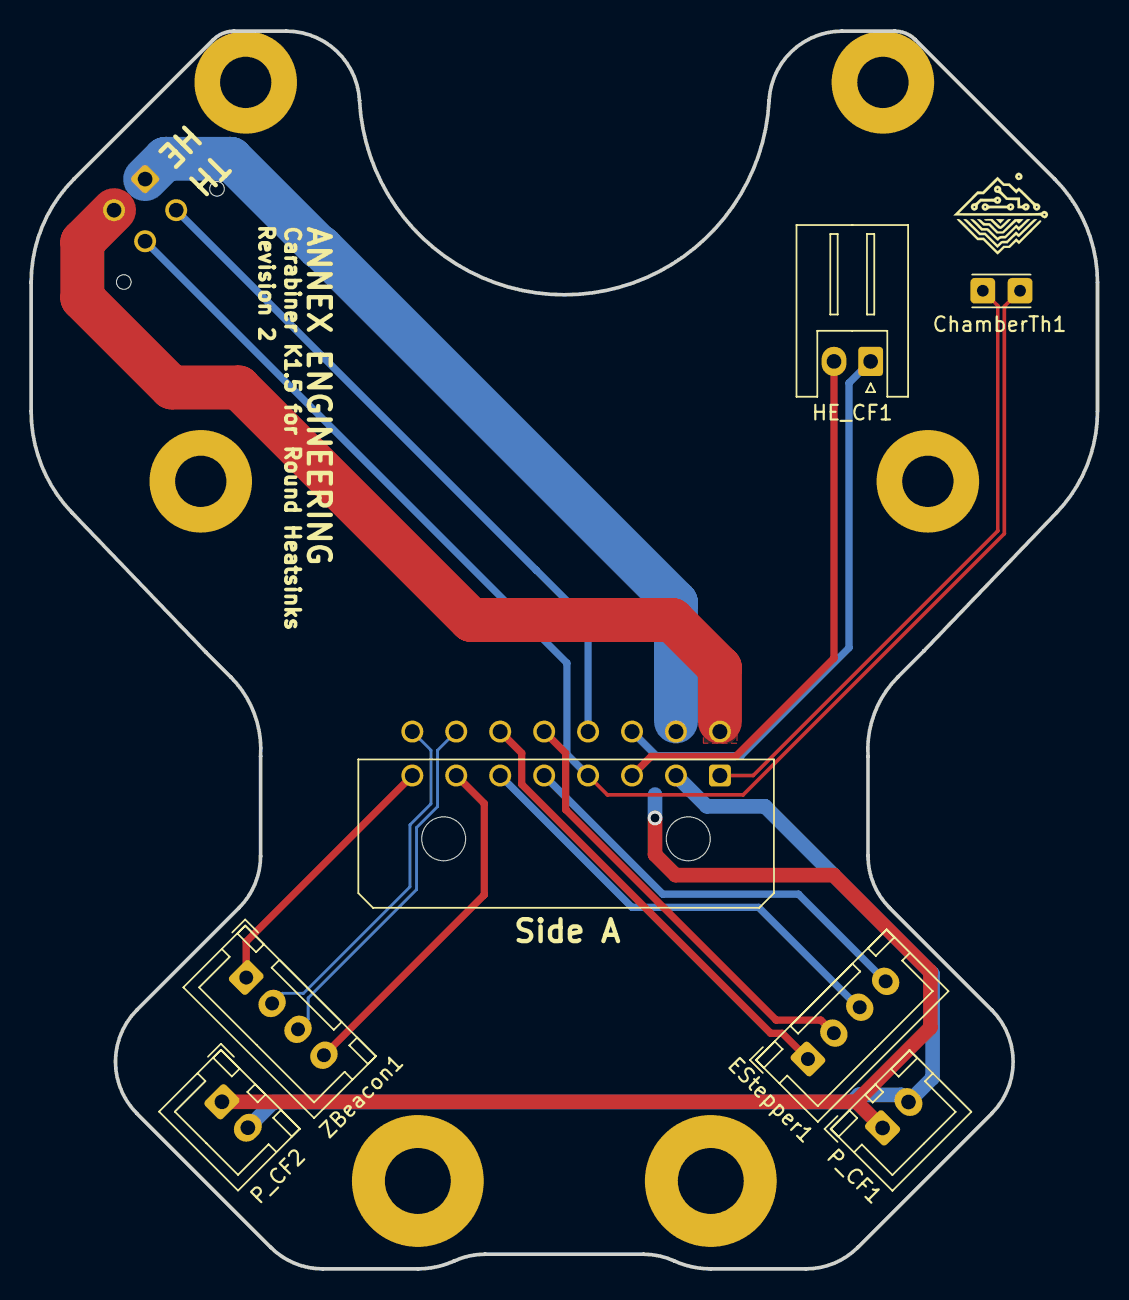
[picture p147: board K1+K2 Carabiner for Round Heatsinks.kicad_pcb from above]

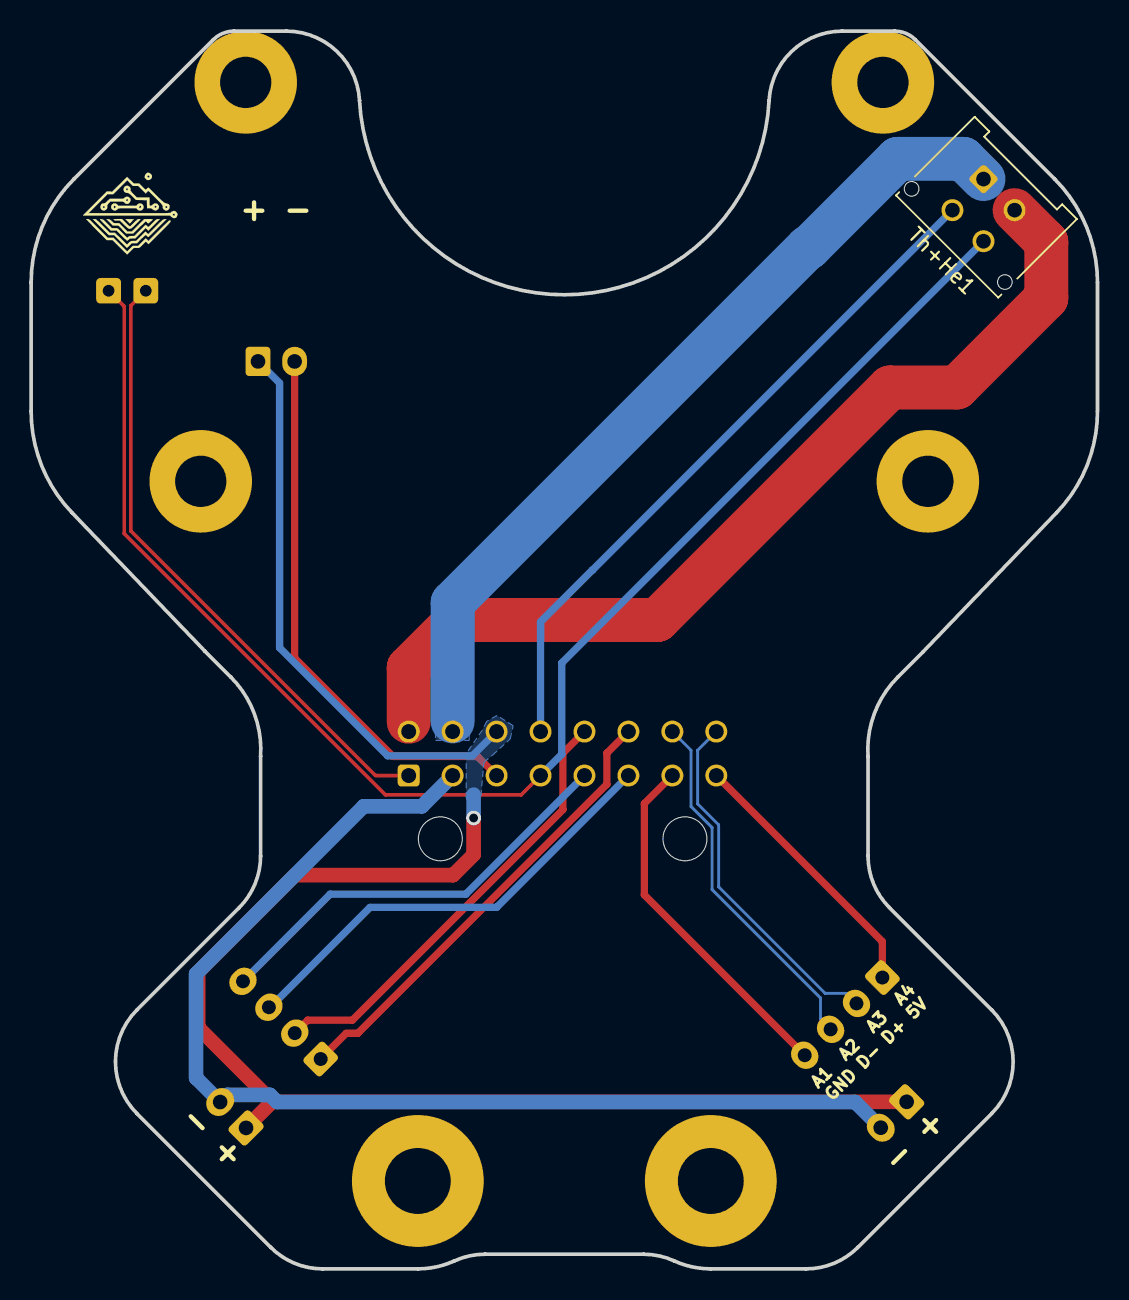
[picture p148: board K1+K2 Carabiner for Round Heatsinks.kicad_pcb from below]

Board: 2 copper layers, 72.8 x 84.5 mm, 16 parts (2 on the bottom side), 16 nets.
