Annex-Engineering/Masherbrum-K1/(commit log)

2020-02-11 prep for alpha1
    [Back_Skirt_200mm_Rev1.DXF, Back_Skirt_250mm_Rev1.DXF, Back_Skirt_300mm_Rev1.DXF, Back_Skirt_350mm_Rev1.DXF, Back_Skirt_400mm_Rev1.DXF, Electronics_Deck_Panel_NEMA17_200mm_Rev1.DXF, Electronics_Deck_Panel_NEMA17_250mm_Rev1.DXF, Electronics_Deck_Panel_NEMA17_300mm_Rev1.DXF]
2020-02-12 reduce chamfer to build plate on fan ducts
    slic3r wouldnt print first layer properly, part was only tested with kisslicer
    [[a]_x_carriage_fan_duct_1_x1_rev1.STL, [a]_x_carriage_fan_duct_1_x1_rev2.STL, [a]_x_carriage_fan_duct_2_x1_rev1.stl, [a]_x_carriage_fan_duct_2_x1_rev2.stl]
2020-02-12 add nema23 z drive motor mounts
    [z_motor_spacer_NEMA17_x4_rev2.STL, z_motor_spacer_NEMA23_x4_rev1.STL]
2020-02-12 add nema23 electronics panels
    [Electronics_Deck_Panel_NEMA23_200mm_Rev1.DXF, Electronics_Deck_Panel_NEMA23_250mm_Rev1.DXF, Electronics_Deck_Panel_NEMA23_300mm_Rev1.DXF, Electronics_Deck_Panel_NEMA23_350mm_Rev1.DXF, Electronics_Deck_Panel_NEMA23_400mm_Rev1.DXF]
2020-02-12 correct print cooling fan pin
    wasnt on z mcu
    [K1_bigtree_skr_1.3_config-250mm_x_250mm_x_250mm_build.cfg]
2020-02-12 add k1 rail install tool
    [[a]_mgn9_rail_install_tool_x3_rev1.STL]
2020-02-12 x and y motor currents did not match
    [K1_bigtree_skr_1.3_config-250mm_x_250mm_x_250mm_build.cfg]
2020-02-12 correct homing direction and max axis extents for x and y
    [K1_bigtree_skr_1.3_config-250mm_x_250mm_x_250mm_build.cfg]
2020-02-12 more config changes
    probe speed too fast, remove un-used macros, enable heated bed turning off at end of print, enable motors off at end of print
    [K1_bigtree_skr_1.3_config-250mm_x_250mm_x_250mm_build.cfg]
2020-02-12 add tie-bar feature to motor mounts with no support requirements
    add tie-bar feature to motor mounts with no support requirements
    [short_motor_tall_idler_mount_x2_rev2.STL, short_motor_tall_idler_mount_x2_rev3.STL, tall_motor_short_idler_mount_x2_rev2.STL, tall_motor_short_idler_mount_x2_rev3.STL, z_motor_spacer_NEMA17_x4_rev2.STL, z_motor_spacer_NEMA17_x4_rev3.STL]
2020-02-12 z microswitch gantry endstop clearance fix
    [z_microswitch_plate_x4_rev1.STL, z_microswitch_plate_x4_rev2.STL]
2020-02-18 reduce material + increase strength in foot to frame mount
    reduce material + increase strength in foot to frame mount
    [squash_ball_foot_to_frame_bracket_x4_rev1.STL, squash_ball_foot_to_frame_bracket_x4_rev2.STL]
2020-02-19 duet3 + addon board mounting brackets
    [duet3_3hc_mounting_bracket_x1_rev1.STL, duet3_6hc_mainboard_mounting_bracket_x1_rev1.STL]
2020-02-19 add toolhead distribution board mounting bracket for duet3
    [duet3_toolhead_distribution_board_mounting_bracket_x1_rev1.STL]
2020-02-24 z endstop key was sized for 3030 not 2020
    [z_endstop_and_purgescrub_bucket_key_x1_rev1.STL, z_endstop_and_purgescrub_bucket_key_x1_rev2.STL]
2020-02-24 fix part orientation
    [z_endstop_and_purgescrub_bucket_key_x1_rev2.STL]
2020-02-26 mounting holes were at 10.4mm, corrected to 10mm
    [bigtreetech_skr_mounting_bracket_x2_rev1.STL, bigtreetech_skr_mounting_bracket_x2_rev2.STL, duet2_+_duex5_mounting_bracket_x2_rev1.STL, duet2_+_duex5_mounting_bracket_x2_rev2.STL, duet3_3hc_mounting_bracket_x1_rev1.STL, duet3_3hc_mounting_bracket_x1_rev2.STL, duet3_6hc_mainboard_mounting_bracket_x1_rev1.STL, duet3_6hc_mainboard_mounting_bracket_x1_rev2.STL]
2020-03-03 was missing underscore in config
    [K1_bigtree_skr_1.3_config-250mm_x_250mm_x_250mm_build.cfg]
2020-03-05 fix incorrect pin definitions
    fix incorrect pin definitions
    [K1_bigtree_skr_1.3_config-250mm_x_250mm_x_250mm_build.cfg]
2020-03-08 new xy top plate, new fan mounts for more clearance around ascender
    [[a]_duet3_toolboard_holder_x1_rev1.STL, [a]_x_carriage_fan_mount_1_x1_rev1.STL, [a]_x_carriage_fan_mount_2_x1_rev1.stl, [a]_xy_carriage_fan_duct_1_x1_rev2.STL, [a]_xy_carriage_fan_duct_2_x1_rev2.stl, [a]_xy_carriage_fan_mount_1_x1_rev2.STL, [a]_xy_carriage_fan_mount_2_x1_rev2.stl, x_carriage_top_plate_x1_rev1.STL]
2020-03-10 add thru bolts to gantry towers per team member suggestion
    [[a]_bearing_cap_x4.STL, [a]_bearing_cap_x4_rev2.STL, short_motor_tall_idler_mount_x2_rev3.STL, short_motor_tall_idler_mount_x2_rev4.STL, tall_motor_short_idler_mount_x2_rev3.STL, tall_motor_short_idler_mount_x2_rev4.STL]
2020-03-11 z drive motor posts to thru bolt recinforced
    [z_motor_spacer_NEMA17_x3_rev4.STL, z_motor_spacer_NEMA17_x4_rev3.STL, z_motor_spacer_NEMA23_x3_rev2.STL, z_motor_spacer_NEMA23_x4_rev1.STL]
2020-03-11 replace dxfs for top panel to reference 45deg rotated nema17
    [Electronics_Deck_Panel_NEMA17_200mm_Rev2.DXF, Electronics_Deck_Panel_NEMA17_250mm_Rev2.DXF, Electronics_Deck_Panel_NEMA17_300mm_Rev2.DXF, Electronics_Deck_Panel_NEMA17_350mm_Rev2.DXF, Electronics_Deck_Panel_NEMA17_400mm_Rev2.DXF]
2020-03-11 wrong quantity
    [z_motor_spacer_NEMA17_x3_rev4.STL, z_motor_spacer_NEMA17_x4_rev4.STL, z_motor_spacer_NEMA23_x4_rev2.STL]
2020-03-11 bolt in too from the underside, no more requirement to remove extruder to swap tool
    [xy_carriage_top_plate_x1_rev2.STL, xy_carriage_top_plate_x1_rev3.STL, xy_carriage_v6_tool_mount_1_x1_rev1.STL, xy_carriage_v6_tool_mount_1_x1_rev2.STL, xy_carriage_v6_tool_mount_2_x1_rev1.STL, xy_carriage_v6_tool_mount_2_x1_rev2.STL, xy_carriage_volcano_tool_mount_1_x1_rev1.STL, xy_carriage_volcano_tool_mount_1_x1_rev2.STL]
2020-03-11 unify bed design between printers
2020-03-12 add front panel hinges
    [[a]_hinge_arm_6mm_x2_rev1.STL, [a]_latch_lhs_6mm_x3_Rev1.stl, [a]_latch_rhs_6mm_x2_Rev1.stl, [a]_latch_rhs_6mm_x3_Rev1.stl, [a]_lock_lever_lhs_x3_Rev1.stl, [a]_lock_lever_rhs_x2_Rev1.stl, [a]_lock_lever_rhs_x3_Rev1.stl, hinge_frame_bottom_6mm_x2_rev1.STL]
2020-03-15 add magnetic z probe
    add magnetic z probe
    [[a]_xy_carriage_magnetic_probe_microswitch_mount_x1_rev1.STL, xy_carriage_magnetic_probe_holder_x1_rev1.STL]
2020-03-16 add TL Dragon Hotend Holder
    [xy_carriage_tl_dragon_tool_mount_x1_rev1.STL]
2020-03-17 add magnetic z switch probe dock
    [[a]_xy_carriage_magnetic_probe_microswitch_mount_x1_rev1.STL, magnetic_probe_dock_x1_rev1.STL]
2020-03-18 add mosquito support
    [[a]_xy_carriage_fan_duct_1_x1_rev2.STL, [a]_xy_carriage_fan_duct_1_x1_rev3.STL, [a]_xy_carriage_fan_duct_2_x1_rev2.stl, [a]_xy_carriage_fan_duct_2_x1_rev3.stl, xy_carriage_mosquito_tool_mount_x1_rev1.STL, xy_carriage_tl_dragon_tool_mount_x1_rev1.STL, xy_carriage_tl_dragon_tool_mount_x1_rev2.STL]
2020-03-19 add emergency bed/gantry overtravel stops to prevent mechanical damage in the event of a nozzle crash
    [z_overtravel_e_stop_x4_rev1.STL]
2020-03-24 add initial revision of BMG support to toolhead
    add initial revision of BMG support to toolhead
    [[a]_duet3_toolboard_holder_x1_rev1.STL, [a]_duet3_toolboard_holder_x1_rev2.STL, [a]_xy_carriage_fan_duct_1_x1_rev3.STL, [a]_xy_carriage_fan_duct_1_x1_rev4.STL, [a]_xy_carriage_fan_duct_2_x1_rev3.stl, [a]_xy_carriage_fan_duct_2_x1_rev4.stl, [a]_xy_carriage_fan_mount_1_x1_rev2.STL, [a]_xy_carriage_fan_mount_1_x1_rev3.STL]
2020-03-25 add meanwell UHP-350-24 Mounting Bracket
    add meanwell UHP-350-24 Mounting Bracket
    [meanwell_uhp_350_24_psu_mounting_bracket_x2_rev1.STL]
2020-03-26 add 24VDC wago mount, add label to 120VAC wago mount
    [wago_221_2x_mount_5_conductor_24VDC_x1_rev1.STL, wago_221_3x_mount_5_conductor_120VAC_x1_rev1.STL, wago_221_mount_5_conductor_png_x1_rev1.STL]
2020-03-29 simplify gantry joint interface, lengthen nema towers for z by 5mm
    [Side_Skirt_200mm_x2_Rev2.DXF, Side_Skirt_200mm_x2_Rev3.DXF, Side_Skirt_250mm_x2_Rev2.DXF, Side_Skirt_250mm_x2_Rev3.DXF, Side_Skirt_300mm_x2_Rev2.DXF, Side_Skirt_300mm_x2_Rev3.DXF, Side_Skirt_350mm_x2_Rev2.DXF, Side_Skirt_350mm_x2_Rev3.DXF]
2020-03-29 xy tower had m5 clearance hole, should have been m4 clearance hole
    xy tower had m5 clearance hole, should have been m4 clearance hole
    [[a]_bearing_cap_x4_rev2.STL, [a]_bearing_cap_x4_rev3.STL, short_motor_tall_idler_mount_x2_rev4.STL, short_motor_tall_idler_mount_x2_rev5.STL, tall_motor_short_idler_mount_x2_rev4.STL, tall_motor_short_idler_mount_x2_rev5.STL]
2020-03-29 improve printability of z tower nema17 version
    improve printability of z tower nema17 version
    [z_motor_spacer_NEMA17_x4_rev6.STL]
2020-03-29 thicken walls of part cooling ducts, add flange to aid in printing
    [[a]_xy_carriage_fan_duct_1_x1_rev4.STL, [a]_xy_carriage_fan_duct_1_x1_rev5.STL, [a]_xy_carriage_fan_duct_2_x1_rev4.stl, [a]_xy_carriage_fan_duct_2_x1_rev5.stl]
2020-03-29 add support for deeper threaded inserts on fan mount
    add support for deeper threaded inserts on fan mount
    [[a]_xy_carriage_fan_mount_1_x1_rev3.STL, [a]_xy_carriage_fan_mount_1_x1_rev4.STL, [a]_xy_carriage_fan_mount_2_x1_rev3.stl, [a]_xy_carriage_fan_mount_2_x1_rev4.stl]
2020-03-31 remote sharp point from part cooling duct, printability
    [[a]_xy_carriage_fan_duct_1_x1_rev5.STL, [a]_xy_carriage_fan_duct_1_x1_rev6.STL, [a]_xy_carriage_fan_duct_2_x1_rev5.stl, [a]_xy_carriage_fan_duct_2_x1_rev6.stl]
2020-03-31 update toolhead render
    update toolhead render
2020-04-02 tighten xy rail block, new z tower to more easily replace and remove nema17 motor
    [xy_rail_holder_x4_rev1.STL, xy_rail_holder_x4_rev2.STL, z_motor_spacer_NEMA17_1_x3_rev1.STL, z_motor_spacer_NEMA17_2_x3_rev1.STL, z_motor_spacer_NEMA17_x4_rev6.STL]
2020-04-02 z tower quantity was wrong
    [z_motor_spacer_NEMA17_1_x4_rev1.STL, z_motor_spacer_NEMA17_2_x4_rev1.STL]
2020-04-02 extend nema17 main body by 4mm, too short. Fix wrong configuration xy rail holder
    [xy_rail_holder_x4_rev2.STL, z_motor_spacer_NEMA17_1_x4_rev1.STL, z_motor_spacer_NEMA17_1_x4_rev2.STL]
2020-04-03 new, more user service-able motor towers for XY axis
    new, more user service-able motor towers for XY axis
    [[a]_bearing_cap_x4_rev3.STL, [a]_bearing_cap_x4_rev4.STL, short_motor_tall_idler_mount_1_x2_rev1.STL, short_motor_tall_idler_mount_2_x2_rev1.STL, short_motor_tall_idler_mount_x2_rev5.STL, tall_motor_short_idler_mount_1_x2_rev1.STL, tall_motor_short_idler_mount_2_x2_rev1.STL, tall_motor_short_idler_mount_x2_rev5.STL]
2020-04-04 solidify top cap, was too weak
    [[a]_xy_top_cap_x4_rev1.STL, [a]_xy_top_cap_x4_rev2.STL]
2020-04-04 enlarge clearance holes on motor plate to motor base screws
    enlarge clearance holes on motor plate to motor base screws
    [motor_idler_top_plate_x4_rev1.STL, short_motor_tall_idler_mount_2_x2_rev1.STL, short_motor_tall_idler_mount_x2_rev2.STL, tall_motor_short_idler_mount_1_x2_rev1.STL, tall_motor_short_idler_mount_2_x2_rev1.STL, tall_motor_short_idler_mount_x2_rev2.STL]
2020-04-04 add sharp corner clearance to xy rail holder, stress relief
    add sharp corner clearance to xy rail holder, stress relief
    [xy_rail_holder_x4_rev2.STL, xy_rail_holder_x4_rev3.STL]
2020-04-04 move z motors into chamber, delete dide skirts, replace with 1 panel, extra side frame stiffening, update edrawing to match K2 gantry
    move z motors into chamber, delete dide skirts, replace with 1 panel, extra side frame stiffening, update edrawing to match K2 gantry
    [Electronics_Deck_Panel_200mm_Rev3.DXF, Electronics_Deck_Panel_250mm_Rev3.DXF, Electronics_Deck_Panel_300mm_Rev3.DXF, Electronics_Deck_Panel_350mm_Rev3.DXF, Electronics_Deck_Panel_400mm_Rev3.DXF, Electronics_Deck_Panel_NEMA17_250mm_Rev2.DXF, Electronics_Deck_Panel_NEMA17_350mm_Rev2.DXF, Electronics_Deck_Panel_NEMA17_400mm_Rev2.DXF]
2020-04-10 lighten/refactor mosquito mount
    supports 30 and 40mm fan with adapter, hotend rotated 90deg
    [xy_carriage_mosquito_tool_mount_x1_rev2.STL, xy_carriage_mosquito_tool_mount_x1_rev3.STL]
2020-04-12 refactor xy carriage, add lightness and air
    refactor xy carriage, add lightness and air
    [[a]_xy_carriage_fan_duct_1_x1_rev6.STL, [a]_xy_carriage_fan_duct_1_x1_rev7.STL, [a]_xy_carriage_fan_duct_2_x1_rev6.stl, [a]_xy_carriage_fan_duct_2_x1_rev7.stl, xy_carriage_cable_anchor_x1_rev1.STL, xy_carriage_magnetic_probe_holder_x1_rev1.STL, xy_carriage_magnetic_probe_holder_x1_rev2.STL, xy_carriage_panasonic_probe_holder_x1_rev1.STL]
2020-04-14 remove duet toolboard mount, tweak length and clearance on cable anchor on x carriage, add magnet removal holes to probe pickup
    [[a]_duet3_toolboard_holder_x1_rev2.STL, xy_carriage_cable_anchor_x1_rev1.STL, xy_carriage_cable_anchor_x1_rev2.STL, xy_carriage_magnetic_probe_holder_x1_rev2.STL, xy_carriage_magnetic_probe_holder_x1_rev3.STL]
2020-04-16 z config tweaks, square corner velocity tweaks
    [K1_bigtree_skr_1.3_config-250mm_x_250mm_x_250mm_build.cfg]
2020-04-16 stiffen bmg mounting bracket
    [bmg_mounting_bracket_x1_rev1.STL, bmg_mounting_bracket_x1_rev2.STL]
2020-04-18 fix non-manifold parts
    fix non-manifold parts
    [[a]_xy_carriage_fan_duct_2_x1_rev7.stl]
2020-04-19 dual xy switch drive tower support
    [[a]_bearing_cap_x4_rev4.STL, [a]_bearing_cap_x4_rev5.STL, short_motor_tall_idler_mount_x2_rev2.STL, short_motor_tall_idler_mount_x2_rev3.STL, tall_motor_short_idler_mount_x2_rev2.STL, tall_motor_short_idler_mount_x2_rev3.STL, xy_rail_holder_x4_rev3.STL, xy_rail_holder_x4_rev4.STL]
2020-04-19 xy tower idlers use same bolt length for all 4 bolts, update edrawing
    xy tower idlers use same bolt length for all 4 bolts, update edrawing
    [[a]_bearing_cap_x4_rev5.STL, [a]_short_motor_tall_idler_bearing_cap_x2_rev1.STL, [a]_tall_motor_short_idler_bearing_cap_x2_rev1.STL, short_motor_tall_idler_mount_x2_rev3.STL, short_motor_tall_idler_mount_x2_rev4.STL, tall_motor_short_idler_mount_x2_rev3.STL, tall_motor_short_idler_mount_x2_rev4.STL]
2020-04-20 bmg only top plate release
    bmg only top plate release
    [bmg_mounting_bracket_mirrored_x1_rev3.STL, bmg_mounting_bracket_x1_rev2.STL, bmg_mounting_bracket_x1_rev3.STL, bmg_xy_carriage_top_plate_x1_rev1.STL, xy_carriage_top_plate_x1_rev5.STL]
2020-04-22 z ballscrew+rail block from heatset inserts to thru bolts and nylon lock nuts
    z ballscrew+rail block from heatset inserts to thru bolts and nylon lock nuts
    [z_bearing_block_b_mirror_x2_rev2.STL, z_bearing_block_b_mirror_x2_rev3.STL, z_bearing_block_b_x2_rev2.stl, z_bearing_block_b_x2_rev3.stl]
2020-04-22 tighten rail install tool tolerances
    [[a]_mgn9_rail_install_tool_x3_rev1.STL, [a]_mgn9_rail_install_tool_x3_rev2.STL]
2020-04-23 remove duet3 brackets
    [duet3_3hc_mounting_bracket_x1_rev2.STL, duet3_6hc_mainboard_mounting_bracket_x1_rev2.STL, duet3_toolhead_distribution_board_mounting_bracket_x1_rev2.STL]
2020-04-25 add experimental 16t drive/idler pulley support
    add experimental 16t drive/idler pulley support
    [xy_tensioner_left_16t_drive_x4_rev1.STL, xy_tensioner_left_20t_drive_x4_rev2.STL, xy_tensioner_right_16t_drive_x4_rev1.STL, xy_tensioner_right_20t_drive_x4_rev4.STL, xy_tensioner_right_x4_rev3.STL]
2020-04-27 M4 heatset inserts were too tight on install, short tower M3 screw clearance hole for motor to base was too small (3.3 vs 3.6)
    M4 heatset inserts were too tight on install, short tower M3 screw clearance hole for motor to base was too small (3.3 vs 3.6)
    [motor_idler_top_plate_x4_rev1.STL, short_motor_tall_idler_mount_x2_rev4.STL, short_motor_tall_idler_mount_x2_rev5.STL, tall_motor_short_idler_mount_x2_rev4.STL, tall_motor_short_idler_mount_x2_rev5.STL]
2020-05-03 lightweight xy carriage version 2
    lightweight xy carriage version 2
    [[a]_xy_carriage_fan_duct_1_x1_rev7.STL, [a]_xy_carriage_fan_duct_1_x1_rev8.STL, [a]_xy_carriage_fan_duct_2_x1_rev7.stl, [a]_xy_carriage_fan_duct_2_x1_rev8.stl, [a]_xy_carriage_fan_mount_1_x1_rev4.STL, [a]_xy_carriage_fan_mount_1_x1_rev5.STL, [a]_xy_carriage_fan_mount_2_x1_rev4.stl, [a]_xy_carriage_fan_mount_2_x1_rev5.stl]
2020-05-06 refactor majority of K1
    - relocate electronics to rear
    - most of frame members have changed
    - most of the panels have changed
    - gantry to 4040 members
    - bed support rails to 2040
    - z travel has been reduced by 20mm in the interest of greatly increasing gantry rigidity
    [[a]_electronics_box_corner_x4_rev2.STL, [a]_key_6mm_x50_Rev2.stl, bed_&_electronics_extrusion_keycap_x8_rev1.STL, bed_keycap_x4_rev1.STL, bowden_grommet_nut_25mm_x_rev1.STL, bowden_grommet_screw_left_25mm_x_rev1.STL, bowden_grommet_screw_right_25mm_x_rev1.STL, corner_lock_body_6mm_x6_Rev2.stl]
2020-05-08 remove obsolete DXFs
    [Back_Panel_200mm_Rev1.DXF, Back_Panel_250mm_Rev1.DXF, Back_Panel_300mm_Rev1.DXF, Back_Panel_350mm_Rev1.DXF, Back_Panel_400mm_Rev1.DXF, Back_Skirt_200mm_Rev2.DXF, Back_Skirt_250mm_Rev2.DXF, Back_Skirt_300mm_Rev2.DXF]
2020-05-08 actually release correct back panel dxfs
    actually release correct back panel dxfs
    [Back_Panel_200mm_Rev1.DXF, Back_Panel_250mm_Rev1.DXF, Back_Panel_300mm_Rev1.DXF, Back_Panel_350mm_Rev1.DXF, Back_Panel_400mm_Rev1.DXF]
2020-05-19 revised z endstop purge and scrub design, brush now height adjustable
    [z_endstop_and_purgescrub_bucket_key_x1_rev2.STL, z_endstop_and_purgescrub_bucket_x1_rev1.STL, z_endstop_brush_mount_x1_rev1.STL, z_endstop_housing_key_x1_rev1.STL, z_endstop_housing_x1_rev1.STL]
2020-05-31 update xy carriage top plate to restore full xy travel, stiffen part by 15%
    [bmg_xy_carriage_top_plate_x1_rev2.STL, bmg_xy_carriage_top_plate_x1_rev3.STL]
2020-06-09 add ascender top plate
    [ascender_xy_carriage_top_plate_x1_rev1.STL]
2020-06-18 re-add wiring retaining clips
    [[a]_wiring_retaining_clip_x10_rev1.STL]
2020-07-05 idler tower beefup, update edrawings
    fix extremely rare case where the xy idler top cap can split (aka 12k accel at 500mm/s for extended periods of time), by reducing stress points present and increasing radius sizes in weaker regions.
    [[a]_short_motor_tall_idler_bearing_cap_x2_rev1.STL, [a]_short_motor_tall_idler_bearing_cap_x2_rev2.STL, [a]_tall_motor_short_idler_bearing_cap_x2_rev1.STL, [a]_tall_motor_short_idler_bearing_cap_x2_rev2.STL, short_motor_tall_idler_mount_x2_rev5.STL, short_motor_tall_idler_mount_x2_rev6.STL, tall_motor_short_idler_mount_x2_rev5.STL, tall_motor_short_idler_mount_x2_rev6.STL]
2020-07-07 add reinforcing ribs to bmg top plate
    trying to stiffen tool mounting point in an effort to reduce low speed ringing
    [bmg_xy_carriage_top_plate_x1_rev3.STL, bmg_xy_carriage_top_plate_x1_rev4.STL]
2020-07-09 add sherpa - tall variant - top plate
    for testing
    [sherpa_tall_xy_carriage_top_plate_x1_rev1.STL]
2020-07-09 add optional laser cut panels for top/bottom/sides
    add optional laser cut panels for top/bottom/sides
    [Bottom_200mm_x_200mm_Rev1.DXF, Bottom_250mm_x_250mm_Rev1.DXF, Bottom_300mm_x_300mm_Rev1.DXF, Bottom_350mm_x_350mm_Rev1.DXF, Bottom_400mm_x_400mm_Rev1.DXF, Side_200mm_x_200mm_Rev1.DXF, Side_250mm_x_250mm_Rev1.DXF, Side_300mm_x_300mm_Rev1.DXF]
2020-07-09 add 400x400x600 build panels for socks
    [Back_Panel_400mm_x_400mm_x_600mm_Rev1.DXF, Side_400mm_x_400mm_x_400mm_Rev1.DXF, Side_400mm_x_400mm_x_600mm_Rev1.DXF]
2020-07-28 reduce material use on controller and rs-25-5 bracket
    reduce material use on controller and rs-25-5 bracket
    [bigtreetech_skr_mounting_bracket_x2_rev2.STL, bigtreetech_skr_mounting_bracket_x2_rev3.STL, fysetc_s6_mounting_bracket_x2_rev2.STL, fysetc_s6_mounting_bracket_x2_rev3.STL, meanwell_rs_25_5_psu_mounting_bracket_x1_rev1.STL, meanwell_rs_25_5_psu_mounting_bracket_x1_rev2.STL]
2020-07-28 add printed BF10 (bottom bearing) replacement block
    optional for now, requires 608 bearing
    [printed_BF10_block_alternative_x3_rev1.STL]
2020-07-28 fix stl orientation
    [printed_BF10_block_alternative_x3_rev1.STL]
2020-07-28 add high flow variant of ducting (for pla, etc)
    add high flow variant of ducting (for pla, etc)
    [[a]_xy_carriage_fan_duct_1_high_flow_x1_rev1.STL, [a]_xy_carriage_fan_duct_2_high_flow_x1_rev1.STL]
2020-07-29 revision 2 of high flow fan ducting
    revision 2 of high flow fan ducting
    [[a]_xy_carriage_fan_duct_1_high_flow_x1_rev1.STL, [a]_xy_carriage_fan_duct_1_high_flow_x1_rev2.STL, [a]_xy_carriage_fan_duct_2_high_flow_x1_rev1.STL, [a]_xy_carriage_fan_duct_2_high_flow_x1_rev2.STL]
2020-07-29 Revert "revision 2 of high flow fan ducting"
    This reverts commit b893da2016b3b49f1eb4f00e1e900f2c8fcdbfb8.
    [[a]_xy_carriage_fan_duct_1_high_flow_x1_rev1.STL, [a]_xy_carriage_fan_duct_1_high_flow_x1_rev2.STL, [a]_xy_carriage_fan_duct_2_high_flow_x1_rev1.STL, [a]_xy_carriage_fan_duct_2_high_flow_x1_rev2.STL]
2020-07-29 update quantity
    [printed_BF10_block_alternative_x4_rev1.STL]
2020-07-29 clean up fillets on chain anchors
    [z_chain_anchor_bottom_x2_rev1.STL, z_chain_anchor_bottom_x2_rev2.STL, z_chain_anchor_top_x2_rev1.STL, z_chain_anchor_top_x2_rev2.STL]
2020-07-29 repair stl
    [[a]_xy_carriage_fan_duct_2_high_flow_x1_rev1.STL]
2020-07-29 re-org xy carriage folder
    [ascender_xy_carriage_top_plate_x1_rev1.STL, bmg_mounting_bracket_mirrored_x1_rev3.STL, bmg_mounting_bracket_x1_rev3.STL, bmg_xy_carriage_top_plate_x1_rev4.STL, sherpa_tall_xy_carriage_top_plate_x1_rev1.STL, xy_carriage_mosquito_tool_mount_x1_rev3.STL, xy_carriage_tl_dragon_tool_mount_x1_rev3.STL, xy_carriage_v6_tool_mount_1_x1_rev3.STL]
2020-07-31 add oldham coupler style joint to z axis
    reduces chances of bent screws (especially if your on a budget) of affecting print quality
    [z_bearing_block_a_mirror_oldham_x2_rev1.STL, z_bearing_block_a_oldham_x2_rev1.STL, z_bearing_block_a_x4_rev2.STL, z_bearing_block_b_mirror_x2_rev3.STL, z_bearing_block_b_oldham_x4_rev1.STL, z_bearing_block_b_x2_rev3.stl, z_bearing_block_c_oldham_x4_rev1.STL]
2020-08-02 printed BF10 block now standard
    [BF10_block_x4_rev1.STL]
2020-08-04 high flow fan duct now standard
    high flow fan duct now standard
    [[a]_xy_carriage_fan_duct_1_high_flow_x1_rev1.STL, [a]_xy_carriage_fan_duct_1_high_flow_x1_rev2.STL, [a]_xy_carriage_fan_duct_1_x1_rev8.STL, [a]_xy_carriage_fan_duct_2_high_flow_x1_rev1.STL, [a]_xy_carriage_fan_duct_2_high_flow_x1_rev2.STL, [a]_xy_carriage_fan_duct_2_x1_rev8.stl]
2020-08-04 reduce material usage on probe dock
    reduce material usage on probe dock
    [magnetic_probe_dock_x1_rev3.STL, magnetic_probe_dock_x1_rev4.STL]
2020-08-06 oldham pockets werent set on layer multiples, move idler tower on xy 1mm forward for more motor clearance
    oldham pockets werent set on layer multiples, move idler tower on xy 1mm forward for more motor clearance
    [short_motor_tall_idler_mount_x2_rev6.STL, short_motor_tall_idler_mount_x2_rev7.STL, tall_motor_short_idler_mount_x2_rev6.STL, tall_motor_short_idler_mount_x2_rev7.STL, z_bearing_block_a_mirror_oldham_x2_rev1.STL, z_bearing_block_a_mirror_oldham_x2_rev2.STL, z_bearing_block_a_oldham_x2_rev1.STL, z_bearing_block_a_oldham_x2_rev2.STL]
2020-08-06 minor oldham slot geometry adjustment for better printability
    [z_bearing_block_a_mirror_oldham_x2_rev2.STL, z_bearing_block_a_mirror_oldham_x2_rev3.STL, z_bearing_block_a_oldham_x2_rev2.STL, z_bearing_block_a_oldham_x2_rev3.STL, z_bearing_block_b_oldham_x4_rev2.STL, z_bearing_block_b_oldham_x4_rev3.STL, z_bearing_block_c_oldham_x4_rev2.STL, z_bearing_block_c_oldham_x4_rev3.STL]
2020-08-06 prevent flat sections from appearing in oldham pockets
    prevent flat sections from appearing in oldham pockets
    [z_bearing_block_a_mirror_oldham_x2_rev3.STL, z_bearing_block_a_mirror_oldham_x2_rev4.STL, z_bearing_block_a_oldham_x2_rev3.STL, z_bearing_block_a_oldham_x2_rev4.STL, z_bearing_block_b_oldham_x4_rev3.STL, z_bearing_block_b_oldham_x4_rev4.STL, z_bearing_block_c_oldham_x4_rev3.STL, z_bearing_block_c_oldham_x4_rev4.STL]
2020-08-06 add coffee's wiring schematic for AC and DC wiring on the machine
    thanks coffee for all the work
2020-08-13 add Meanwell LRS-200 and LRS-350 (and RSP) mounting bracket for converts from other machines
    add Meanwell LRS-200 and LRS-350 (and RSP) mounting bracket for converts from other machines
    [meanwell_lrs_200&350_24_psu_mounting_bracket_x2_rev1.STL]
2020-08-13 add sensorless homing, input shaper and bmg direct drive support to config
    [K1_bigtree_skr_1.3_config-250mm_x_250mm_x_250mm_build.cfg]
2020-08-14 reduce material usage in probe dock
    [magnetic_probe_dock_x1_rev4.STL, magnetic_probe_dock_x1_rev5.STL]
2020-08-15 add 4.5mm "pin" variant for non-standard spec ballscrews
    [z_bearing_block_c_oldham_4.5mm_pins_x4_rev4.STL, z_bearing_block_c_oldham_4.8mm_pins_x4_rev4.STL]
2020-08-15 add folded ascender top plate
    [ascender_xy_carriage_top_plate_x1_rev1.STL]
2020-08-16 hollow out electronics box corner, reduce material and print time
    hollow out electronics box corner, reduce material and print time
    [[a]_electronics_box_corner_x4_rev2.STL, [a]_electronics_box_corner_x4_rev3.STL]
2020-08-20 xy idler endcaps allow bolt engagement into tnuts now
    xy idler endcaps allow bolt engagement into tnuts now
    [[a]_short_motor_tall_idler_bearing_cap_x2_rev2.STL, [a]_short_motor_tall_idler_bearing_cap_x2_rev3.STL, [a]_tall_motor_short_idler_bearing_cap_x2_rev2.STL, [a]_tall_motor_short_idler_bearing_cap_x2_rev3.STL]
2020-08-26 chain anchors had holes for m3 inserts, should be m4, simplify and add lightness
    chain anchors had holes for m3 inserts, should be m4, simplify and add lightness
    [z_chain_anchor_bottom_x2_rev2.STL, z_chain_anchor_bottom_x2_rev3.STL, z_chain_anchor_top_x2_rev2.STL, z_chain_anchor_top_x2_rev3.STL]
2020-08-26 update sherpa mini top plate to match release
    update sherpa mini top plate to match release
2020-08-27 add fysetc s6 + btt motor expander bracket, update skr bracket to match
    add fysetc s6 + btt motor expander bracket, update skr bracket to match
    [bigtreetech_skr_mounting_bracket_with_motor_expander_x1_rev1.STL, bigtreetech_skr_mounting_bracket_with_motor_expander_x1_rev2.STL, fysetc_s6_mounting_bracket_with_motor_expander_x1_rev1.STL]
2020-08-27 add extra hole in center top of back panel to reduce chance rattle
    add extra hole in center top of back panel to reduce chance rattle
    [Back_Panel_200mm_Rev2.DXF, Back_Panel_250mm_Rev2.DXF, Back_Panel_300mm_Rev2.DXF, Back_Panel_350mm_Rev2.DXF, Back_Panel_400mm_Rev2.DXF, Back_Panel_400mm_x_400mm_x_600mm_Rev2.DXF]
2020-08-28 update klipper config to match 08-16-2020 changes
    [K1_bigtree_skr_1.3_config-250mm_x_250mm_x_250mm_build.cfg]
2020-08-29 gantry was facing the wrong way
    i'm dumb
2020-08-29 add experimental +15mm z travel oldham block a parts
    thanks rentalablesocks for finding my blind error
2020-08-30 tighten self taping region in new experimental z block_a's
    tighten self taping region in new experimental z block_a's
2020-09-01 expansion board spacing was 36mm, should have been 38mm
    [bigtreetech_skr_mounting_bracket_with_motor_expander_x1_rev2.STL, bigtreetech_skr_mounting_bracket_with_motor_expander_x1_rev3.STL, fysetc_s6_mounting_bracket_with_motor_expander_x1_rev1.STL, fysetc_s6_mounting_bracket_with_motor_expander_x1_rev2.STL]
2020-09-03 fix print orientation on part
2020-09-07 replace normal ascender top plate with folded ascender top plate
2020-09-14 add solid no oldham mounts (per socks request) for troubleshooting
2020-09-15 Update README.md
    Release Schedule:
    - Release 1 - RC2: Final True Release
    - Release 1: Bug Fixes from Final Testing of RC2
    - Release 1.1: Belted Z Drive Option
    - Release 1.2: New Front Door Design
    - Release 2.0: New Gantry
2020-09-16 rc2 prep
    [xy_tensioner_left_16t_drive_x4_rev1.STL, xy_tensioner_left_20t_drive_x4_rev2.STL, xy_tensioner_left_20t_drive_x4_rev3.STL, xy_tensioner_right_16t_drive_x4_rev1.STL, xy_tensioner_right_20t_drive_x4_rev4.STL, xy_tensioner_right_20t_drive_x4_rev5.STL, z_bearing_block_a_mirror_oldham_x2_rev4.STL, z_bearing_block_a_oldham_x2_rev4.STL]
2020-09-25 add rentablesocks k1 example config for s6 v2.0
    [K1_S6_Sample_config.g]
2020-10-04 add cad for fysetc s6 mounting frame, upon request
    [FYSETC_S6_Mounting_Frame.x_t]
2020-10-04 fix print orientation for parts
    [xy_tensioner_left_20t_drive_x4_rev3.STL, xy_tensioner_right_20t_drive_x4_rev5.STL]
2020-10-05 add experimental bass fan ducts (super flow)
    i have no idea where this name came from
    [BASS_Fan_Ducts.x_t, [a]_xy_carriage_fan_duct_1_bass_x1_rev1.STL, [a]_xy_carriage_fan_duct_2_bass_x1_rev1.STL]
2020-10-21 1.1 beta 1 z drive parts and edrawing, clean up repo
    [BASS_Fan_Ducts.x_t, BF10_block_x4_rev1.STL, Back_Panel_200mm_Rev2.DXF, Back_Panel_250mm_Rev2.DXF, Back_Panel_250mm_x_250mm_x_300mm_Rev1.DXF, Back_Panel_300mm_Rev2.DXF, Back_Panel_350mm_Rev2.DXF, Back_Panel_400mm_Rev2.DXF]
2020-10-21 add mgn12 and mgn15 rail install tools
    [[a]_mgn12_rail_install_tool_2040_x3_rev2.STL, [a]_mgn15_rail_install_tool_2040_x3_rev2.STL, [a]_mgn9_rail_install_tool_2040_x3_rev2.STL]
2020-10-22 add DXFs, PDFs and wiring schematic to release 1.1
    [Back_Panel_200mm_Rev2.DXF, Back_Panel_250mm_Rev2.DXF, Back_Panel_250mm_x_250mm_x_300mm_Rev1.DXF, Back_Panel_300mm_Rev2.DXF, Back_Panel_350mm_Rev2.DXF, Back_Panel_400mm_Rev2.DXF, Back_Panel_400mm_x_400mm_x_600mm_Rev2.DXF, Bottom_200mm_x_200mm_Rev1.DXF]
2020-10-23 coupler needed additional clearance on drive tower
2020-10-24 add diy frame blind joint drilling tools
    [[a]_2020_end_position_blind_joint_hole_drill_guide_x1_rev1.STL, [a]_2020_free_position_blind_joint_hole_drill_guide_x1_rev1.STL, [a]_2040_end_position_blind_joint_hole_drill_guide_x1_rev1.STL, [a]_2040_free_position_blind_joint_hole_drill_guide_x1_rev1.STL]
2020-10-29 add m3 inserts variant of electronics box corners
    [[a]_electronics_box_corner_m3_inserts_x4_rev1.STL, [a]_electronics_box_corner_m5_inserts_x4_rev3.STL, [a]_electronics_box_m5_to_m3_screw_adapter_x24_rev1.STL]
2020-10-31 add piton probe support
    [[a]_piton_probe_plate_x1_rev1.STL, piton_magnetic_probe_dock_x1_rev1.STL, xy_carriage_piton_probe_holder_x1_rev1.STL]
2020-11-04 neopixel changes
    [K1_bigtree_skr_1.3_config-250mm_x_250mm_x_250mm_build.cfg]
2020-11-09 add release 1.2 doors to repo
    [BF10_block_x4_rev1.STL, Back_Panel_200mm_Rev2.DXF, Back_Panel_250mm_Rev2.DXF, Back_Panel_250mm_x_250mm_x_300mm_Rev1.DXF, Back_Panel_300mm_Rev2.DXF, Back_Panel_350mm_Rev2.DXF, Back_Panel_400mm_Rev2.DXF, Back_Panel_400mm_x_400mm_x_600mm_Rev2.DXF]
2020-11-13 update piton holder, add cad for toolhead
    [xy_carriage_piton_probe_holder_x1_rev1.STL, xy_carriage_piton_probe_holder_x1_rev2.STL]
2020-11-16 alter belt tensioner cutouts to match in-hand belt
    [[a]_belted_z_tensioner_a1_x4_rev1.STL, [a]_belted_z_tensioner_a1_x4_rev2.STL, [a]_belted_z_tensioner_a2_x4_rev1.STL, [a]_belted_z_tensioner_a2_x4_rev2.STL, [a]_belted_z_tensioner_b1_x4_rev1.STL, [a]_belted_z_tensioner_b1_x4_rev2.STL, [a]_belted_z_tensioner_b2_x4_rev1.STL, [a]_belted_z_tensioner_b2_x4_rev2.STL]
2020-11-16 move to double shear pin setup to support the belt
    [[a]_belted_z_tensioner_a1_x4_rev2.STL, [a]_belted_z_tensioner_a1_x4_rev3.STL, [a]_belted_z_tensioner_a2_x4_rev2.STL, [a]_belted_z_tensioner_a2_x4_rev3.STL, [a]_belted_z_tensioner_b1_x4_rev2.STL, [a]_belted_z_tensioner_b1_x4_rev3.STL, [a]_belted_z_tensioner_b2_x4_rev2.STL, [a]_belted_z_tensioner_b2_x4_rev3.STL]
2020-11-16 update belted z edrawing
    update belted z edrawing
2020-11-16 more tooth on tooth action
    [[a]_belted_z_tensioner_a1_x4_rev3.STL, [a]_belted_z_tensioner_a1_x4_rev4.STL, [a]_belted_z_tensioner_a2_x4_rev3.STL, [a]_belted_z_tensioner_a2_x4_rev4.STL, [a]_belted_z_tensioner_b1_x4_rev3.STL, [a]_belted_z_tensioner_b1_x4_rev4.STL, [a]_belted_z_tensioner_b2_x4_rev3.STL, [a]_belted_z_tensioner_b2_x4_rev4.STL]
2020-11-17 add piton dragon mount
    [xy_carriage_piton_probe_holder_dragon_x1_rev1.STL, xy_carriage_piton_probe_holder_mosquito_x1_rev2.STL, xy_carriage_piton_probe_holder_x1_rev2.STL]
2020-11-17 add alt z rail install tools, so rails can be installed with back panels on
    [[a]_mgn12_altz_rail_alignment_tool_x3_rev1.STL, [a]_mgn15_altz_rail_alignment_tool_x3_rev1.STL, [a]_mgn9_altz_rail_alignment_tool_x3_rev1.STL]
2020-11-17 add triple hinge variant for doors (completely optional)
    [Front_Door_200mm_x2_Rev1.DXF, Front_Door_250mm_x2_Rev1.DXF, Front_Door_300mm_x2_Rev1.DXF, Front_Door_350mm_x2_Rev1.DXF, Front_Door_400mm_x2_Rev1.DXF]
2020-11-18 add slicer profiles and belted z skr1.3 config to 1.2 beta
    [K1_bigtree_skr_1.3_config-250mm_x_250mm_x_250mm_build.cfg]
2020-11-18 replace 10x3 CS piton with 6x3 flat magnet piton
    [Piton_Probe_Assembly_11-18-2020.x_t, [a]_piton_probe_cap_6x3_x1_rev2.STL, [a]_piton_probe_plate_6x3_x1_rev2.STL, [a]_piton_probe_plate_x1_rev1.STL, [a]_xy_carriage_magnetic_probe_microswitch_mount_x1_rev1.STL, magnetic_probe_dock_x1_rev5.STL, piton_magnetic_probe_dock_6x3_x1_rev3.STL, piton_magnetic_probe_dock_x1_rev1.STL]
2020-11-18 add skr1.4 config, fix minor typos on 1.3 config, remove old 1.3 code
    [K1_bigtree_skr_1.4_config-250mm_x_250mm_x_250mm_build.cfg]
2020-11-19 add decorative gantry extrusion endcap
    [[a]_4040_extrusion_endcap_x2_rev1.STL]
2020-11-19 upload correct endcap
    [[a]_4040_extrusion_endcap_x2_rev1.STL, [a]_4040_extrusion_endcap_x2_rev2.STL]
2020-11-19 add s6 1.2 config, update comments and such in 1.3 and 1.4 configs, add blocks for belted z
    add s6 1.2 config, update comments and such in 1.3 and 1.4 configs, add blocks for belted z
    [K1_bigtree_skr_1.3_config-250mm_x_250mm_x_250mm_build.cfg, K1_fysetc_s6_1.2_config-250mm_x_250mm_x_250mm_build.cfg]
2020-11-21 add release 2 alpha
    [[a]_1515_mgn12_xy_cross_shortening_jig_x1_rev1.STL, [a]_1515_mgn12c_drilling_jig_x1_rev2.STL, [a]_1515_mgn12c_rail_alignment_tool_x2_rev1.STL, [a]_1515_mgn9h_drilling_jig_x1_rev1.STL, [a]_carabiner_mounting_bracket_x1_rev1.STL, [a]_mosquito_dd_bowden_cutting_tool_x1_rev1.STL, [a]_piton_probe_cap_6x3_x1_rev2.STL, [a]_piton_probe_plate_6x3_x1_rev3.STL]
2020-11-22 add cable tie lances to xy main frame on alpha R2 carriage
2020-11-24 holes were 5.3mm, now 4.7mm
    [xy_mgn12c_tensioner_right_20t_drive_12mm_belts_x4_rev1.STL, xy_mgn12c_tensioner_right_20t_drive_12mm_belts_x4_rev2.STL, xy_mgn9h_tensioner_right_20t_drive_12mm_belts_x4_rev1.STL, xy_mgn9h_tensioner_right_20t_drive_12mm_belts_x4_rev2.STL]
2020-11-24 revise belted z motor towers to match actual production motors
2020-11-24 update R1.2 edrawing to match new motor mount
    [BF10_block_x4_rev1.STL, Back_Panel_200mm_Rev2.DXF, Back_Panel_250mm_Rev2.DXF, Back_Panel_250mm_x_250mm_x_300mm_Rev1.DXF, Back_Panel_300mm_Rev2.DXF, Back_Panel_350mm_Rev2.DXF, Back_Panel_400mm_Rev2.DXF, Back_Panel_400mm_x_400mm_x_600mm_Rev2.DXF]
2020-11-24 add theoretical wiring cover to toolhead
    [xy_carriage_wiring_cover_x1_rev1.STL]
2020-11-25 fix motor key flange interference in motor mounts
2020-11-26 fix print orientation
2020-11-26 remove bridge on bottom plate, core out sections on main frame where extra materal is not required
2020-11-27 make part cooling transfer duct portion of parts a bit more printable
2020-11-27 couldnt pass SHCS thru access holes, fixed that
2020-12-04 add support for 24mm ballscrew nuts
    [z_bearing_block_solid_22mm_nut_x2_rev1.STL, z_bearing_block_solid_24mm_nut_x2_rev1.STL, z_bearing_block_solid_mirror_22mm_nut_x2_rev1.STL, z_bearing_block_solid_mirror_24mm_nut_x2_rev1.STL]
2020-12-04 add mgn12c linear rail support to ballscrew z drive
    [z_bearing_block_solid_mgn12c_22mm_nut_x2_rev1.STL, z_bearing_block_solid_mgn12c_24mm_nut_x2_rev1.STL, z_bearing_block_solid_mgn12c_mirror_22mm_nut_x2_rev1.STL, z_bearing_block_solid_mgn12c_mirror_24mm_nut_x2_rev1.STL, z_bearing_block_solid_mgn9h_22mm_nut_x2_rev1.STL, z_bearing_block_solid_mgn9h_24mm_nut_x2_rev1.STL, z_bearing_block_solid_mgn9h_mirror_22mm_nut_x2_rev1.STL, z_bearing_block_solid_mg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]
2020-12-06 wrong uart/tx on s6 config, was E1, now E0
    [K1_fysetc_s6_1.2_config-250mm_x_250mm_x_250mm_build.cfg]
2020-12-09 1.2 release
    [BASS_Fan_Ducts.x_t, BF10_block_x4_rev1.STL, Back_Panel_200mm_Rev2.DXF, Back_Panel_250mm_Rev2.DXF, Back_Panel_250mm_x_250mm_x_300mm_Rev1.DXF, Back_Panel_300mm_Rev2.DXF, Back_Panel_350mm_Rev2.DXF, Back_Panel_400mm_Rev2.DXF]
2020-12-09 re-add release 2 beta
    [[a]_1515_mgn12_xy_cross_shortening_jig_x1_rev1.STL, [a]_1515_mgn12c_drilling_jig_x1_rev2.STL, [a]_1515_mgn12c_rail_alignment_tool_x2_rev1.STL, [a]_1515_mgn9h_drilling_jig_x1_rev1.STL, [a]_carabiner_mounting_bracket_x1_rev1.STL, [a]_mosquito_dd_bowden_cutting_tool_x1_rev1.STL, [a]_piton_probe_cap_6x3_x1_rev2.STL, [a]_piton_probe_plate_6x3_x1_rev3.STL]
2020-12-09 add missing stls, dxfs and pdfs to release 2 folder
    [BF10_block_x4_rev1.STL, Back_Panel_200mm_Rev2.DXF, Back_Panel_250mm_Rev2.DXF, Back_Panel_250mm_x_250mm_x_300mm_Rev1.DXF, Back_Panel_300mm_Rev2.DXF, Back_Panel_350mm_Rev2.DXF, Back_Panel_400mm_Rev2.DXF, Back_Panel_400mm_x_400mm_x_600mm_Rev2.DXF]
2020-12-11 add beta 2 piece ballscrew z mount to resist ejecting radial bearings
    to not use snap rings, were trying this, if this fails, snap rings it is
2020-12-11 reorient part, was not in printing orientation
2020-12-21 move 2 part ballscrew z parts to "production", add mgn12c variant
    [z_bearing_block_solid_mgn12c_22mm_nut_x2_rev1.STL, z_bearing_block_solid_mgn12c_24mm_nut_x2_rev1.STL, z_bearing_block_solid_mgn12c_mirror_22mm_nut_x2_rev1.STL, z_bearing_block_solid_mgn12c_mirror_24mm_nut_x2_rev1.STL, z_bearing_block_solid_mgn9h_22mm_nut_x2_rev1.STL, z_bearing_block_solid_mgn9h_24mm_nut_x2_rev1.STL, z_bearing_block_solid_mgn9h_mirror_22mm_nut_x2_rev1.STL, z_bearing_block_solid_mg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]
2020-12-21 R2-Beta2 prep
    - remove nozzle switch/purge bucket combo
    - add pape purge bucket
    - add pape d2f probe
    [[a]_piton_probe_cap_6x3_x1_rev2.STL, [a]_piton_probe_plate_6x3_x1_rev3.STL, brush_+_bucket_holder_x1_rev1.STL, microswitch_probe_dock_support_arm_1_x2_rev1.STL, microswitch_probe_dock_support_arm_2_x1_rev1.STL, microswitch_probe_dock_support_arm_3_x1_rev1.STL, omron_d2f-5_microswitch_probe_body_x1_rev1.STL, piton_magnetic_probe_dock_6x3_x1_rev3.STL]
2020-12-26 add x_t for microswitch probe and dock
    [Microswitch_Dock.x_t, Omron_Mag_Probe_Assembly.x_t]
2020-12-26 add cad for purge and brush bucket
    [Brush+Purge_Bin_Assembly.x_t]
2020-12-31 5020 fan toolhead - r1
    [[a]_xy_carriage_fan_duct_1_x1_rev3.STL, [a]_xy_carriage_fan_duct_2_x1_rev3.STL]
2020-12-31 uploaded wrong toolhead
2020-12-31 add nirecue requested panels to github
    [Front_Door_250mm_x_250mm_x_250mm_x2_Rev1.DXF, Front_Door_250mm_x_250mm_x_300mm_x2_Rev1.DXF, Side_250mm_x_250mm_x_250mm_Rev1.DXF, Side_250mm_x_250mm_x_300mm_Rev1.DXF]
2021-01-01 5020 fan pocket clearance
2021-01-01 print orientation was incorrect
    [omron_d2f-5_microswitch_probe_body_x1_rev1.STL]
2021-01-02 minor printability improvements, alter fillet sizes around rear of part
2021-01-07 i'm great at math
    doors were on a mulitple of 50 instead of 25, fixed that
    [Front_Door_200mm_x2_Rev2.DXF, Front_Door_250mm_x2_Rev2.DXF, Front_Door_250mm_x_250mm_x_250mm_x2_Rev2.DXF, Front_Door_250mm_x_250mm_x_300mm_x2_Rev2.DXF, Front_Door_300mm_x2_Rev2.DXF, Front_Door_350mm_x2_Rev2.DXF, Front_Door_400mm_x2_Rev2.DXF]
2021-01-07 add 450 and 500mm doors
    [Front_Door_450mm_x2_Rev1.DXF, Front_Door_500mm_x2_Rev1.DXF]
2021-01-08 update release 1.2 configs to use rotation_distance instead of step_distance
    [K1_bigtree_skr_1.3_config-250mm_x_250mm_x_250mm_build.cfg, K1_bigtree_skr_1.4_config-250mm_x_250mm_x_250mm_build.cfg, K1_fysetc_s6_1.2_config-250mm_x_250mm_x_250mm_build.cfg]
2021-01-08 typo in bmg rotation_distance
    [K1_bigtree_skr_1.3_config-250mm_x_250mm_x_250mm_build.cfg, K1_bigtree_skr_1.4_config-250mm_x_250mm_x_250mm_build.cfg, K1_fysetc_s6_1.2_config-250mm_x_250mm_x_250mm_build.cfg]
2021-01-08 add microstepping and full steps per rotation sections to config, they were missed by mistake
    [K1_bigtree_skr_1.3_config-250mm_x_250mm_x_250mm_build.cfg, K1_bigtree_skr_1.4_config-250mm_x_250mm_x_250mm_build.cfg, K1_fysetc_s6_1.2_config-250mm_x_250mm_x_250mm_build.cfg]
2021-01-08 add s6 2.0 config, fix pin issue on 1.2 config
    [K1_fysetc_s6_2.0_config-250mm_x_250mm_x_250mm_build.cfg]
2021-01-08 add configs for r2 with legacy nozzle probe
    [K1_bigtree_skr_1.3_config-250mm_x_250mm_x_250mm_build.cfg, K1_bigtree_skr_1.4_config-250mm_x_250mm_x_250mm_build.cfg, K1_fysetc_s6_1.2_config-250mm_x_250mm_x_250mm_build.cfg, K1_fysetc_s6_2.0_config-250mm_x_250mm_x_250mm_build.cfg]
2021-01-08 first pass, dockable r2 z probe config
    [K1_bigtree_skr_1.3_config-250mm_x_250mm_x_250mm_build.cfg, K1_bigtree_skr_1.4_config-250mm_x_250mm_x_250mm_build.cfg, K1_fysetc_s6_1.2_config-250mm_x_250mm_x_250mm_build.cfg, K1_fysetc_s6_2.0_config-250mm_x_250mm_x_250mm_build.cfg]
2021-01-08 stated inductive, should be microswitch
    [K1_bigtree_skr_1.3_config-250mm_x_250mm_x_250mm_build.cfg, K1_bigtree_skr_1.4_config-250mm_x_250mm_x_250mm_build.cfg, K1_fysetc_s6_1.2_config-250mm_x_250mm_x_250mm_build.cfg, K1_fysetc_s6_2.0_config-250mm_x_250mm_x_250mm_build.cfg]
2021-01-08 samples to 3, z offset to safer number
    [K1_bigtree_skr_1.3_config-250mm_x_250mm_x_250mm_build.cfg, K1_bigtree_skr_1.4_config-250mm_x_250mm_x_250mm_build.cfg, K1_fysetc_s6_1.2_config-250mm_x_250mm_x_250mm_build.cfg, K1_fysetc_s6_2.0_config-250mm_x_250mm_x_250mm_build.cfg]
2021-01-08 add 450^3 and 500^3 panels
    [Back_Panel_450mm_Rev1.DXF, Back_Panel_500mm_Rev1.DXF, Bottom_450mm_x_450mm_Rev1.DXF, Bottom_500mm_x_500mm_Rev1.DXF, Side_450mm_x_450mm_Rev1.DXF, Side_500mm_x_500mm_Rev1.DXF, Top_450mm_x_450mm_Rev1.DXF, Top_500mm_x_500mm_Rev1.DXF]
2021-01-08 450mm and 500mm bed and heater drawings
2021-01-10 remove microsteps setting from tmc2209 blocks
    [K1_bigtree_skr_1.3_config-250mm_x_250mm_x_250mm_build.cfg, K1_bigtree_skr_1.4_config-250mm_x_250mm_x_250mm_build.cfg, K1_fysetc_s6_1.2_config-250mm_x_250mm_x_250mm_build.cfg, K1_fysetc_s6_2.0_config-250mm_x_250mm_x_250mm_build.cfg]
2021-01-10 make opi bracket taller, to clear 2020 parts
    [orangepi_lite_mounting_bracket_x1_rev1.STL]
2021-01-11 update edrawing, fix doors (off by 25mm width prior)
    [Front_Door_200mm_x2_Rev2.DXF, Front_Door_200mm_x2_Rev3.DXF, Front_Door_250mm_x2_Rev2.DXF, Front_Door_250mm_x2_Rev3.DXF, Front_Door_250mm_x_250mm_x_250mm_x2_Rev2.DXF, Front_Door_250mm_x_250mm_x_250mm_x2_Rev3.DXF, Front_Door_250mm_x_250mm_x_300mm_x2_Rev2.DXF, Front_Door_250mm_x_250mm_x_300mm_x2_Rev3.DXF]
2021-01-15 retrofit r2 probe mount (your on your own)
2021-01-19 add magnet removal holes to bottom of xy carriage
2021-01-19 add draft to probe dock and probe housing to aid in entry when dock is slightly misaligned
    [omron_d2f-5_microswitch_probe_body_x1_rev1.STL, omron_d2f-5_microswitch_probe_body_x1_rev2.STL]
2021-01-21 add bracing bolts to microswitch dock (optional)
    [microswitch_probe_dock_x1_rev5.STL]
2021-01-22 dragon tool mount was 1mm too long, add 1st stage of new fan duct setup
    [[a]_xy_carriage_dragon_tool_mount_x1_rev4.STL, [a]_xy_carriage_dragon_tool_mount_x1_rev5.STL, xy_carriage_bottom_frame_magswitch_probe_v2_x1_rev3.STL]
2021-01-23 rear power inlet design improvements
    [electronics_box_blanking_plate_x2_rev1.STL, electronics_box_side_panel_TE_power_inlet_x1_rev2.DXF, electronics_box_side_panel_power_inet_x1_rev1.DXF, electronics_box_te_power_inlet_x1_rev1.STL]
2021-01-23 first pass fan ducts for new bracing/probe setup
    [[a]_xy_carriage_fan_duct_1_x1_rev2.STL, [a]_xy_carriage_fan_duct_2_x1_rev2.STL]
2021-01-26 update cad files for probe
    [Microswitch_Dock.x_t, Omron_Mag_Probe_Assembly.x_t]
2021-01-26 add chungus fan ducting
    [[a]_xy_carriage_chungus_fan_duct_1_x1_rev1.STL, [a]_xy_carriage_chungus_fan_duct_2_x1_rev1.STL, [a]_xy_carriage_fan_duct_1_x1_rev2.STL, [a]_xy_carriage_fan_duct_2_x1_rev2.STL]
2021-01-27 add belted z omc motor plates
    [belted_z_motor_tower_OMC_a_x2_rev1.STL, belted_z_motor_tower_OMC_b_x2_rev1.stl]
2021-01-28 move release 1.2 to archive, update r2 configs to use updated macros
    [BASS_Fan_Ducts.x_t, BF10_block_x4_rev1.STL, Back_Panel_200mm_Rev2.DXF, Back_Panel_250mm_Rev2.DXF, Back_Panel_250mm_x_250mm_x_300mm_Rev1.DXF, Back_Panel_300mm_Rev2.DXF, Back_Panel_350mm_Rev2.DXF, Back_Panel_400mm_Rev2.DXF]
2021-01-31 convert R2 configs to use gear ratio
    [K1_bigtree_skr_1.3_config-250mm_x_250mm_x_250mm_build.cfg, K1_bigtree_skr_1.4_config-250mm_x_250mm_x_250mm_build.cfg, K1_fysetc_s6_1.2_config-250mm_x_250mm_x_250mm_build.cfg, K1_fysetc_s6_2.0_config-250mm_x_250mm_x_250mm_build.cfg]
2021-02-03 print orientation
    [microswitch_probe_dock_x1_rev5.STL]
2021-02-06 ever so slight mounting hole shift for expander board
    [fysetc_s6_mounting_bracket_with_motor_expander_x1_rev2.STL, fysetc_s6_mounting_bracket_with_motor_expander_x1_rev3.STL]
2021-02-14 add raz toolhead renders
2021-02-20 add temp cad screenshots to github page
2021-03-03 belt retaining screw was 5.3mm insert hole, corrected to 4.7mm
    [xy_mgn12c_tensioner_left_20t_drive_12mm_belts_x4_rev1.STL, xy_mgn12c_tensioner_left_20t_drive_12mm_belts_x4_rev2.STL, xy_mgn12c_tensioner_right_20t_drive_12mm_belts_x4_rev2.STL, xy_mgn12c_tensioner_right_20t_drive_12mm_belts_x4_rev3.STL]
2021-03-11 add optional fysetc display housing edrawing and stls
    [rear_mount_fysetc_12864_housing_anchor_plate_x1_rev1.STL, rear_mount_fysetc_12864_housing_top_x1_rev1.STL]
2021-03-12 slotted omc motor mounting screws for belted z to support both variants
    [belted_z_motor_tower_OMC_a_x2_rev1.STL, belted_z_motor_tower_OMC_b_x2_rev1.stl]
2021-03-12 add toolhead cad for sherpa mini toolhead variant
2021-03-13 ldo and omc motors now on one bracket, legacy omc moved to legacy folder
2021-03-17 further material reduction from electronics box corner in an effort to reduce print time
    [[a]_electronics_box_corner_m3_inserts_x4_rev1.STL, [a]_electronics_box_corner_m5_inserts_x4_rev3.STL, [a]_electronics_box_corner_x4_rev4.STL, [a]_electronics_box_m5_to_m3_screw_adapter_x24_rev1.STL]
2021-04-02 add actual sherpa mini to toolhead cad file
2021-04-05 add integrated 25mm fan mount
    [[a]_xy_carriage_dragon_tool_mount_x1_rev5.STL]
2021-04-16 klipper configs for 60:1 worm z
    [K1_bigtree_skr_1.3_config-250mm_x_250mm_x_250mm_build.cfg, K1_bigtree_skr_1.4_config-250mm_x_250mm_x_250mm_build.cfg, K1_fysetc_s6_1.2_config-250mm_x_250mm_x_250mm_build.cfg, K1_fysetc_s6_2.0_config-250mm_x_250mm_x_250mm_build.cfg]
2021-04-19 add worm drive to assembly, add lightened planetary motor bases, screw changes
2021-04-19 clean up spool holder stuff
    [[a]_filament_sensor_holder_x2_rev1.STL, filament_sensor_mounting_bracket_panel_clips_x1_rev1.stl, filament_sensor_mounting_bracket_screw_down_x1_rev1.STL, spool_holder_6mm_panels_x1_Rev1.stl]
2021-04-19 add screw down spool holder for metal panels
    [spool_holder_screw_down_x1_Rev1.STL]
2021-04-27 slot motor mounting points
2021-05-05 revised toolhead for more stability at 12k+ accels, more umbilical stability
    [[a]_carabiner_mounting_bracket_x1_rev1.STL, xy_carriage_bottom_frame_magswitch_probe_v2_x1_rev3.STL]
2021-05-12 rename files in prep for mag+ support
    [[a]_xy_carriage_std_fan_duct_1_x1_rev1.STL, [a]_xy_carriage_std_fan_duct_2_x1_rev1.STL]
2021-05-18 respin electronics brackets to use heatsets instead of self taping screws
    [bigtreetech_skr_mounting_bracket_x2_rev3.STL, bigtreetech_skr_mounting_bracket_x2_rev4.STL, duet2_+_duex5_mounting_bracket_x2_rev2.STL, fysetc_s6_mounting_bracket_with_motor_expander_x1_rev3.STL, fysetc_s6_mounting_bracket_x2_rev3.STL, fysetc_s6_mounting_bracket_x2_rev4.STL]
2021-05-25 reduce mounting hole count in panels for easier servicing
    [Back_Panel_200mm_Rev2.DXF, Back_Panel_200x200_Rev3.dxf, Back_Panel_250mm_Rev2.DXF, Back_Panel_250mm_x_250mm_x_300mm_Rev1.DXF, Back_Panel_250x250_Rev3.dxf, Back_Panel_250x250x300_Rev3.dxf, Back_Panel_300mm_Rev2.DXF, Back_Panel_300x300_Rev3.dxf]
2021-05-25 add extremely preliminary mag+ support (requires flipping the magswitch dock 180deg in the holder to work)
    [[a]_xy_carriage_mellow_mosquito_tool_mount_x1_rev1.STL, [a]_xy_carriage_std_fan_duct_1_x1_rev1.STL, [a]_xy_carriage_std_fan_duct_2_x1_rev1.STL]
2021-05-27 better rpi brackets
    [raspberrypi_mounting_bracket_for_heatsink_x1_rev1.STL, raspberrypi_mounting_bracket_x1_rev1.STL]
2021-05-27 add vertical variant of spider mounting bracket to allow dual controllers in standard electronics box
2021-05-29 shorten stack height of rpi bracket to better fit on k3 printers
2021-05-30 add vertical variant of rs-25-5 bracket
    [meanwell_rs_25_5_psu_mounting_bracket_horizontal_x1_rev2.STL]
2021-05-30 add spider with expander board mounting bracket, move skr to legacy folder
    [bigtreetech_skr_mounting_bracket_x2_rev4.STL]
2021-05-30 move skr and s6 v1.2 configs to legacy, update edrawing to use spider and btt expander
    [K1_bigtree_skr_1.3_config-250mm_x_250mm_x_250mm_build.cfg, K1_bigtree_skr_1.4_config-250mm_x_250mm_x_250mm_build.cfg, K1_fysetc_s6_1.2_config-250mm_x_250mm_x_250mm_build.cfg, K1_fysetc_s6_2.0_config-250mm_x_250mm_x_250mm_build.cfg]
2021-05-30 update s6 x2 config to match latest probe changes (annexed probe)
    please see discord for support
    [K1_fysetc_s6_2.0_config-250mm_x_250mm_x_250mm_build.cfg, K1_fysetc_s6_2.0_x2_config-250mm_x_250mm_x_250mm_build.cfg]
2021-05-30 add single s6 + btt motor expander configuration to github
    [K1_fysetc_s6_2.0_+_btt_motor_expander_config-250mm_x_250mm_x_250mm_build.cfg]
2021-05-30 remove unused comments
    [K1_fysetc_s6_2.0_+_btt_motor_expander_config-250mm_x_250mm_x_250mm_build.cfg, K1_fysetc_s6_2.0_x2_config-250mm_x_250mm_x_250mm_build.cfg]
2021-05-30 home to 0,0 not max,max
    [K1_fysetc_s6_2.0_+_btt_motor_expander_config-250mm_x_250mm_x_250mm_build.cfg, K1_fysetc_s6_2.0_x2_config-250mm_x_250mm_x_250mm_build.cfg]
2021-05-30 add spider + expander config
    [K1_fysetc_spider_+_btt_motor_expander_config-250mm_x_250mm_x_250mm_build.cfg]
2021-05-30 fix virtual endstop typo
    [K1_fysetc_spider_+_btt_motor_expander_config-250mm_x_250mm_x_250mm_build.cfg]
2021-05-30 bed mesh fade fix
    [K1_fysetc_s6_2.0_+_btt_motor_expander_config-250mm_x_250mm_x_250mm_build.cfg, K1_fysetc_s6_2.0_x2_config-250mm_x_250mm_x_250mm_build.cfg, K1_fysetc_spider_+_btt_motor_expander_config-250mm_x_250mm_x_250mm_build.cfg]
2021-05-31 bump post diameter on mounting bracket to fit better with case
    [raspberrypi_mounting_bracket_for_heatsink_horizontal_x1_rev3.STL, raspberrypi_mounting_bracket_for_heatsink_vertical_x1_rev2.STL]
2021-06-04 minor printability improvement to the bottom belted z idler
    [belted_z_idler_a_x4_rev1.STL, belted_z_idler_a_x4_rev2.STL, belted_z_idler_b_x4_rev1.STL, belted_z_idler_b_x4_rev2.STL]
2021-06-10 folded ascender support to toolhead, update ideamaker profiles
2021-06-11 R2 CAD
    [Brush+Purge_Bin_Assembly.x_t, Microswitch_Dock.x_t, Omron_Mag_Probe_Assembly.x_t, [a]_xy_mgn9h_shim_x4_rev1.STL, [a]_xy_mgn9h_top_cap_x4_rev1.STL, microswitch_probe_dock_support_arm_1_x2_rev1.STL, microswitch_probe_dock_support_arm_2_x1_rev1.STL, microswitch_probe_dock_support_arm_3_x1_rev1.STL]
2021-06-13 add print bed cad
    [K1+K2_Bed_200x200.x_t, K1+K2_Bed_250x250.x_t, K1+K2_Bed_300x300.x_t, K1+K2_Bed_350x350.x_t, K1+K2_Bed_400x400.x_t, K1+K2_Bed_450x450.x_t, K1+K2_Bed_500x500.x_t]
2021-07-08 update configs to use dockable probe code changes
    [K1_fysetc_s6_2.0_+_btt_motor_expander_config-250mm_x_250mm_x_250mm_build.cfg, K1_fysetc_s6_2.0_x2_config-250mm_x_250mm_x_250mm_build.cfg, K1_fysetc_spider_+_btt_motor_expander_config-250mm_x_250mm_x_250mm_build.cfg]
2021-07-08 add mag+ probe dock mounting arm 1
    [microswitch_probe_dock_support_arm_1_mag+_x2_rev1.STL]
2021-07-12 fan mount broke sub 5 minutes, make thicker
    [[a]_xy_carriage_fan_mount_1_x1_rev3.STL, [a]_xy_carriage_fan_mount_2_x1_rev3.stl]
2021-07-18 fix hole size (now 6mm) on tall motor xy tower
    [tall_motor_short_idler_mount_12mm_belts_x2_rev4.STL]
2021-07-28 remove old and obsolete jigs
    [[a]_1515_mgn9h_drilling_jig_x1_rev1.STL, [a]_mgn12_altz_rail_alignment_tool_x3_rev1.STL, [a]_mgn15_altz_rail_alignment_tool_x3_rev1.STL, [a]_mgn9_altz_rail_alignment_tool_x3_rev1.STL, [a]_mgn9_rail_install_tool_2040_x3_rev2.STL, [a]_xy_carriage_mag+_fan_duct_1_x1_rev1.STL, [a]_xy_carriage_mag+_fan_duct_2_x1_rev1.STL, microswitch_probe_dock_support_arm_1_mag+_x2_rev1.STL]
2021-07-31 update z accels and feed rates
    [K1_fysetc_s6_2.0_+_btt_motor_expander_config-250mm_x_250mm_x_250mm_build.cfg, K1_fysetc_s6_2.0_x2_config-250mm_x_250mm_x_250mm_build.cfg, K1_fysetc_spider_+_btt_motor_expander_config-250mm_x_250mm_x_250mm_build.cfg]
2021-07-31 add bosch extrusion variant of cable anchor
    [z_chain_anchor_bottom_bosch_x2_rev1.STL, z_chain_anchor_bottom_misumi_x2_rev3.STL, z_chain_anchor_top_bosch_x2_rev1.STL, z_chain_anchor_top_misumi_x2_rev3.STL]
2021-08-04 update rpi sensor config to non-deprecated method
    [K1_fysetc_s6_2.0_+_btt_motor_expander_config-250mm_x_250mm_x_250mm_build.cfg, K1_fysetc_s6_2.0_x2_config-250mm_x_250mm_x_250mm_build.cfg, K1_fysetc_spider_+_btt_motor_expander_config-250mm_x_250mm_x_250mm_build.cfg]
2021-08-04 homing retract distance = 0 on xy
    [K1_fysetc_s6_2.0_+_btt_motor_expander_config-250mm_x_250mm_x_250mm_build.cfg, K1_fysetc_s6_2.0_x2_config-250mm_x_250mm_x_250mm_build.cfg, K1_fysetc_spider_+_btt_motor_expander_config-250mm_x_250mm_x_250mm_build.cfg]
2021-08-09 add reliefs to corners of switch cutout
    [omron_d2f-5_microswitch_probe_body_x1_rev2.STL, omron_d2f-5_microswitch_probe_body_x1_rev3.STL]
2021-08-09 move planetaries and ballscrew z to deprecated folder
    [BF10_block_x4_rev1.STL, Back_Panel_200x200_Rev3.dxf, Back_Panel_250x250_Rev3.dxf, Back_Panel_250x250x300_Rev3.dxf, Back_Panel_300x300_Rev3.dxf, Back_Panel_350x350_Rev3.dxf, Back_Panel_400x400_Rev3.dxf, Back_Panel_400x400x600_Rev3.dxf]
2021-08-11 add mag+ toolhead edrawing
    [xy_carriage_mag+_bottom_frame_magswitch_probe_v2_x1_rev4.STL]
2021-08-11 2.0.1 compatible klipper config
    [K1_fysetc_s6_2.0_+_btt_motor_expander_config-250mm_x_250mm_x_250mm_build.cfg, K1_fysetc_s6_2.0_x2_config-250mm_x_250mm_x_250mm_build.cfg, K1_fysetc_spider_+_btt_motor_expander_config-250mm_x_250mm_x_250mm_build.cfg]
2021-08-16 wiring grommets are easier to print, assemble and install
    [bowden_grommet_nut_25mm_x_rev1.STL, bowden_grommet_screw_left_25mm_x_rev1.STL, bowden_grommet_screw_right_25mm_x_rev1.STL, wiring_grommet_nut_25mm_x2_rev1.STL, wiring_grommet_nut_25mm_x2_rev2.STL, wiring_grommet_nut_35mm_x1_rev1.STL, wiring_grommet_nut_35mm_x1_rev2.STL, wiring_grommet_screw_25mm_x2_rev3.STL]
2021-08-16 add experimental psu brackets
    [electronics_box_blanking_plate_x2_rev1.STL, electronics_box_te_power_inlet_x1_rev1.STL, universal_controller_mounting_bracket_a_x2_rev1.STL, universal_controller_mounting_bracket_b_x2_rev1.STL, universal_meanwell_lrs_psu_mounting_bracket_x2_rev1.STL, universal_meanwell_rs_psu_mounting_bracket_x2_rev1.STL, universal_meanwell_uhp_psu_mounting_bracket_x2_rev1.STL, universal_rpi_mounting_bracket_a_x2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]
2021-08-17 add readme to new electronics brackets folder
2021-08-19 tweak mag+ ducting to have better part cooling
    [[a]_xy_carriage_mag+_fan_duct_1_x1_rev1.STL, [a]_xy_carriage_mag+_fan_duct_1_x1_rev2.STL, [a]_xy_carriage_mag+_fan_duct_2_x1_rev1.STL, [a]_xy_carriage_mag+_fan_duct_2_x1_rev2.STL]
2021-08-20 mirror rpi bracket
    [universal_rpi_mounting_bracket_a_x2_rev1.STL, universal_rpi_mounting_bracket_a_x2_rev2.STL]
2021-08-21 make universal controller bracket 15mm longer
    [universal_controller_mounting_bracket_a_x2_rev1.STL, universal_controller_mounting_bracket_a_x2_rev2.STL]
2021-08-31 add new z drive, 15mm belt only, mgn12c only
    [3mm_stainless_belted_worm_z_metal_bottom_60to1_x4_rev1.DXF, 3mm_stainless_belted_worm_z_metal_top_60to1_x4_rev1.DXF, 4.8mm_aluminum_z_bearing_block_main_plate_x4_rev1.DXF, 4.8mm_aluminum_z_bearing_block_support_arm_x4_rev1.DXF, 60to1_z_drive_3_mirror_x2_rev1.STL, 60to1_z_drive_3_x2_rev1.STL, 60to1_z_drive_4_x4_rev1.STL, [a]_60to1_z_drive_1_mirror_x2_rev1.STL]
2021-08-31 small tweaks to 15mm z parts
    [4.8mm_aluminum_z_bearing_block_main_plate_x4_rev1.DXF, mgn12c_carriage_spacer_x4_rev1.STL]
2021-09-07 2.1 beta configs
    [K1_fysetc_s6_2.0_+_btt_motor_expander_config-250mm_x_250mm_x_250mm_build.cfg, K1_fysetc_s6_2.0_x2_config-250mm_x_250mm_x_250mm_build.cfg, K1_fysetc_spider_+_btt_motor_expander_config-250mm_x_250mm_x_250mm_build.cfg]
2021-09-14 z tilt typo
    [K1_fysetc_s6_2.0_+_btt_motor_expander_config-250mm_x_250mm_x_250mm_build.cfg, K1_fysetc_s6_2.0_x2_config-250mm_x_250mm_x_250mm_build.cfg, K1_fysetc_spider_+_btt_motor_expander_config-250mm_x_250mm_x_250mm_build.cfg]
2021-10-04 add 3mm stainless option for 15mm belted z - bearing blocks (for europeans)
    [3mm_stainless_z_bearing_block_main_plate_x4_rev1.DXF, 3mm_stainless_z_bearing_block_support_arm_x4_rev1.DXF, mgn12c_3mm_stainless_bearing_retainer_x4_rev1.STL, mgn12c_4.8mm_aluminum_bearing_retainer_x4_rev1.stl]
2021-10-29 update rpi_temperature to use temperature_host, as was deprecated
    [K1_fysetc_s6_2.0_+_btt_motor_expander_config-250mm_x_250mm_x_250mm_build.cfg, K1_fysetc_s6_2.0_x2_config-250mm_x_250mm_x_250mm_build.cfg, K1_fysetc_spider_+_btt_motor_expander_config-250mm_x_250mm_x_250mm_build.cfg]
2021-10-29 remove default parameters from config
    [K1_fysetc_s6_2.0_+_btt_motor_expander_config-250mm_x_250mm_x_250mm_build.cfg, K1_fysetc_s6_2.0_x2_config-250mm_x_250mm_x_250mm_build.cfg, K1_fysetc_spider_+_btt_motor_expander_config-250mm_x_250mm_x_250mm_build.cfg]
2021-11-02 archive 2.0.1, move 2.1 to main
    [3mm_stainless_belted_worm_z_metal_bottom_60to1_x4_rev1.DXF, 3mm_stainless_belted_worm_z_metal_top_60to1_x4_rev1.DXF, 3mm_stainless_z_bearing_block_main_plate_x4_rev1.DXF, 3mm_stainless_z_bearing_block_support_arm_x4_rev1.DXF, 4.8mm_aluminum_z_bearing_block_main_plate_x4_rev1.DXF, 4.8mm_aluminum_z_bearing_block_support_arm_x4_rev1.DXF, 60to1_z_drive_3_mirror_x2_rev1.STL, 60to1_z_drive_3_x2_rev1.STL]
2021-11-02 restore accidentally purged z drive to 2.0.1 archive folder
    [[a]_belted_z_tensioner_a1_x4_rev4.STL, [a]_belted_z_tensioner_a2_x4_rev4.STL, [a]_belted_z_tensioner_b1_x4_rev4.STL, [a]_belted_z_tensioner_b2_x4_rev4.STL, belted_z_idler_a_x4_rev2.STL, belted_z_idler_b_x4_rev2.STL, gantry_pivot_block_mgn15h_x4_rev1.STL]
2021-11-02 remove obsolete tools from repo
    [[a]_belted_z_install_jig_x1_rev1.STL]
2021-11-02 remove squashball foot
    [foot_to_frame_bracket_x4_rev2.STL, squash_ball_foot_x4_rev2.STL]
2021-11-02 fix electronics brackets hole alignment
    [[a]_universal_controller_mounting_bracket_b_x2_rev1.STL, [a]_universal_rpi_mounting_bracket_b_x2_rev1.STL, universal_controller_mounting_bracket_a_x2_rev2.STL, universal_controller_mounting_bracket_a_x2_rev3.STL, universal_rpi_mounting_bracket_a_x2_rev2.STL, universal_rpi_mounting_bracket_a_x2_rev3.STL]
2021-11-05 part orientation
    [mgn12c_carriage_spacer_x4_rev1.STL]
2021-11-27 add volcomosquito support
    [[a]_xy_carriage_volcomosquito_fan_duct_1_x1_rev1.STL, [a]_xy_carriage_volcomosquito_fan_duct_2_x1_rev1.STL, xy_carriage_volcomosquito_bottom_frame_magswitch_probe_x1_rev1.STL]
2021-11-27 add k1 R2.1 cad to github
2021-12-28 add preliminary support for sherpa micro and add dragon specific toolhead base (removes net mounting)
2021-12-29 add rapido standard flow and UHF hotend support
    [[a]_xy_carriage_fan_mount_1_x1_rev3.STL, [a]_xy_carriage_fan_mount_2_x1_rev3.stl, [a]_xy_carriage_mag+_fan_duct_1_x1_rev2.STL, [a]_xy_carriage_mag+_fan_duct_2_x1_rev2.STL, [a]_xy_carriage_mosquito_tool_mount_x1_rev4.STL, [a]_xy_carriage_rapido_standardflow_tool_mount_x1_rev1.STL, [a]_xy_carriage_rapido_uhf_tool_mount_x1_rev1.STL, [a]_xy_carriage_std_fan_duct_1_x1_rev1.STL]
2022-01-18 first rev of cable trunking (10mm fingers, 140mm long)
    [25x40mm_cable_channel_base_140mm_x3_rev1.STL, 25x40mm_cable_channel_clip_x21_rev1.STL, 25x40mm_cable_channel_top_140mm_x3_rev1.STL]
2022-01-19 add 2.1.1 full frame edrawing
2022-01-19 add self-centering feature to top of cable channel
    [25x40mm_cable_channel_top_140mm_x3_rev1.STL, 25x40mm_cable_channel_top_140mm_x3_rev2.STL]
2022-01-20 add 4040 callout for gantry members on k1
2022-01-22 fix 60:1 gear interference with metal top plate
    [3mm_stainless_belted_worm_z_metal_top_60to1_x4_rev2.DXF]
2022-01-25 stls for 2040 k2 frame
    [foot_to_frame_bracket_x4_rev3.STL]
2022-01-26 diamond electronics box corner
    [[a]_electronics_box_corner_x4_rev6.STL]
2022-02-01 reorient print orientation for power supply brackets (per kmobs)
    [universal_meanwell_lrs_psu_mounting_bracket_x2_rev1.STL, universal_meanwell_lrs_psu_mounting_bracket_x2_rev2.STL, universal_meanwell_rs_psu_mounting_bracket_x2_rev1.STL, universal_meanwell_rs_psu_mounting_bracket_x2_rev2.STL, universal_meanwell_uhp_psu_mounting_bracket_x2_rev1.STL, universal_meanwell_uhp_psu_mounting_bracket_x2_rev2.STL]
2022-02-08 1515 drilling jig, new rev
    [[a]_1515_mgn12_xy_cross_shortening_jig_x1_rev1.STL, [a]_1515_mgn12c_drilling_jig_x1_rev2.STL, [a]_1515_mgn12c_drilling_jig_x1_rev3.STL.stl]
2022-02-09 add 0.4mm nozzle option
2022-02-11 who would have thought a lrs-200 had m4 holes
    [universal_meanwell_lrs_psu_mounting_bracket_x2_rev2.STL, universal_meanwell_lrs_psu_mounting_bracket_x2_rev3.STL]
2022-02-16 dual uhp brackets
    [universal_dual_meanwell_uhp_psu_mounting_bracket_a_x1_rev2.STL, universal_dual_meanwell_uhp_psu_mounting_bracket_b_x1_rev2.STL]
2022-02-26 2.2.1 is now 2.2
    [25x40mm_cable_channel_base_140mm_x3_rev1.STL, 25x40mm_cable_channel_clip_x21_rev1.STL, 25x40mm_cable_channel_top_140mm_x3_rev2.STL, [a]_xy_carriage_fan_mount_1_x1_rev3.STL, [a]_xy_carriage_fan_mount_2_x1_rev3.stl, [a]_xy_carriage_mag+_fan_duct_1_x1_rev2.STL, [a]_xy_carriage_mag+_fan_duct_2_x1_rev2.STL, [a]_xy_carriage_mosquito_tool_mount_x1_rev4.STL]
2022-02-26 first draft new electrical box
    [[a]_electronics_box_back_panel_handle_x4_rev1.STL, [a]_electronics_box_side_panel_end_cap_switch_x1_rev1.STL, [a]_electronics_box_side_panel_end_cap_x7_rev1.STL, [a]_electronics_box_side_panel_mid_fan_guard_x4_rev1.STL, [a]_electronics_box_side_panel_mid_filler_x4_rev1.STL, electronics_box_corner_mains_inlet_x1_rev1.STL, electronics_box_corner_x3_rev1.STL, electronics_box_cover_x1_rev3.DXF]
2022-02-27 add bridging forgiveness to inlet top cutout
    [electronics_box_corner_mains_inlet_x1_rev1.STL, electronics_box_corner_mains_inlet_x1_rev2.STL]
2022-02-27 m3 insert was 5mm, now 4.7mm hole
    [[a]_electronics_box_corner_x4_rev6.STL, [a]_electronics_box_corner_x4_rev7.STL]
2022-02-28 easier to print fan guard
    [[a]_electronics_box_side_panel_mid_fan_guard_x4_rev1.STL, [a]_electronics_box_side_panel_mid_fan_guard_x4_rev2.STL]
2022-03-01 take material off filler panel
    [[a]_electronics_box_side_panel_mid_filler_x4_rev1.STL, [a]_electronics_box_side_panel_mid_filler_x4_rev2.STL]
2022-03-02 add note about mentals dockable probe module being required
    [K1_fysetc_s6_2.0_+_btt_motor_expander_config-250mm_x_250mm_x_250mm_build.cfg, K1_fysetc_s6_2.0_x2_config-250mm_x_250mm_x_250mm_build.cfg, K1_fysetc_spider_+_btt_motor_expander_config-250mm_x_250mm_x_250mm_build.cfg]
2022-03-02 exported wrong side panel (without brace in middle)
    [electronics_box_side_structural_panel_x4_rev1.DXF]
2022-03-22 fix missing fillet
    [electronics_box_blanking_plate_x2_rev1.STL, electronics_box_blanking_plate_x2_rev2.STL]
2022-04-11 match k2 configs
    [K1_fysetc_s6_2.0_+_btt_motor_expander_config-250mm_x_250mm_x_250mm_build.cfg, K1_fysetc_s6_2.0_x2_config-250mm_x_250mm_x_250mm_build.cfg, K1_fysetc_spider_+_btt_motor_expander_config-250mm_x_250mm_x_250mm_build.cfg]
2022-04-20 add T marker to top printed part, increase slot length from 6mm to 8mm on 15mm Z Drive
    [3mm_stainless_belted_worm_z_metal_bottom_60to1_x4_rev2.DXF, 3mm_stainless_belted_worm_z_metal_top_60to1_x4_rev3.DXF, 60to1_z_drive_3_mirror_x2_rev1.STL, 60to1_z_drive_3_mirror_x2_rev2.STL, 60to1_z_drive_3_x2_rev1.STL, 60to1_z_drive_3_x2_rev2.STL, [a]_60to1_z_drive_1_mirror_x2_rev1.STL, [a]_60to1_z_drive_1_mirror_x2_rev2.STL]
2022-04-20 actually slot motor to move 8mm
    [3mm_stainless_belted_worm_z_metal_top_60to1_x4_rev3.DXF]
2022-04-29 prevent z idler position from rotating...ever
    [60to1_z_drive_3_mirror_x2_rev2.STL, 60to1_z_drive_3_x2_rev2.STL, 60to1_z_drive_4_x4_rev1.STL, [a]_60to1_z_drive_1_mirror_x2_rev2.STL, [a]_60to1_z_drive_1_x2_rev2.STL, [a]_60to1_z_drive_2_mirror_x2_rev2.STL, [a]_60to1_z_drive_2_x2_rev2.STL, [a]_belt_tensioner_a_x8_rev1.STL]
2022-04-29 partial migration to quickdraw v2 (need new toolhead for complete migration)
    [[a]_omron_d2f-5_quickdraw_probe_body_v2_x1_rev1.STL, [a]_quickdraw_probe_dock_base_v2_x1_rev1.STL, [a]_quickdraw_probe_dock_fingers_v2_x1_rev1.STL, quickdraw_probe_dock_support_arm_1_mag+_x2_rev1.STL, quickdraw_probe_dock_support_arm_1_x2_rev1.STL, quickdraw_probe_dock_support_arm_2_x1_rev1.STL, quickdraw_probe_dock_support_arm_3_x1_rev1.STL]
2022-05-06 Create Foot_to_frame_bracket_laser_panel_x4_rev1.STL
    Added Foot to frame bracket used in combination with lasercut bottom panel.
    [Foot_to_frame_bracket_laser_panel_x4_rev1.STL]
2022-05-20 fix missing comment line on force move command
    [K1_fysetc_s6_2.0_+_btt_motor_expander_config-250mm_x_250mm_x_250mm_build.cfg, K1_fysetc_s6_2.0_x2_config-250mm_x_250mm_x_250mm_build.cfg, K1_fysetc_spider_+_btt_motor_expander_config-250mm_x_250mm_x_250mm_build.cfg]
2022-06-01 2.2 to main
    [25x40mm_cable_channel_base_140mm_x3_rev1.STL, 25x40mm_cable_channel_clip_x21_rev1.STL, 25x40mm_cable_channel_top_140mm_x3_rev2.STL, 3mm_stainless_belted_worm_z_metal_bottom_60to1_x4_rev2.DXF, 3mm_stainless_belted_worm_z_metal_top_60to1_x4_rev3.DXF, 3mm_stainless_z_bearing_block_main_plate_x4_rev1.DXF, 3mm_stainless_z_bearing_block_support_arm_x4_rev1.DXF, 4.8mm_aluminum_z_bearing_block_main_plate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]
2022-06-01 add r2.2 cad
    [Electronics_Box_Panels_04-21-2022.x_t]
2022-11-09 release 3 concept edrawing of gantry only
2022-11-18 wiring grommets did not have accent colors
    [[a]_wiring_grommet_screw_25mm_x3_rev3.STL, [a]_wiring_grommet_screw_left_35mm_x1_rev4.STL, [a]_wiring_grommet_screw_right_35mm_x1_rev4.STL, wiring_grommet_nut_25mm_x3_rev2.STL]
2022-11-18 grommet tweaks for printability, color changes for filament usage balance
    [[a]_electronics_box_corner_x4_rev7.STL, [a]_universal_controller_mounting_bracket_a_x2_rev3.STL, [a]_universal_rpi_mounting_bracket_a_x2_rev3.STL, [a]_wago_221_2x_mount_5_conductor_24VDC_x1_rev1.STL, [a]_wiring_grommet_screw_25mm_x3_rev3.STL, [a]_wiring_grommet_screw_25mm_x3_rev4.STL, [a]_wiring_grommet_screw_left_35mm_x1_rev4.STL, [a]_wiring_grommet_screw_left_35mm_x1_rev5.STL]
2022-11-18 move bed over. was off by 100mm
2022-11-18 more printable electronics box corners, now with less plastic
    [electronics_box_corner_mains_inlet_x1_rev2.STL, electronics_box_corner_mains_inlet_x1_rev3.STL, electronics_box_corner_x3_rev1.STL, electronics_box_corner_x3_rev2.STL]
2022-11-29 release 3.0 - super alpha stls and dxfs
    [[a]_fan_nozzle_mag+_combo_a_x1_rev1.STL, [a]_fan_nozzle_mag+_combo_b_x1_rev1.STL, bowden_guide_tube_x1_rev1.STL, cable_anchor_bottom_x1_rev1.STL, cable_anchor_mid_x1_rev1.STL, coupler_to_tower_alignment_tool_tycho_x2_rev1.STL, fan_bracket_x2_rev1_2mm_aluminum.DXF, fan_ducting_bottom_angle_x2_rev1.STL]
2022-12-01 r3 adjustments for clearance and shit
    [bowden_guide_tube_x1_rev1.STL, bowden_guide_tube_x1_rev2.STL, toolhead_main_plate_sherpa_mini_x2_rev2_2mm_aluminum.DXF]
2022-12-02 add dragon support
    [toolhead_main_plate_sherpa_mini_x2_rev3_2mm_aluminum.DXF]
2022-12-11 make grommets easier to print and thread
    [[a]_wiring_grommet_screw_25mm_x3_rev4.STL, [a]_wiring_grommet_screw_25mm_x3_rev5.STL, [a]_wiring_grommet_screw_left_35mm_x1_rev5.STL, [a]_wiring_grommet_screw_left_35mm_x1_rev6.stl, [a]_wiring_grommet_screw_right_35mm_x1_rev5.STL, [a]_wiring_grommet_screw_right_35mm_x1_rev6.STL, wiring_grommet_nut_25mm_x3_rev2.STL, wiring_grommet_nut_25mm_x3_rev3.STL]
2022-12-18 more clearance for longer screw to secure magnet
    [electronics_box_corner_mains_inlet_x1_rev3.STL, electronics_box_corner_mains_inlet_x1_rev4.STL, electronics_box_corner_x3_rev2.STL, electronics_box_corner_x3_rev3.STL]
2023-02-04 move beacon mount to 2.6mm from nozzle per recommendations
    [[a]_fan_nozzle_mag+_combo_a_x1_rev1.STL, [a]_fan_nozzle_mag+_combo_b_x1_rev1.STL, [a]_fan_nozzle_mag+_waterheater_combo_a_x1_rev2.STL, [a]_fan_nozzle_mag+_waterheater_combo_b_x1_rev2.STL]
2023-02-20 fix small mirroring error in part (cutouts)
    [toolhead_main_plate_sherpa_mini_x2_rev4_2mm_aluminum.DXF]
2023-04-04 R3 beta1 prep
    [25x40mm_cable_channel_base_140mm_x3_rev1.STL, 25x40mm_cable_channel_clip_x21_rev1.STL, 25x40mm_cable_channel_top_140mm_x3_rev2.STL, 3mm_stainless_belted_worm_z_metal_bottom_60to1_x4_rev2.DXF, 3mm_stainless_belted_worm_z_metal_top_60to1_x4_rev3.DXF, 3mm_stainless_z_bearing_block_main_plate_x4_rev1.DXF, 3mm_stainless_z_bearing_block_support_arm_x4_rev1.DXF, 4.8mm_aluminum_z_bearing_block_main_plate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]
2023-05-02 R3 bed pdfs
2023-07-05 waterheater duct "final", remove qd2 support for now
    [[a]_fan_nozzle_mag+_waterheater_combo_a_x1_rev2.STL, [a]_fan_nozzle_mag+_waterheater_combo_b_x1_rev2.STL, [a]_omron_d2f-5_quickdraw_probe_body_v2_x1_rev1.STL, [a]_quickdraw_probe_dock_base_v2_x1_rev1.STL, [a]_quickdraw_probe_dock_fingers_v2_x1_rev1.STL, quickdraw_probe_dock_support_arm_1_mag+_x2_rev1.STL, quickdraw_probe_dock_support_arm_1_x2_rev1.STL, quickdraw_probe_dock_support_arm_2_x1_rev1.S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]
2023-07-05 actually rev the ducting
    [[a]_fan_nozzle_mag+_waterheater_combo_a_x1_rev3.STL, [a]_fan_nozzle_mag+_waterheater_combo_b_x1_rev3.STL]
2023-09-23 update bed to support tri-z
2023-10-04 Release 3.0 cad prep
    [60to1_z_drive_3_mirror_x2_rev2.STL, 60to1_z_drive_3_x2_rev2.STL, 60to1_z_drive_4_x4_rev1.STL, [a]_60to1_z_drive_1_mirror_x2_rev2.STL, [a]_60to1_z_drive_1_x2_rev2.STL, [a]_60to1_z_drive_2_mirror_x2_rev2.STL, [a]_60to1_z_drive_2_x2_rev2.STL, [a]_belt_tensioner_a_x8_rev1.STL]
2023-10-27 migrate printer, extruder and board configs to an MIT licensed repo
    [K1_S6_Sample_config.g, K1_bigtree_skr_1.3_config-250mm_x_250mm_x_250mm_build.cfg, K1_bigtree_skr_1.4_config-250mm_x_250mm_x_250mm_build.cfg, K1_fysetc_s6_1.2_config-250mm_x_250mm_x_250mm_build.cfg, K1_fysetc_s6_2.0_+_btt_motor_expander_config-250mm_x_250mm_x_250mm_build.cfg, K1_fysetc_s6_2.0_config-250mm_x_250mm_x_250mm_build.cfg, K1_fysetc_s6_2.0_x2_config-250mm_x_250mm_x_250mm_build.cfg, K1_fys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]
2023-11-26 Create Rapido_UHF_XY_Carriage_Horizontal_Rails - Top Level Assembly.rar
2024-04-17 Final CAD drop
    [K1+K2 Carabiner for Mosquito-B_Cu.gbr, K1+K2 Carabiner for Mosquito-B_Mask.gbr, K1+K2 Carabiner for Mosquito-B_Paste.gbr, K1+K2 Carabiner for Mosquito-B_Silkscreen.gbr, K1+K2 Carabiner for Mosquito-Edge_Cuts.gbr, K1+K2 Carabiner for Mosquito-F_Cu.gbr, K1+K2 Carabiner for Mosquito-F_Mask.gbr, K1+K2 Carabiner for Mosquito-F_Paste.gbr]
